robotarmyllc/light-play/media/poster-1.png

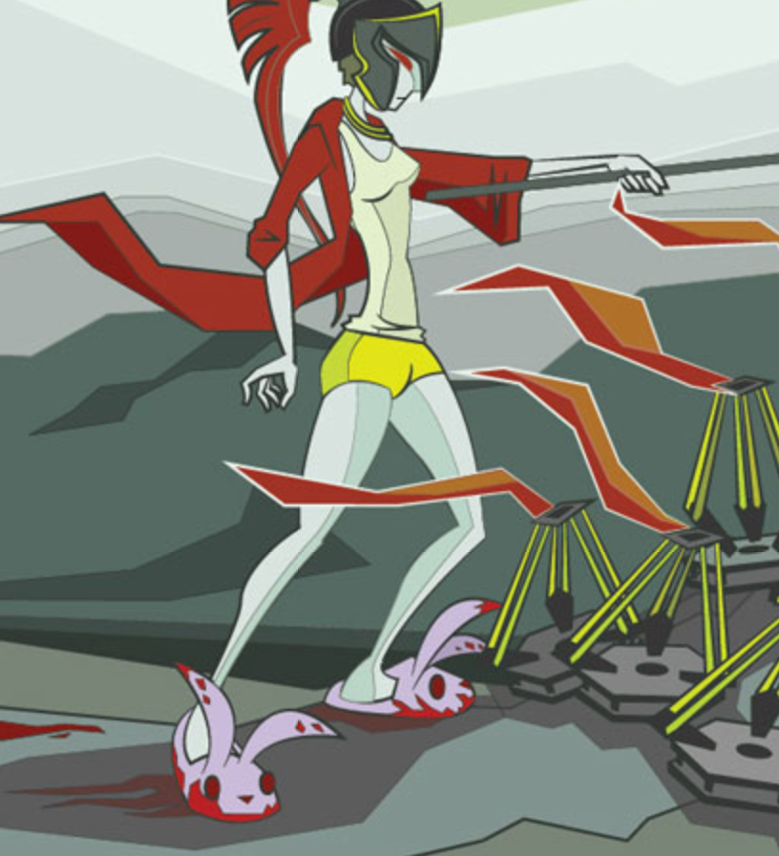
media/poster-1.png
