robotarmyllc/light-play/hardware/kit/kit-parts-images/IMG_5173.jpg

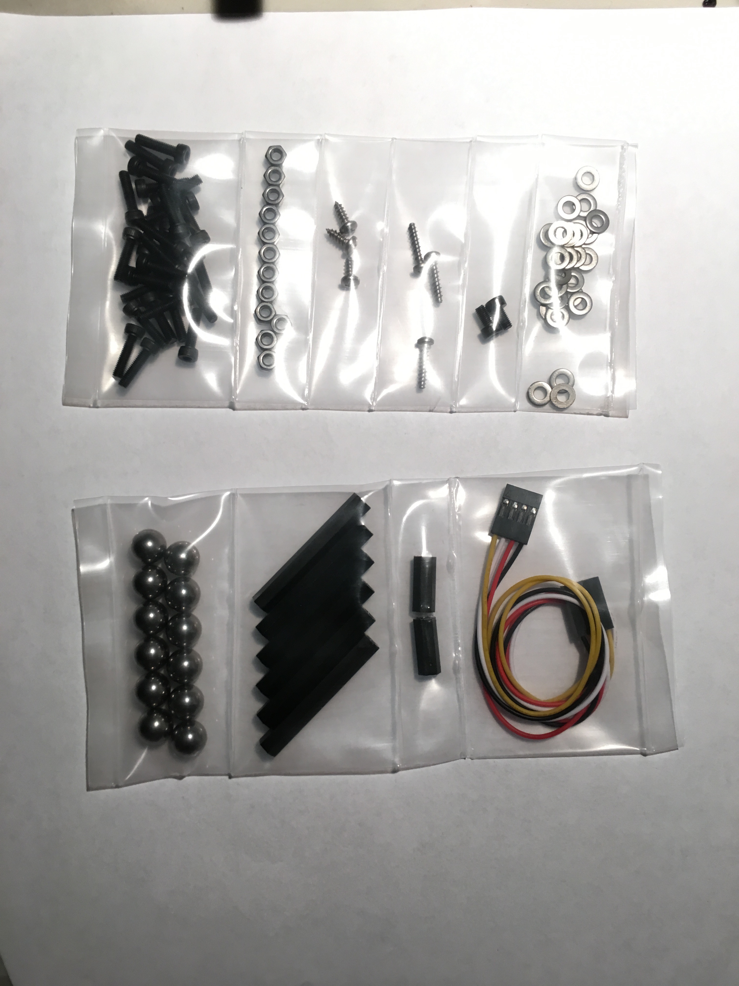
hardware/kit/kit-parts-images/IMG_5173.jpg
