robotarmyllc/light-play/README.md

# light-play
All files related to the Light Play (2013) delta robot project.
