robotarmyllc/light-play/hardware/brain-board/documents/RevB-RevC-Notes.txt

Rev B --> Rev C

Calculate size of cap to run uC at 50mA for 100mS

[DONE] Power diode

[DONE] Remove one of the I2C
[DONE] Rename I2c  --> I/O  (4-pin)

[DONE] LED resistors -->  220

[DONE] More Bypass Caps.    0.01uF,   1000uf?

[DONE] Rotate SPI header

[NOT-DO] Two 470uF versus one 1000uF size on board?

[DONE] Change Serial 6P header to Vert.

[DONE] Better marking on header pin 1.

[DONE] RTS jumper for serial

[ADDED] Test whether 10uF on reset line can make Arduino programming still work.
