robotarmyllc/light-play/mechanical/acrylic-base/RS-Fab/Lower.pdf

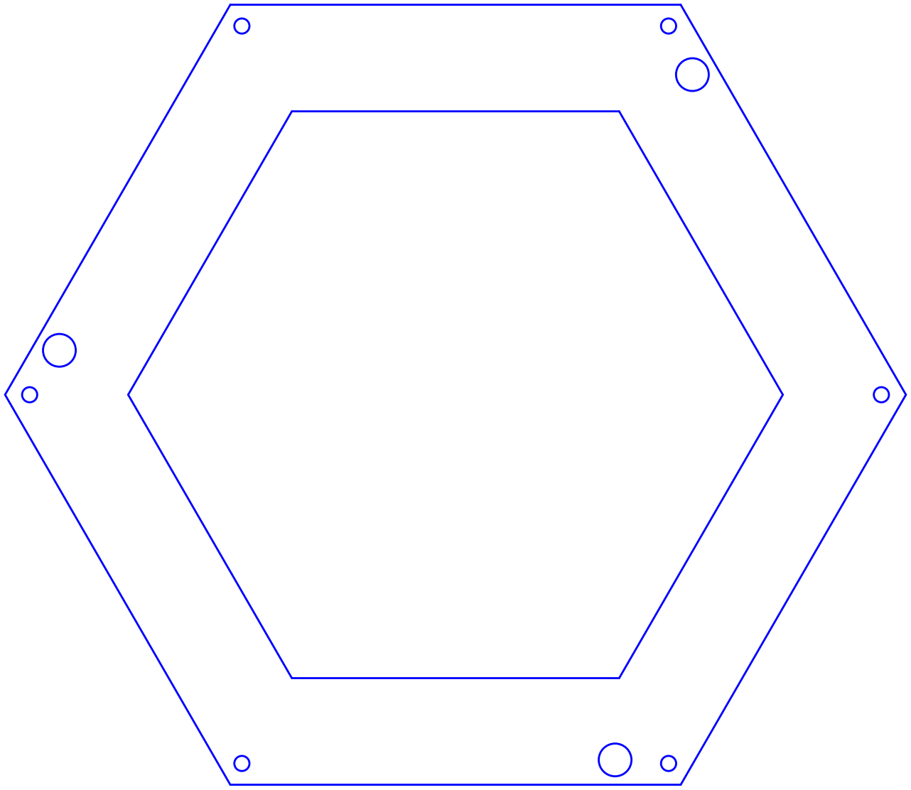
[picture p3: figure]
