robotarmyllc/light-play/mechanical/acrylic-base/RS-Fab/Upper.pdf

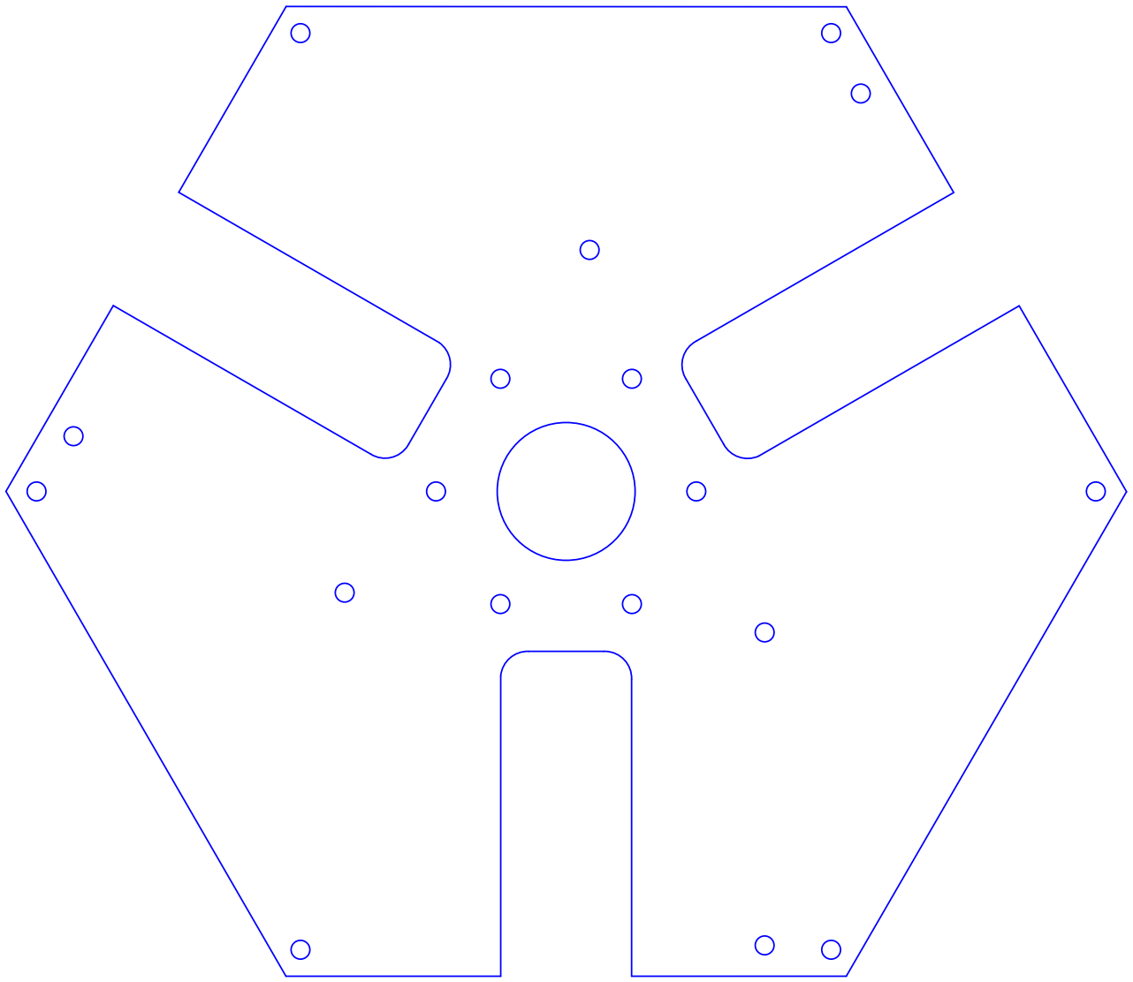
[picture p4: figure]
