robotarmyllc/light-play/hardware/kit/led-pcb/data-sheets/PLCC-6.jpg

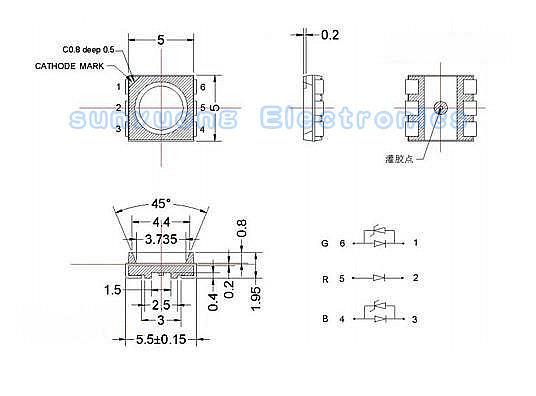
hardware/kit/led-pcb/data-sheets/PLCC-6.jpg
