robotarmyllc/light-play/media/deltaFLYER-01.png

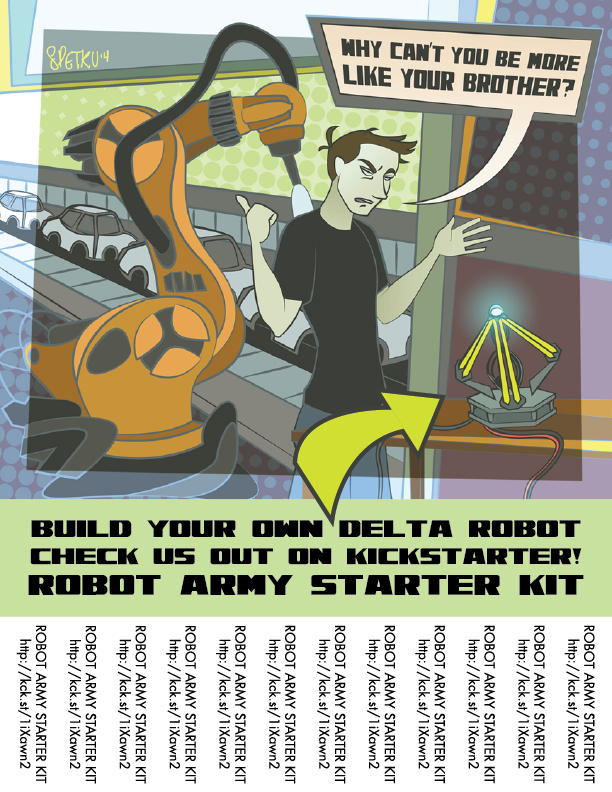
media/deltaFLYER-01.png
