robotarmyllc/light-play/media/kickstarter-1-day-left.png

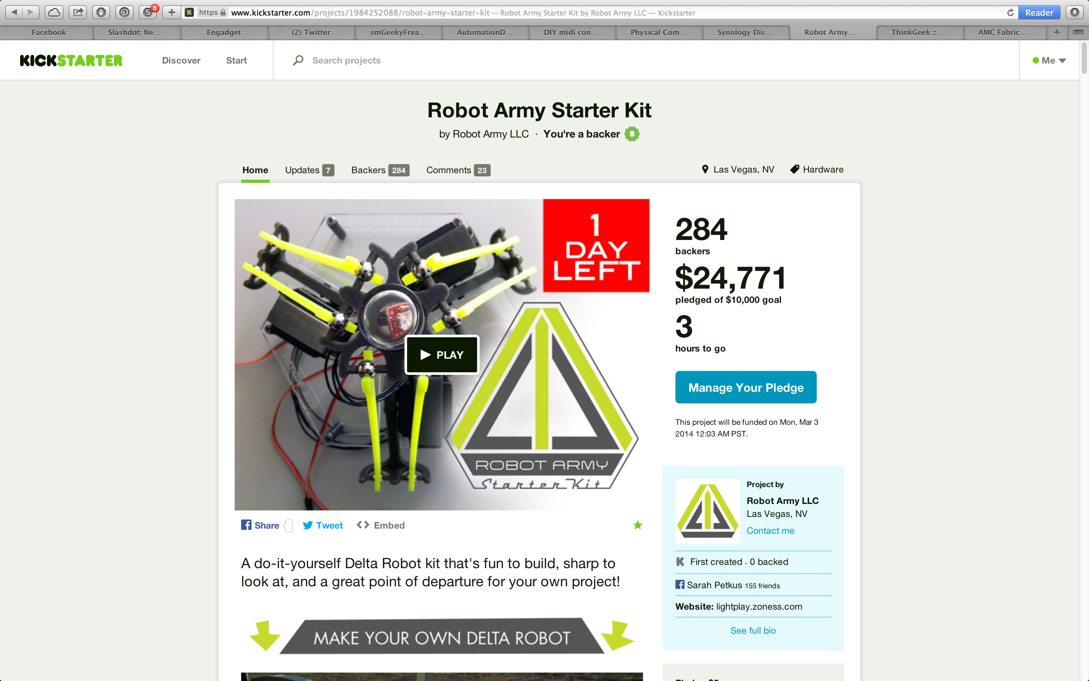
media/kickstarter-1-day-left.png
