robotarmyllc/light-play/media/kickstarter-4-days-left.png

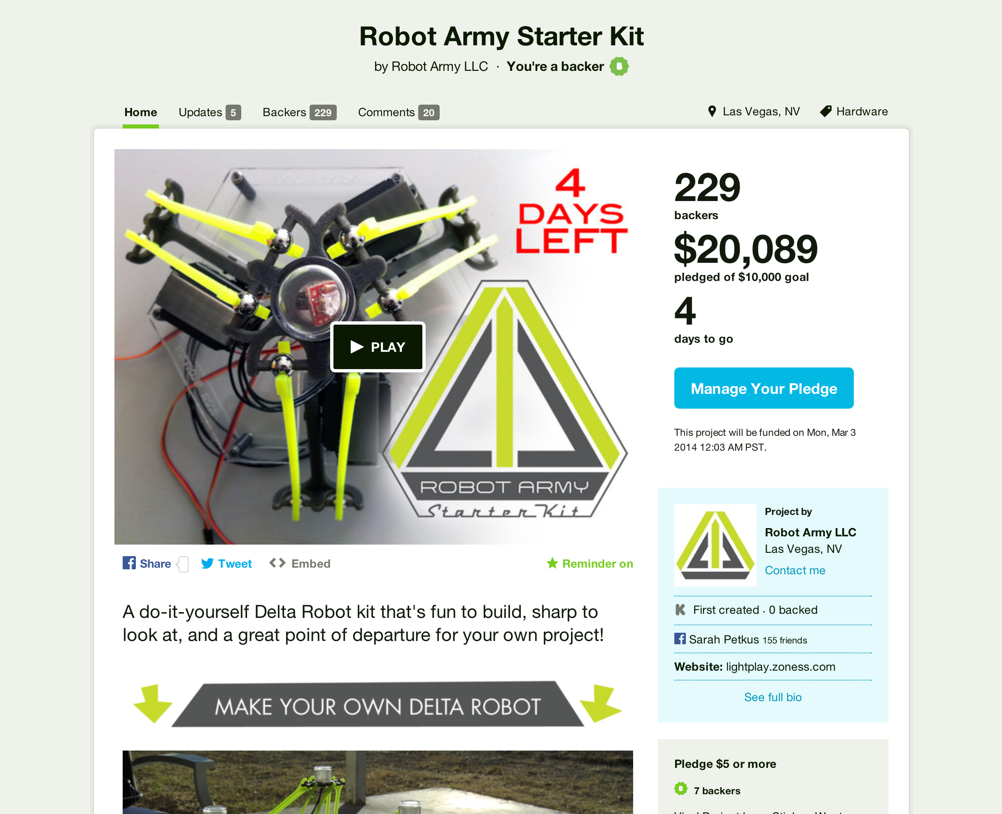
media/kickstarter-4-days-left.png
