robotarmyllc/light-play/software/Flow/Robot/src/com/robotarmy/flow/widget/colorpicker.png

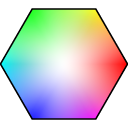
software/Flow/Robot/src/com/robotarmy/flow/widget/colorpicker.png
