robotarmyllc/light-play/hardware/kit/RobotArmy-Kit-BOM.ods

Sheet: Kit Level
Bill of Materials - Kit Level
QTY | ITEM | DESC | COST | EXT COST | HAVE | TO BUY | SOURCE
3 | HD-3001HB | Servo | $8.00 | $24.00 | 8 | 60 | Pololu
1 | BASE PAIR | Acrylic Base Set | $6.00 | $6.00 | 45 | 0 | RS Fab
1 | Screw Pack | Hardware, Screws | $3.39 | $3.39 | 3 | 20 | In House
1 | Ball Pack | Hardware, Balls, Spacers | $1.74 | $1.74 | 0 | 20 | In House
1 | Circuit Pack | PCBs, LED + MainBoard | $14.25 | $14.25 | ? |  | In House
1 | Plastics | Plastic Pieces | $3.20 | $3.20 | ? | 20 | In House
1 | Instruction Sheet | Instruction Card | $0.10 | $0.10 |  | 20 | In House
1 | Battery | Battery Box | $2.00 | $2.00 |  | 20 | In House
 |  |  | Total Cost: | $54.68

Sheet: Screw Pack
Screw Pack
 |  |  |  |  |  | 20
QTY | ITEM | DESC | COST | EXT COST | HAVE | NEED | TO BUY | SOURCE
3 |  | #4 x 1/2” Tap Screw | $0.060 | $0.180 | 80 | 60 | -20 | McMaster 97975A115
26 |  | M3 x 12 | $0.080 | $2.080 | 0 | 520 | 520 | McMaster 91290A117
2 |  | M3 x 6 | $0.080 | $0.160 | 0 | 40 | 40 | McMaster 91290A111
12 |  | M3 Nut | $0.015 | $0.180 | 0 | 240 | 240 | McMaster 90591A121
26 |  | M3 Washer | $0.017 | $0.442 | 0 | 520 | 520 | McMaster 91166A210
3 |  | #4 x 5/16” Pan | $0.050 | $0.150 | 0 | 60 | 60 | McMaster 92470A109
1 |  | 2.5mm Allen Wrench | $0.200 | $0.200 | 0 | 20 | 20 | McMaster 7289A13
 |  |  | Total Cost: | 3.392

Sheet: Ball Pack
Ball Pack
 |  |  |  |  |  | 20
QTY | ITEM | DESC | COST | EXT COST | HAVE | NEED | TO BUY | SOURCE
12 |  | 3/8 Ball Bearing | $0.03 | $0.30 | 0 | 240 | 240 | McMaster 96455K54
6 |  | M3 x 40 Spacer | $0.09 | $0.54 | 450 | 120 | -330 | Ali Express
2 |  | M3 x 15 Spacer | $0.20 | $0.40 | 100 | 40 | -60 | Ali Express
1 |  | 4-pin Wire Harness | $0.50 | $0.50 | 20 | 20 | 0 | Ali Express
 |  |  | Total Cost: | $1.74

Sheet: Circuit Pack
Circuit Pack – Main Board and LED Board
 |  |  |  |  |  | 20
QTY | ITEM | DESC | COST | EXT COST | HAVE | NEED | TO BUY | SOURCE
1 | Brain | Brain PCB Assy. | $13.25 | $13.25 | 20 | 20 | 0
1 | LED | LED PCB Assy | $1.00 | $1.00 | 5 | 20 | 15
 |  |  | Total Cost: | $14.25

Sheet: PlasticPack
Plastic Pack – Plastic Items
 |  |  |  |  |  | 20
QTY | ITEM | DESC | COST | EXT COST | HAVE | NEED | TO BUY | SOURCE
3 | Paddle | Grey Paddle | $0.25 | $0.75 | 0 | 60 | 60
6 | Arm | Yellow Arm | $0.25 | $1.50 | 0 | 120 | 120
1 | Effector | Grey Effector | $0.25 | $0.25 | 0 | 20 | 20
6 | ServoMount | Grey Servo Mount | $0.10 | $0.60 | 0 | 120 | 120
1 | Dome | LED Dome | $0.10 | $0.10 | 500 | 20 | -480 | Vending Supply
 |  |  | Total Cost: | $3.20
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
