robotarmyllc/light-play/hardware/dmx-cat5-board/documents/bom.ods

RS-485 |  | Rev. B
Part | Value | Device | Package | 100 | 1000 | 2000 | Inventory | Ordered
FAB | RS-485 FAB |  |  | $1.700 | $1.200 | $0.500 | 21 | 04/11/14 | OSH
C1 | 0.1uF | CAPACITOR0603 | 603 | $0.080 | $0.040 | $0.013 | Y
J1 | 03P_ED1515-ND | 03P_ED1515-ND | TB35-03 | $0.200 | $0.180 | $0.250 | Y
J2 | 03P_ED1515-ND | 03P_ED1515-ND | TB35-03 | $0.200 | $0.180 | $0.250 | Y
J3 | Header, 6P, F | FE06-1 | FE06 | $0.100 | $0.060 | $0.020 | 200 | 04/11/14 | Tayda
R1 | 120 | RESISTOR1206 | 1206 | $0.050 | $0.010 | $0.003 | 200
R2 | 100 | RESISTOR1206 | 1206 | $0.050 | $0.010 | $0.003 | 200
R3 | 4.7K | RESISTOR0603 | 603 | $0.003 | $0.003 | $0.003 | Y
U3 | SN65176B | RS485_TRANSCEIVERSO8 | SOP08 | $0.800 | $0.500 | $0.450 |  |  | Mouser
 |  |  | Parts: | $3.18 | $2.18 | $1.49
 |  |  | Procurement: | $0.48 | $0.33 | $0.15
N Parts: | 9 |  | Assembly: | $1.98 | $1.62 | $1.44
 |  |  | Prog. & Test: | $1.00 | $0.75 | $0.50
 |  |  | Total: | $6.64 | $4.88 | $3.58
