robotarmyllc/light-play/hardware/dmx-a-board/documents/dmx-a-rev-b-bom.ods

DMX-A Rev.B Bill of Materials
Part | Value | Package | Description | HAVE?
C1 | 0.1uF | 603 | Capacitor CAP | Y
C2 | 0.1uF | 603 | Capacitor CAP | Y
J1 | FCI 54602 | FCI_54602 | RJ45 Unshielded | 27
J2 | FCI 54602 | FCI_54602 | RJ45 Unshielded | 27
J3 | Molex 53015-0410 | RA | Molex MicroBlade 4P | 100
J4 | Molex 53015-0310 | RA | Molex MicroBlade 3P | 100
J5 | 5569-02XX | RA | MiniFit Jr. 2-pin | NEED
R1 | 100 | 1206 | Resistor | Y
U1 | 74HC2G34GV | TSOP-6 | 74HC2G34 - Dual Driver | Y
U2 | ST485 | SOP08 | RS485 TRANSEIVER | Y
