robotarmyllc/light-play/hardware/brain-board/documents/BOM.ods

BrainPCB | Rev. E
Part | Value | Device | Package | 500 | 1000 | 2000 | Inventory | Ordered
FAB | Brain_FAB |  |  | $1.700 | $1.500 | $0.980 | 20
ADDR | CTS_219-04MST | Dip-switch, SMD | CTS_4P_GULLWING | $0.270 | $0.270 | $0.270 | 400
C1 | 0.1uF | CAPACITOR0603 | 603 | $0.013 | $0.013 | $0.013 | Y
C2 | 0.1uF | CAPACITOR0603 | 603 | $0.013 | $0.013 | $0.013 | y
C3 | 0.1uF | CAPACITOR0603 | 603 | $0.013 | $0.013 | $0.013 | y
C4 | 0.01uF | CAPACITOR0603 | 603 | $0.013 | $0.013 | $0.013 | y
C5 | 10uF | CAPACITOR0805 | 805 | $0.013 | $0.013 | $0.013 | y
C6 | 1000uF/6.3V NS | CAPACITOR_POL-ALUM-SMT-6.3 | 6.3MM | $0.013 | $0.013 | $0.013 | y
D1 | Toshiba 1SS416CT | SCHOTTKYTOSHIBA_CST2 | CST2 | $0.040 | $0.040 | $0.040 | y
D13 | YEL | SMT0603 | SMD_0603 | $0.100 | $0.100 | $0.100 | y
CR1 | 16MHz Resonator | RESONATOR MURATA-CSTCE | MURATA-CSTCE | $0.310 | $0.270 | $0.250 | y | 04/10/14
ISCP | Header, 3x2P, VT | MA03-2 | MA03-2 | $0.040 | $0.040 | $0.040 | Y
SERIAL | Header, 6P, VT | MA06-1 | MA06-1 | $0.050 | $0.015 | $0.015 | Y
LEDS | Header, 4P, VT | MA04-1 | MA04-1 | $0.020 | $0.020 | $0.020 | Y
JMP1 | Header, 2P, VT | MA02-1 | MA02-1 | $0.020 | $0.020 | $0.020 | Y
JMP2 | Header, 2P, VT | MA02-1 | MA02-1 | $0.020 | $0.020 | $0.020 | Y
PWR | Header, 3P | MA03-1 | MA03-1 | $0.020 | $0.020 | $0.020 | Y
SV1 | Header, 3P, VT | MA03-1 | MA03-1 | $0.015 | $0.015 | $0.015 | y
SV2 | Header, 3P, VT | MA03-1 | MA03-1 | $0.015 | $0.015 | $0.015 | y
SV3 | Header, 3P, VT | MA03-1 | MA03-1 | $0.015 | $0.015 | $0.015 | y
Q1 | 2N7002 | SOT23_2N7002 | SOT-23 | $0.080 | $0.070 | $0.060 | y | 04/10/14
R1 | 10K | RESISTOR0603 | 603 | $0.003 | $0.003 | $0.003 | Y
R2 | 10K | RESISTOR0603 | 603 | $0.003 | $0.003 | $0.003 | Y
R3 | CTS 741X163821JP | RESNET_0402_INDIV_X8 | RESNET_0402_X8 | $0.100 | $0.080 | $0.061 | y | 04/10/14
RESET | Switch, Push, SMD | PUSHBTN-SP-MOM-4PINB3SN | B3SN | $0.100 | $0.100 | $0.100 | y
U1 | ATmega328P-AU | ATMEGA328 | TQFP-32-08 | $1.620 | $1.620 | $1.620 | y | 21 - 04/10/2014 | Need 400
 |  |  | Parts: | $4.62 | $4.31 | $3.75
 |  |  | Procurement: | $0.69 | $0.65 | $0.37
N Parts: | 27 |  | Assembly: | $5.94 | $4.86 | $4.32
 |  |  | Prog. & Test: | $2.00 | $1.50 | $1.00
 |  |  | Total: | $13.25 | $11.32 | $9.44
