robotarmyllc/light-play/hardware/kit/kit-parts-images/IMG_5172.jpg

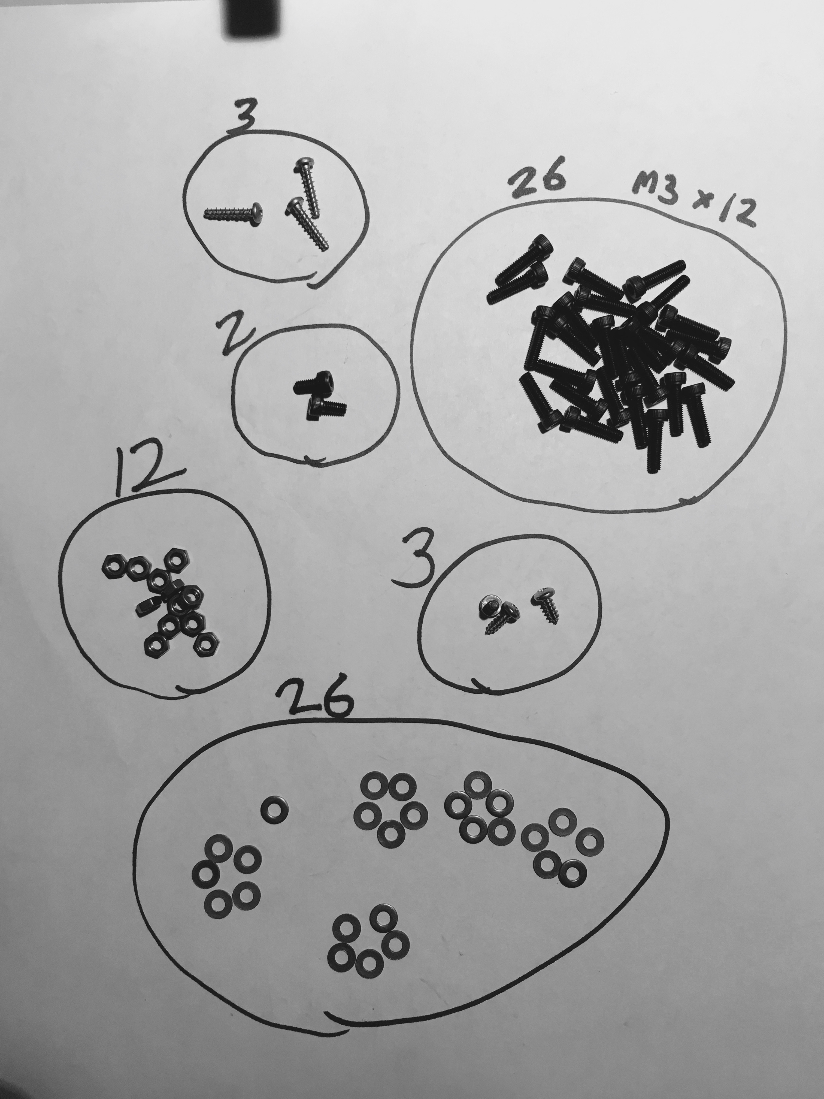
hardware/kit/kit-parts-images/IMG_5172.jpg
