robotarmyllc/light-play/hardware/kit/kit-parts-images/IMG_5174.jpg

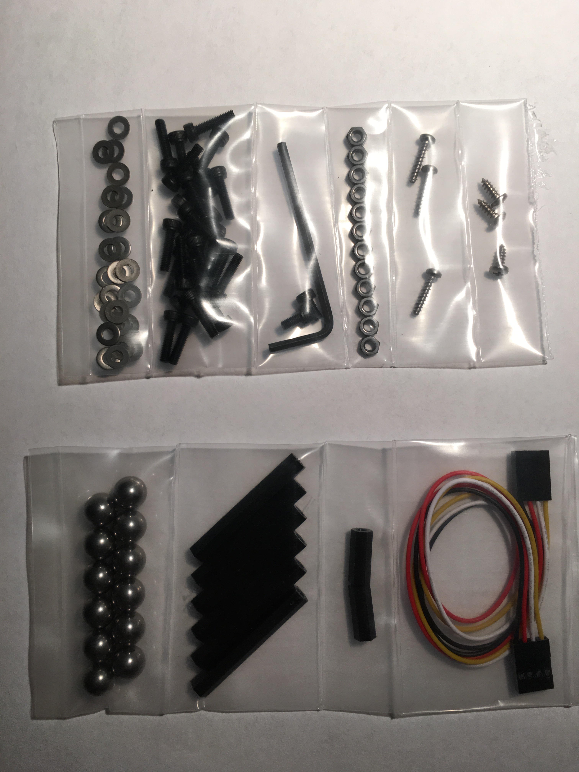
hardware/kit/kit-parts-images/IMG_5174.jpg
