robotarmyllc/light-play/events/MakerFaire2016/Pedastal/Pedastal01-lid.stl

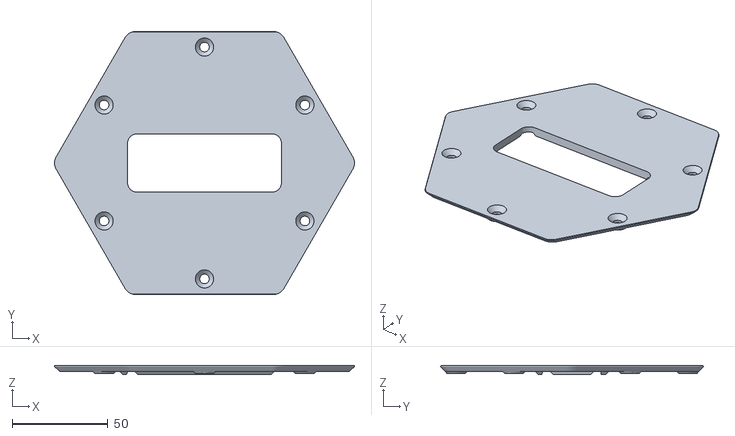
[picture p12: CAD file, 2022-09-13]
events/MakerFaire2016/Pedastal/Pedastal01-lid.stl
156.9 x 137.6 x 4.50
