robotarmyllc/light-play/hardware/black-light-stands/BlackLightStand.stl

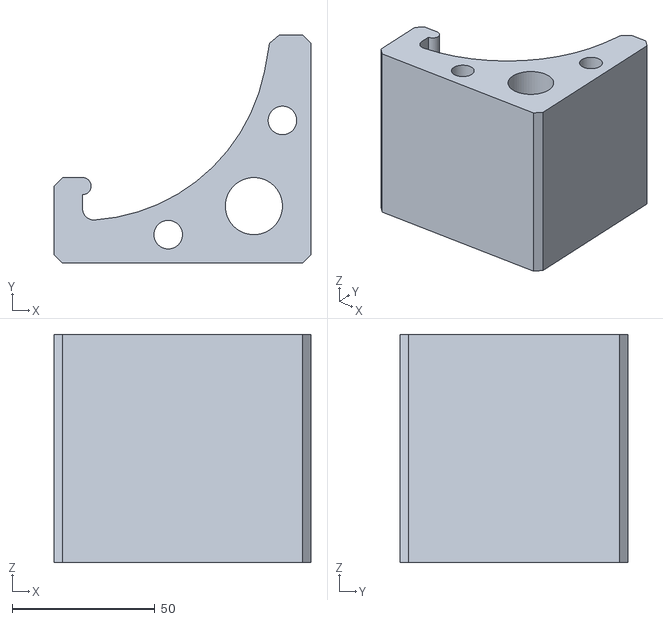
[picture p13: CAD file, 2022-09-13]
hardware/black-light-stands/BlackLightStand.stl
90.0 x 80.0 x 80.0
