robotarmyllc/light-play/mechanical/2013-12-14_STL_files/armX.stl

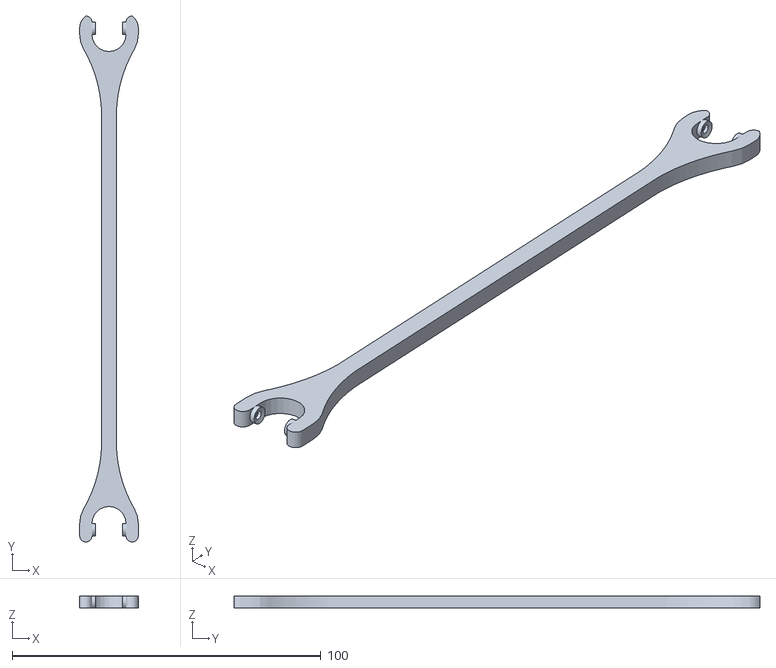
[picture p14: CAD file, 2022-09-13]
mechanical/2013-12-14_STL_files/armX.stl
19.0 x 170.4 x 4.00
