robotarmyllc/light-play/mechanical/acrylic-base/RobotArmy-4x8-sheet.dxf

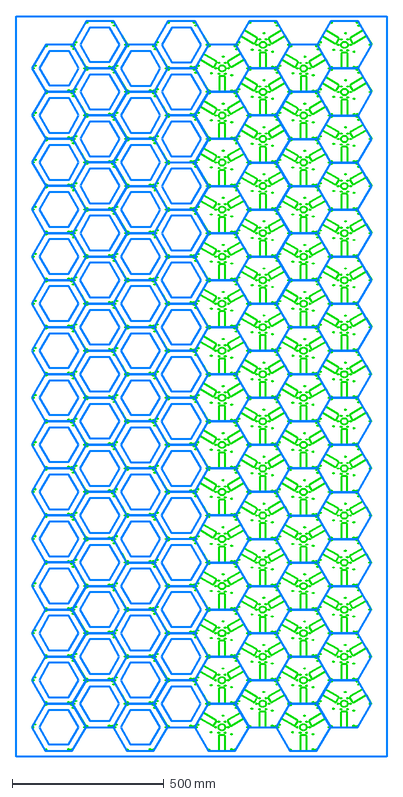
[picture p15: CAD file, 2022-09-13]
mechanical/acrylic-base/RobotArmy-4x8-sheet.dxf
1219.2 x 2438.4 mm
