robotarmyllc/light-play/mechanical/acrylic-base/RS-Fab/RobotArmy-Upper.dxf

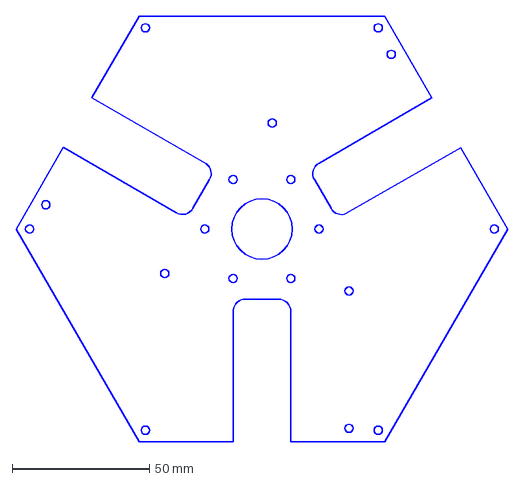
[picture p16: CAD file, 2022-09-13]
mechanical/acrylic-base/RS-Fab/RobotArmy-Upper.dxf
178.9 x 155.0 mm
