robotarmyllc/light-play/mechanical/Arm/Arm Curved-2019 v2.stl

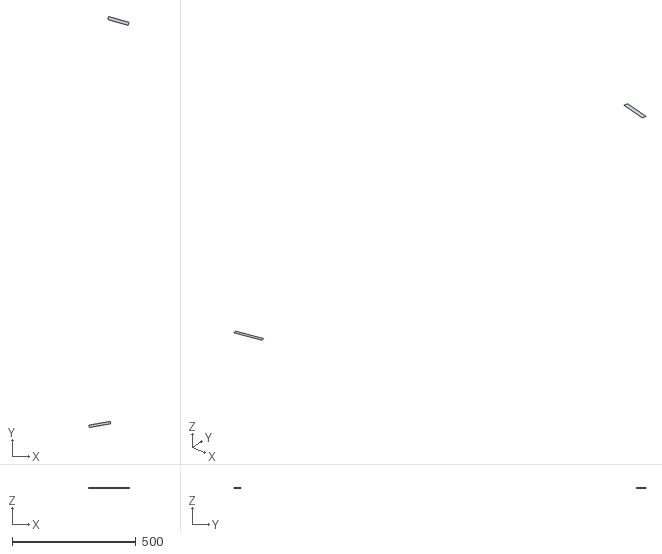
[picture p17: CAD file, 2022-09-13]
mechanical/Arm/Arm Curved-2019 v2.stl
161.8 x 1658.3 x 0.2
