robotarmyllc/light-play/mechanical/final-3d-print-stl-for-kits/armCurved.stl

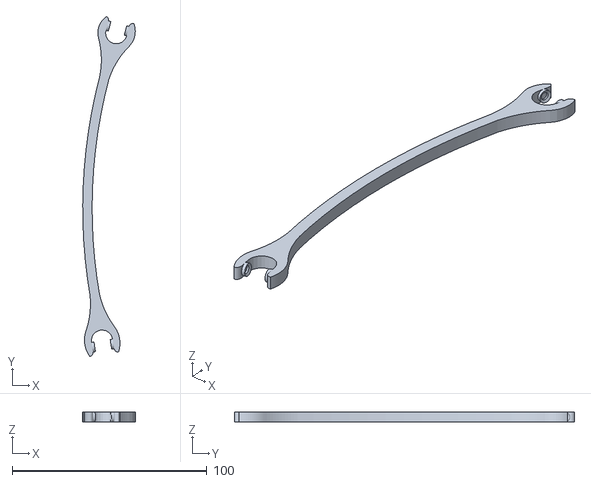
[picture p18: CAD file, 2022-09-13]
mechanical/final-3d-print-stl-for-kits/armCurved.stl
27.0 x 174.7 x 5.00
