robotarmyllc/light-play/mechanical/gallery-palettes/Palette-ABS/Original-DXF/comb_3.dxf

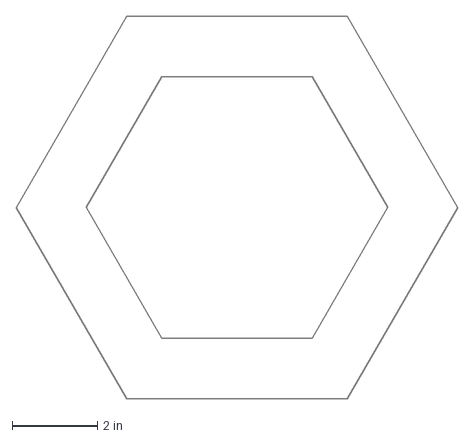
[picture p19: CAD file, 2022-09-13]
mechanical/gallery-palettes/Palette-ABS/Original-DXF/comb_3.dxf
10.4 x 9.00 in
