robotarmyllc/light-play/mechanical/gallery-palettes/Palette3/DMX-A-bracket_v02.stl

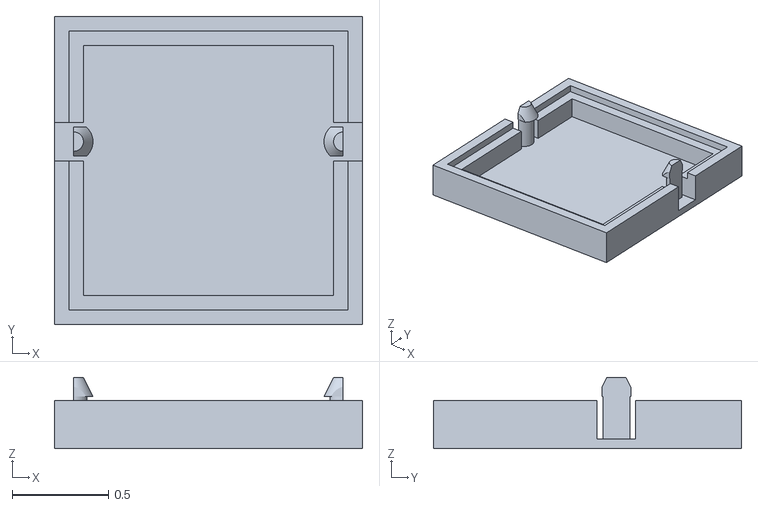
[picture p20: CAD file, 2022-09-13]
mechanical/gallery-palettes/Palette3/DMX-A-bracket_v02.stl
1.60 x 1.60 x 0.37
