robotarmyllc/light-play/mechanical/misc-3D/ball-cap.stl

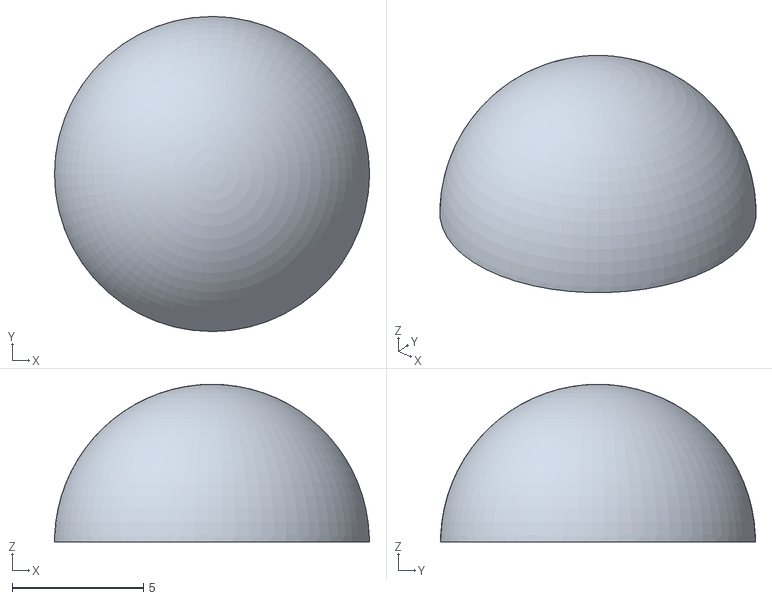
[picture p21: CAD file, 2022-09-13]
mechanical/misc-3D/ball-cap.stl
12.0 x 12.0 x 6.00
