robotarmyllc/light-play/mechanical/Paddle/paddle-latest.stl

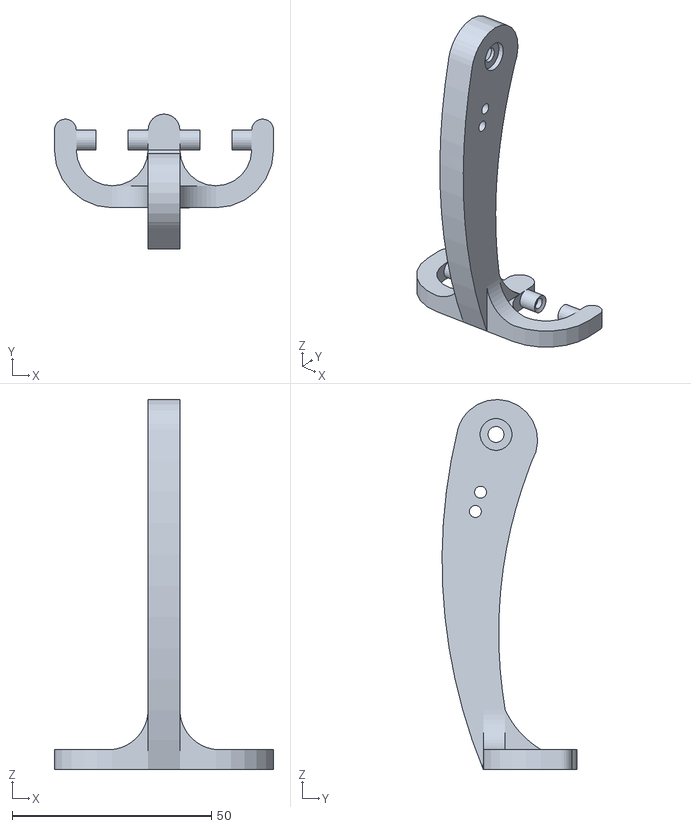
[picture p22: CAD file, 2022-09-13]
mechanical/Paddle/paddle-latest.stl
55.0 x 33.8 x 92.8
