robotarmyllc/light-play/mechanical/Spacer/spacer_36mm.stl

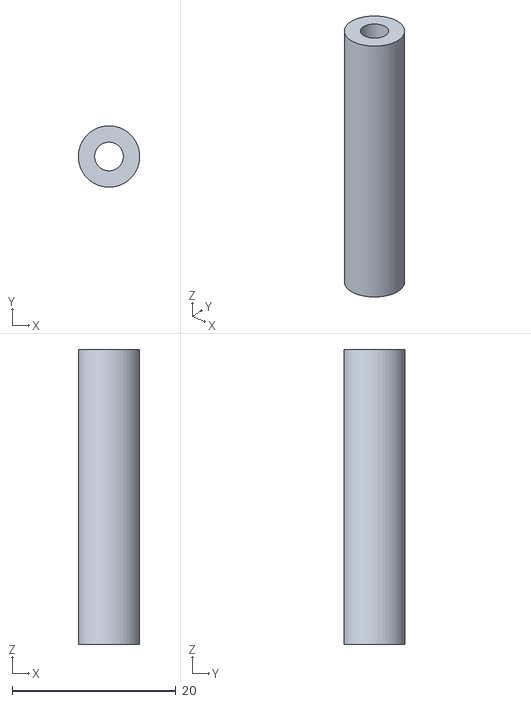
[picture p23: CAD file, 2022-09-13]
mechanical/Spacer/spacer_36mm.stl
7.50 x 7.50 x 36.0
