robotarmyllc/light-play/events/MakerFaire2016/Pedastal/P-test1.stl

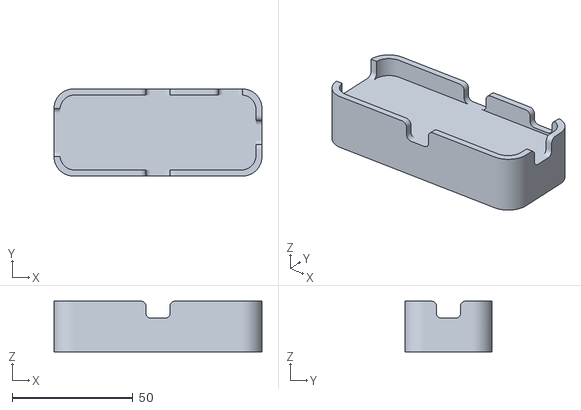
[picture p24: CAD file, 2022-09-13]
events/MakerFaire2016/Pedastal/P-test1.stl
86.0 x 36.0 x 21.0
