robotarmyllc/light-play/mechanical/2013-12-14_STL_files/effectorX.stl

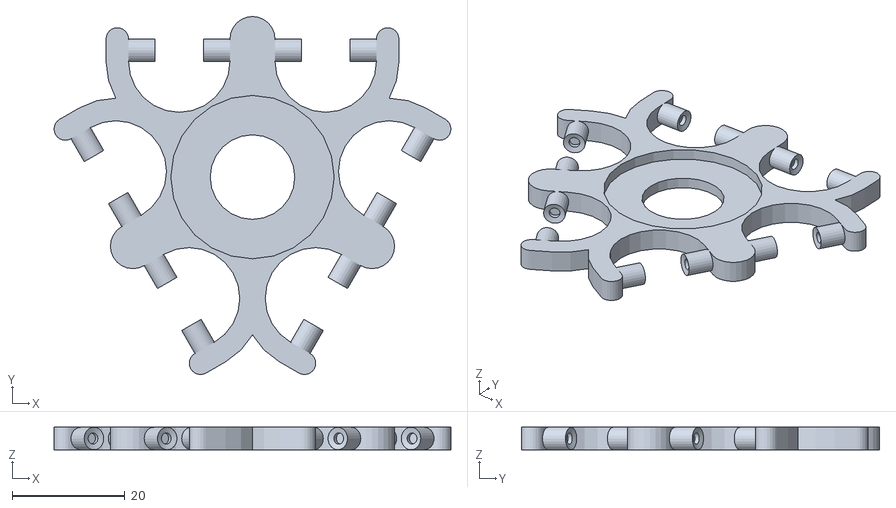
[picture p25: CAD file, 2022-09-13]
mechanical/2013-12-14_STL_files/effectorX.stl
70.4 x 63.5 x 4.00
