robotarmyllc/light-play/mechanical/acrylic-base/RS-Fab/RobotArmy-Lower.dxf

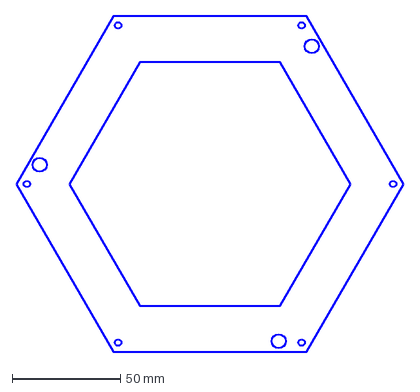
[picture p26: CAD file, 2022-09-13]
mechanical/acrylic-base/RS-Fab/RobotArmy-Lower.dxf
178.9 x 154.9 mm
