robotarmyllc/light-play/mechanical/final-3d-print-stl-for-kits/effector.stl

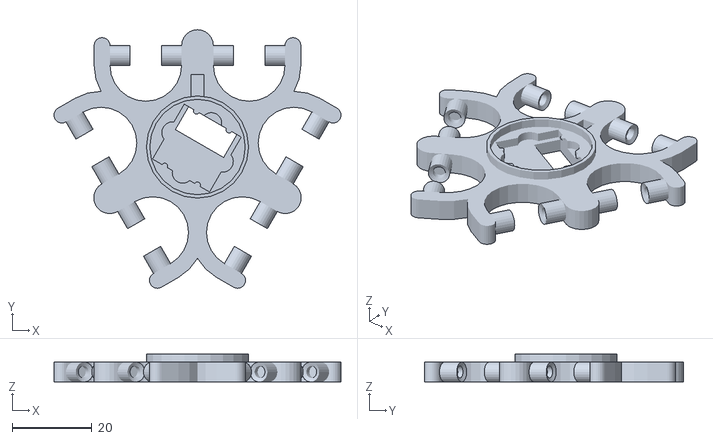
[picture p27: CAD file, 2022-09-13]
mechanical/final-3d-print-stl-for-kits/effector.stl
72.2 x 65.0 x 7.00
