robotarmyllc/light-play/mechanical/gallery-palettes/Palette-ABS/Original-DXF/comb_1.dxf

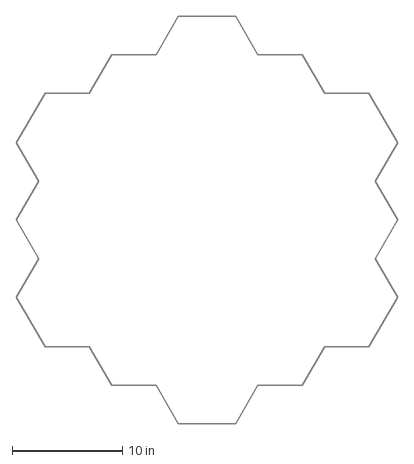
[picture p28: CAD file, 2022-09-13]
mechanical/gallery-palettes/Palette-ABS/Original-DXF/comb_1.dxf
34.6 x 37.0 in
