robotarmyllc/light-play/mechanical/gallery-palettes/Palette-ABS/Quote-DXF/comb_3.dxf

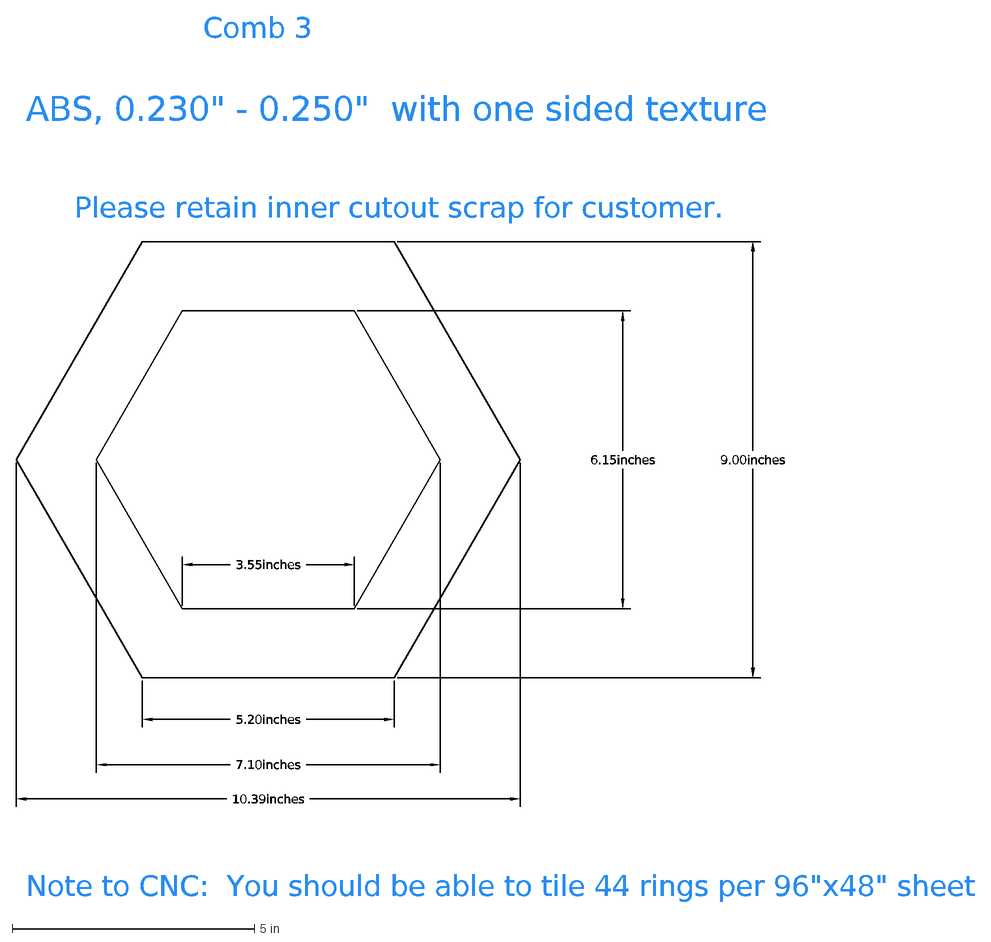
[picture p29: CAD file, 2022-09-13]
mechanical/gallery-palettes/Palette-ABS/Quote-DXF/comb_3.dxf
9.00inches
6.15inches
7.10inches
10.39inches
5.20inches
3.55inches
Comb 3
Please retain inner cutout scrap for customer.
ABS, 0.230" - 0.250" with one sided texture
Note to CNC: You should be able to tile 44 rings per 96"x48" sheet
