robotarmyllc/light-play/mechanical/gallery-palettes/Palette3/AC-Inlet-v01b.stl

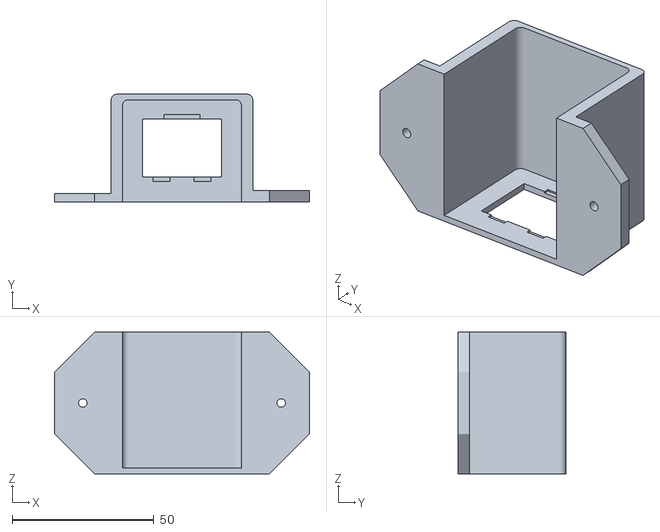
[picture p30: CAD file, 2022-09-13]
mechanical/gallery-palettes/Palette3/AC-Inlet-v01b.stl
90.0 x 38.0 x 50.0
