robotarmyllc/light-play/mechanical/misc-3D/dome1.stl

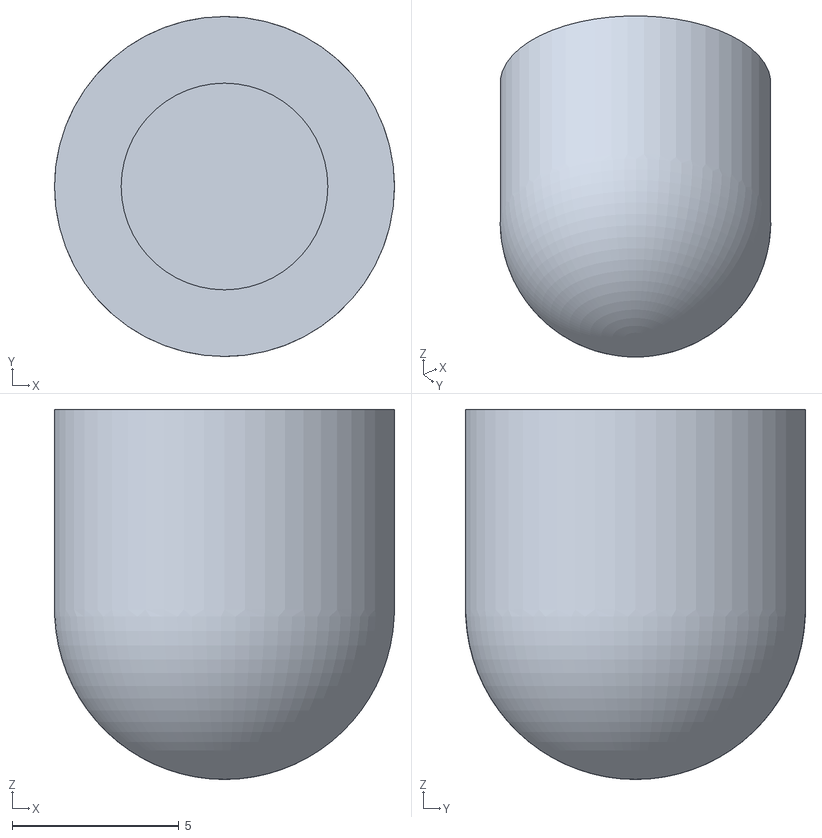
[picture p31: CAD file, 2022-09-13]
mechanical/misc-3D/dome1.stl
10.2 x 10.2 x 11.1
