robotarmyllc/light-play/mechanical/Paddle/anchor.stl

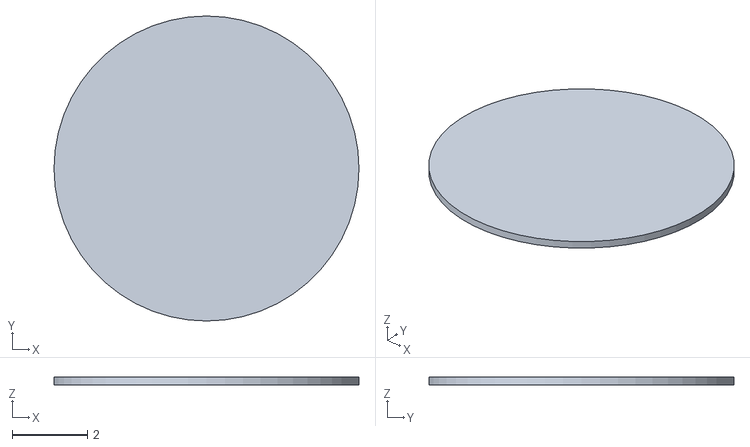
[picture p32: CAD file, 2022-09-13]
mechanical/Paddle/anchor.stl
8.10 x 8.10 x 0.2
