robotarmyllc/light-play/events/MakerFaire2016/Pedastal/Pedastal01.stl

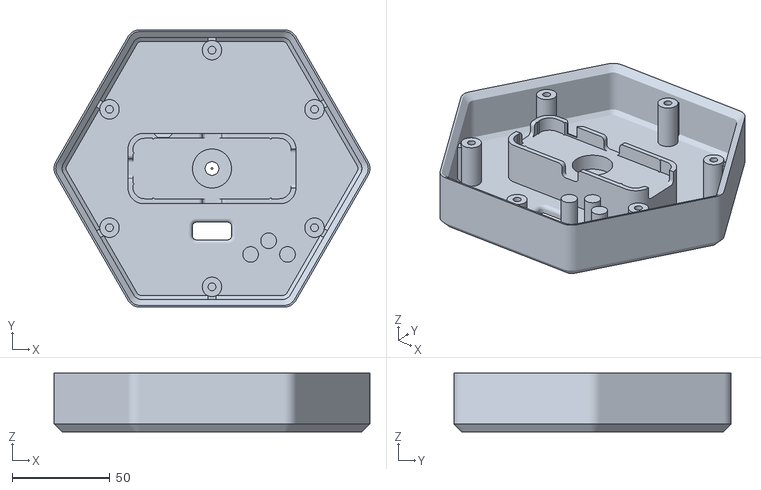
[picture p33: CAD file, 2022-09-13]
events/MakerFaire2016/Pedastal/Pedastal01.stl
161.8 x 142.0 x 30.0
