robotarmyllc/light-play/mechanical/2013-12-14_STL_files/bracketX.stl

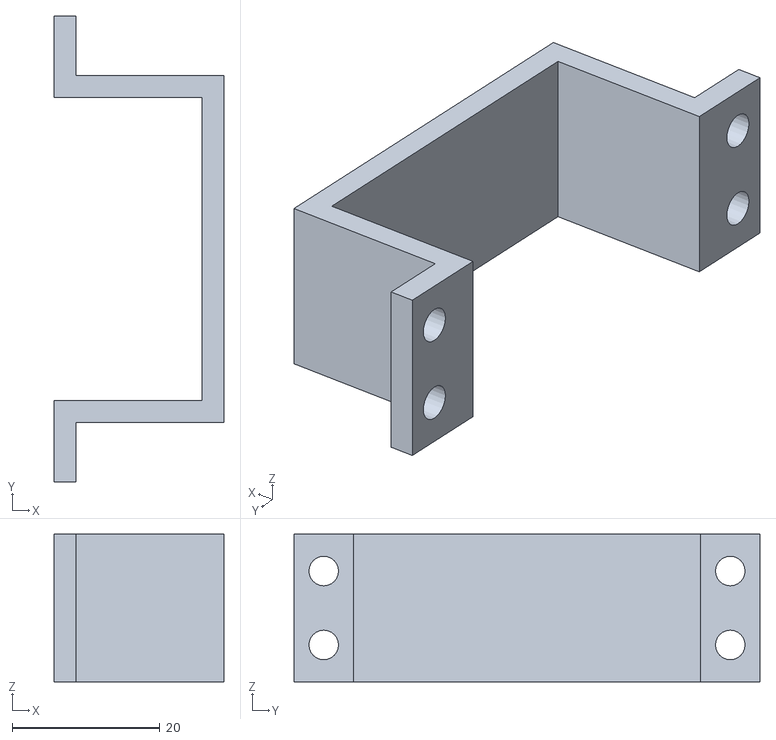
[picture p34: CAD file, 2022-09-13]
mechanical/2013-12-14_STL_files/bracketX.stl
23.0 x 63.0 x 20.0
