robotarmyllc/light-play/mechanical/gallery-palettes/Palette3/board_cover_v03.stl

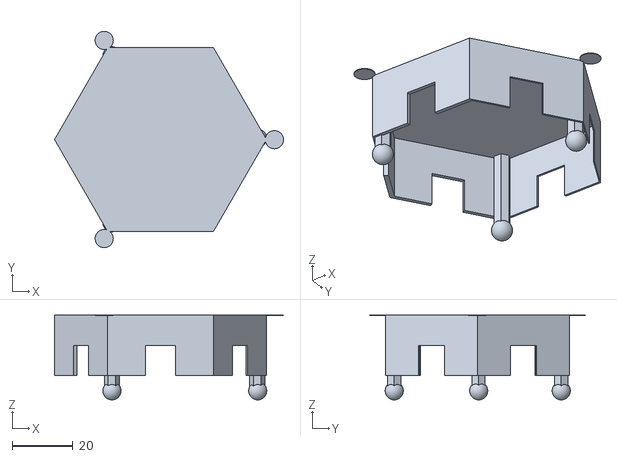
[picture p36: CAD file, 2022-09-13]
mechanical/gallery-palettes/Palette3/board_cover_v03.stl
75.6 x 71.4 x 28.0
