robotarmyllc/light-play/mechanical/Paddle/paddle-160514.stl

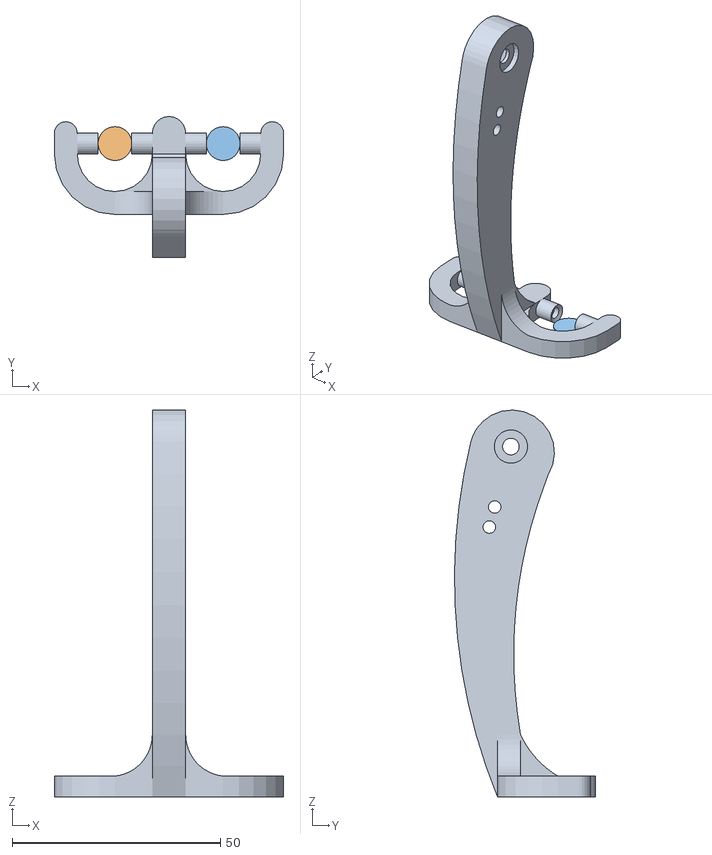
[picture p37: CAD file, 2022-09-13]
mechanical/Paddle/paddle-160514.stl
55.0 x 33.8 x 92.8
