robotarmyllc/light-play/mechanical/2013-12-14_STL_files/paddleX.stl

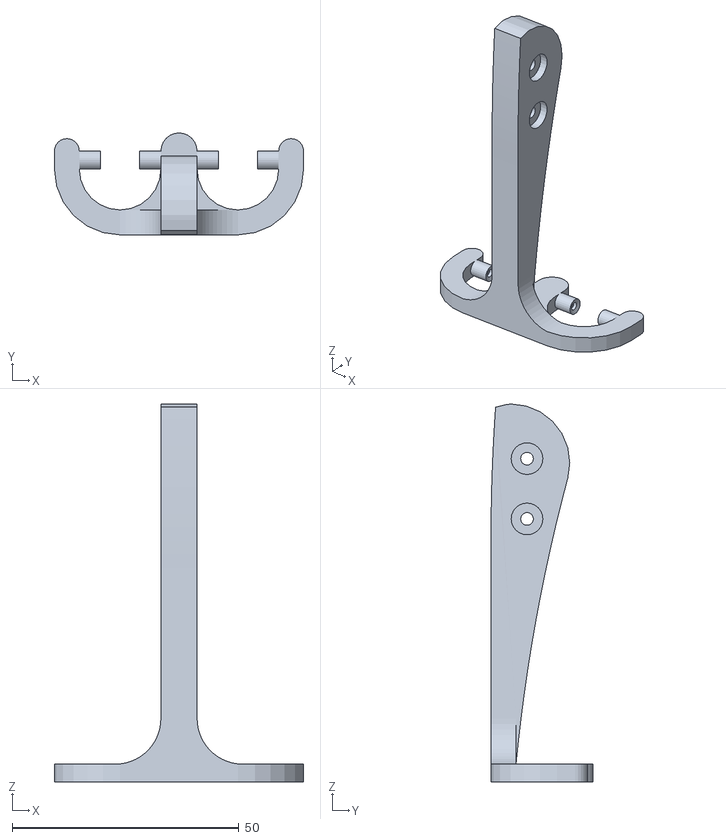
[picture p38: CAD file, 2022-09-13]
mechanical/2013-12-14_STL_files/paddleX.stl
55.0 x 22.5 x 83.4
