robotarmyllc/light-play/mechanical/final-3d-print-stl-for-kits/servo_mount.stl

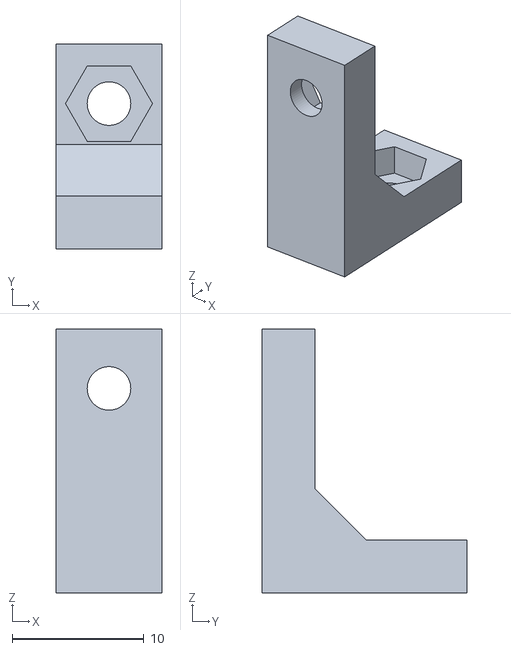
[picture p39: CAD file, 2022-09-13]
mechanical/final-3d-print-stl-for-kits/servo_mount.stl
8.00 x 15.5 x 20.0
