robotarmyllc/light-play/mechanical/2013-12-14_STL_files/spacer34.stl

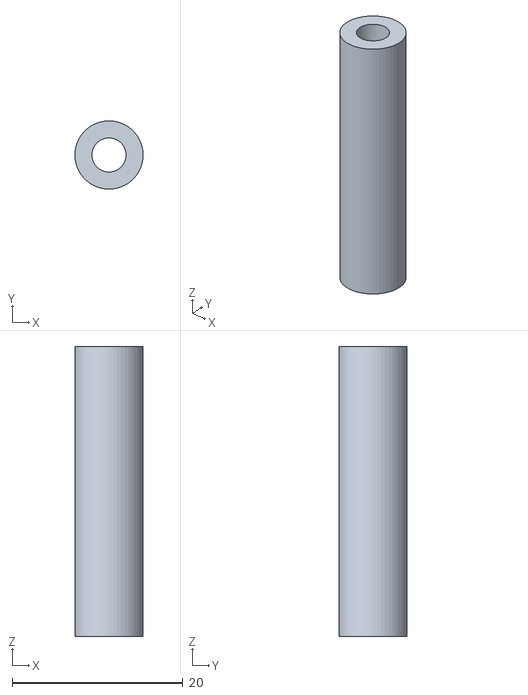
[picture p40: CAD file, 2022-09-13]
mechanical/2013-12-14_STL_files/spacer34.stl
8.00 x 8.00 x 34.0
