robotarmyllc/light-play/mechanical/gallery-palettes/Palette3/Template-PowerSuppy_v01.stl

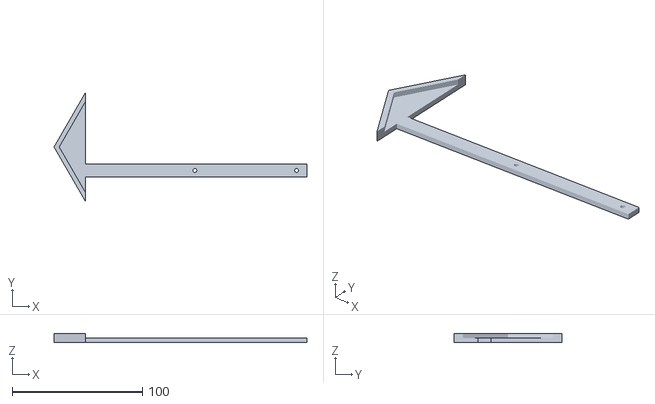
[picture p41: CAD file, 2022-09-13]
mechanical/gallery-palettes/Palette3/Template-PowerSuppy_v01.stl
194.0 x 83.1 x 6.60
