robotarmyllc/light-play/mechanical/2013-12-14_STL_files/spacer.stl

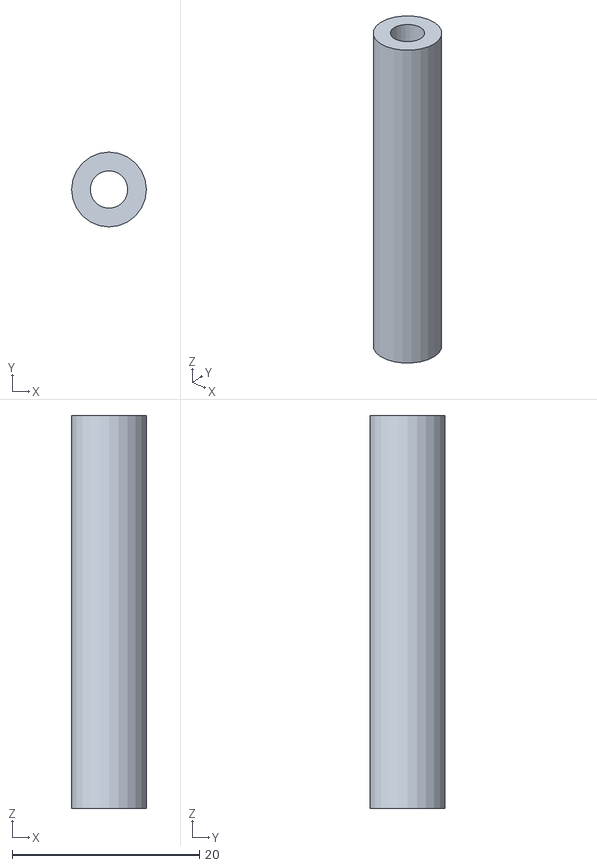
[picture p42: CAD file, 2022-09-13]
mechanical/2013-12-14_STL_files/spacer.stl
8.00 x 8.00 x 42.0
