robotarmyllc/light-play/mechanical/gallery-palettes/Palette3/AC-Inlet-v01.stl

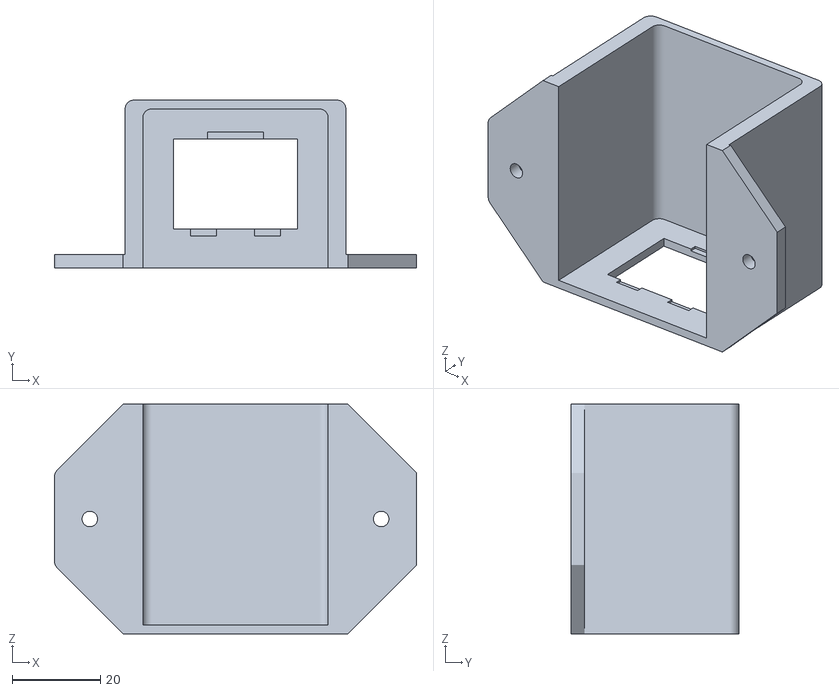
[picture p43: CAD file, 2022-09-13]
mechanical/gallery-palettes/Palette3/AC-Inlet-v01.stl
82.0 x 38.0 x 52.0
