robotarmyllc/light-play/mechanical/gallery-palettes/Palette3/board_cover_v01b.stl

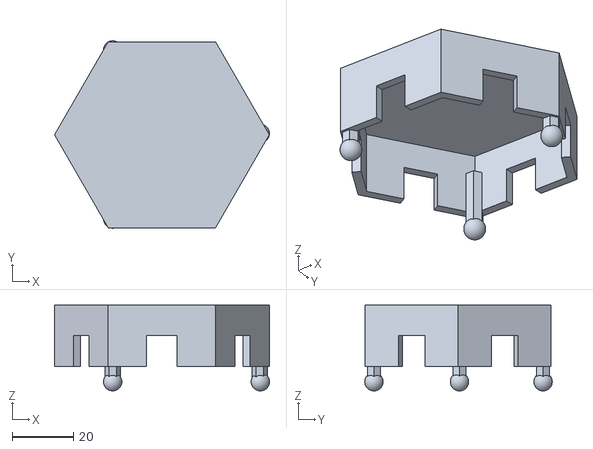
[picture p44: CAD file, 2022-09-13]
mechanical/gallery-palettes/Palette3/board_cover_v01b.stl
70.1 x 61.1 x 28.0
