robotarmyllc/light-play/(list of files, cad)

Other CAD files:
mechanical/gallery-palettes/Palette-ABS/Quote-DXF/comb_1.dxf
mechanical/final-3d-print-stl-for-kits/paddle.stl
mechanical/gallery-palettes/Palette-ABS/Quote-DXF/comb_2.dxf
mechanical/gallery-palettes/Palette3/DMX-A-bracket_v01.stl
mechanical/gallery-palettes/Palette3/board_cover_v01.stl
mechanical/gallery-palettes/Palette3/board_cover_v02.stl
mechanical/older-experimental-stuff/Paddle/paddle.stl
mechanical/older-experimental-stuff/ServoMount/OLD/servo_mount_04.stl
mechanical/older-experimental-stuff/ServoMount/OLD/servo_mount_05.stl
mechanical/older-experimental-stuff/ServoMount/OLD/servo_mount_4oldBase.stl
mechanical/older-experimental-stuff/ServoMount/OLD/servo_mount_4oldBase_B.stl
mechanical/older-experimental-stuff/ServoMount/OLD/servo_mount_4oldBase_mirror.stl
