robotarmyllc/light-play/hardware/dmx-cat5-board/documents/serial-receiver-sch.pdf

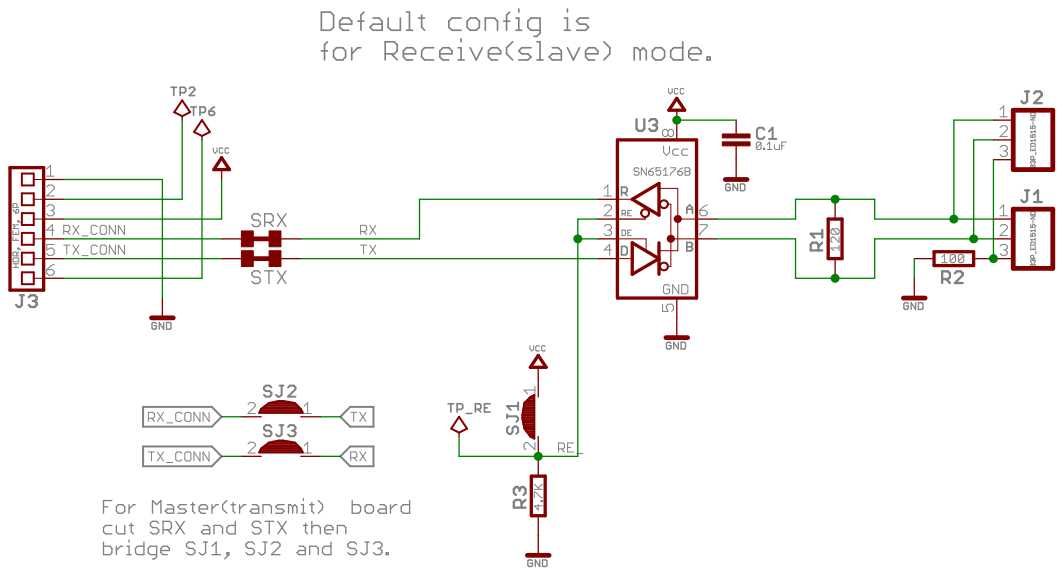
[picture p45: page 1]
