robotarmyllc/light-play/hardware/dmx-b-board/documents/dmx-b-sch.pdf

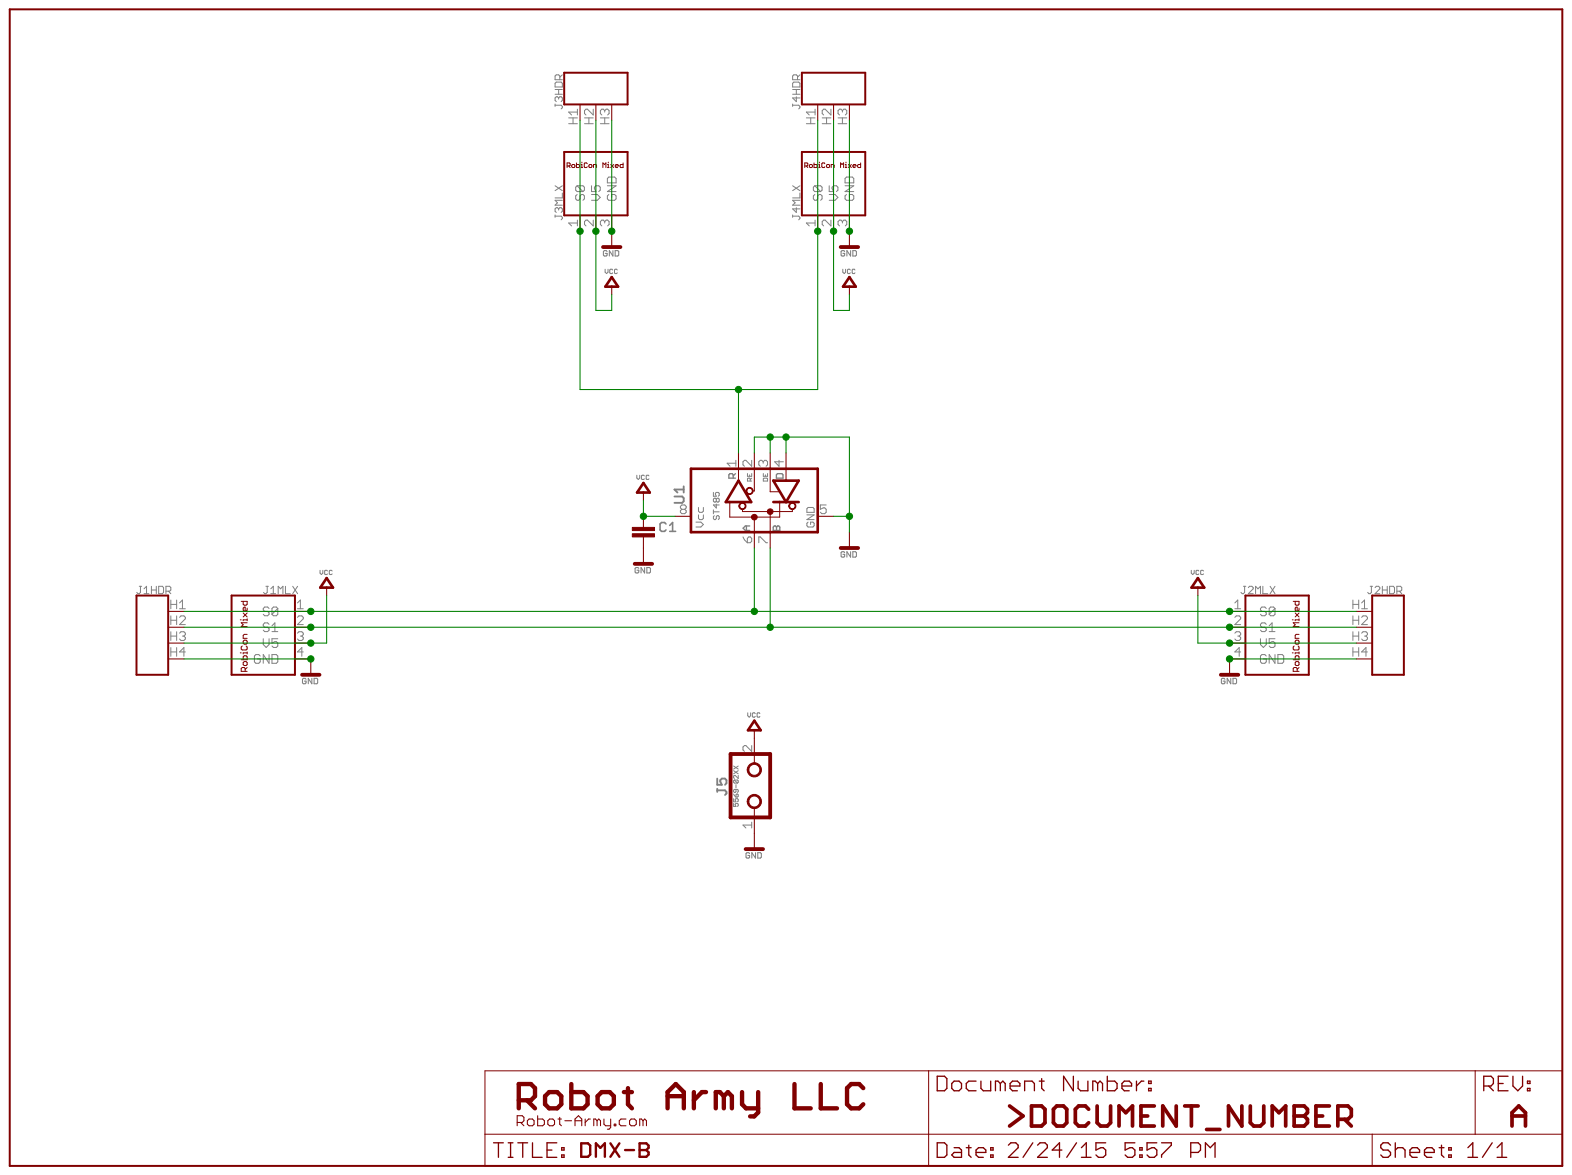
[picture p46: page 1]
