robotarmyllc/light-play/hardware/dmx-a-board/documents/dmx-a-sch.pdf

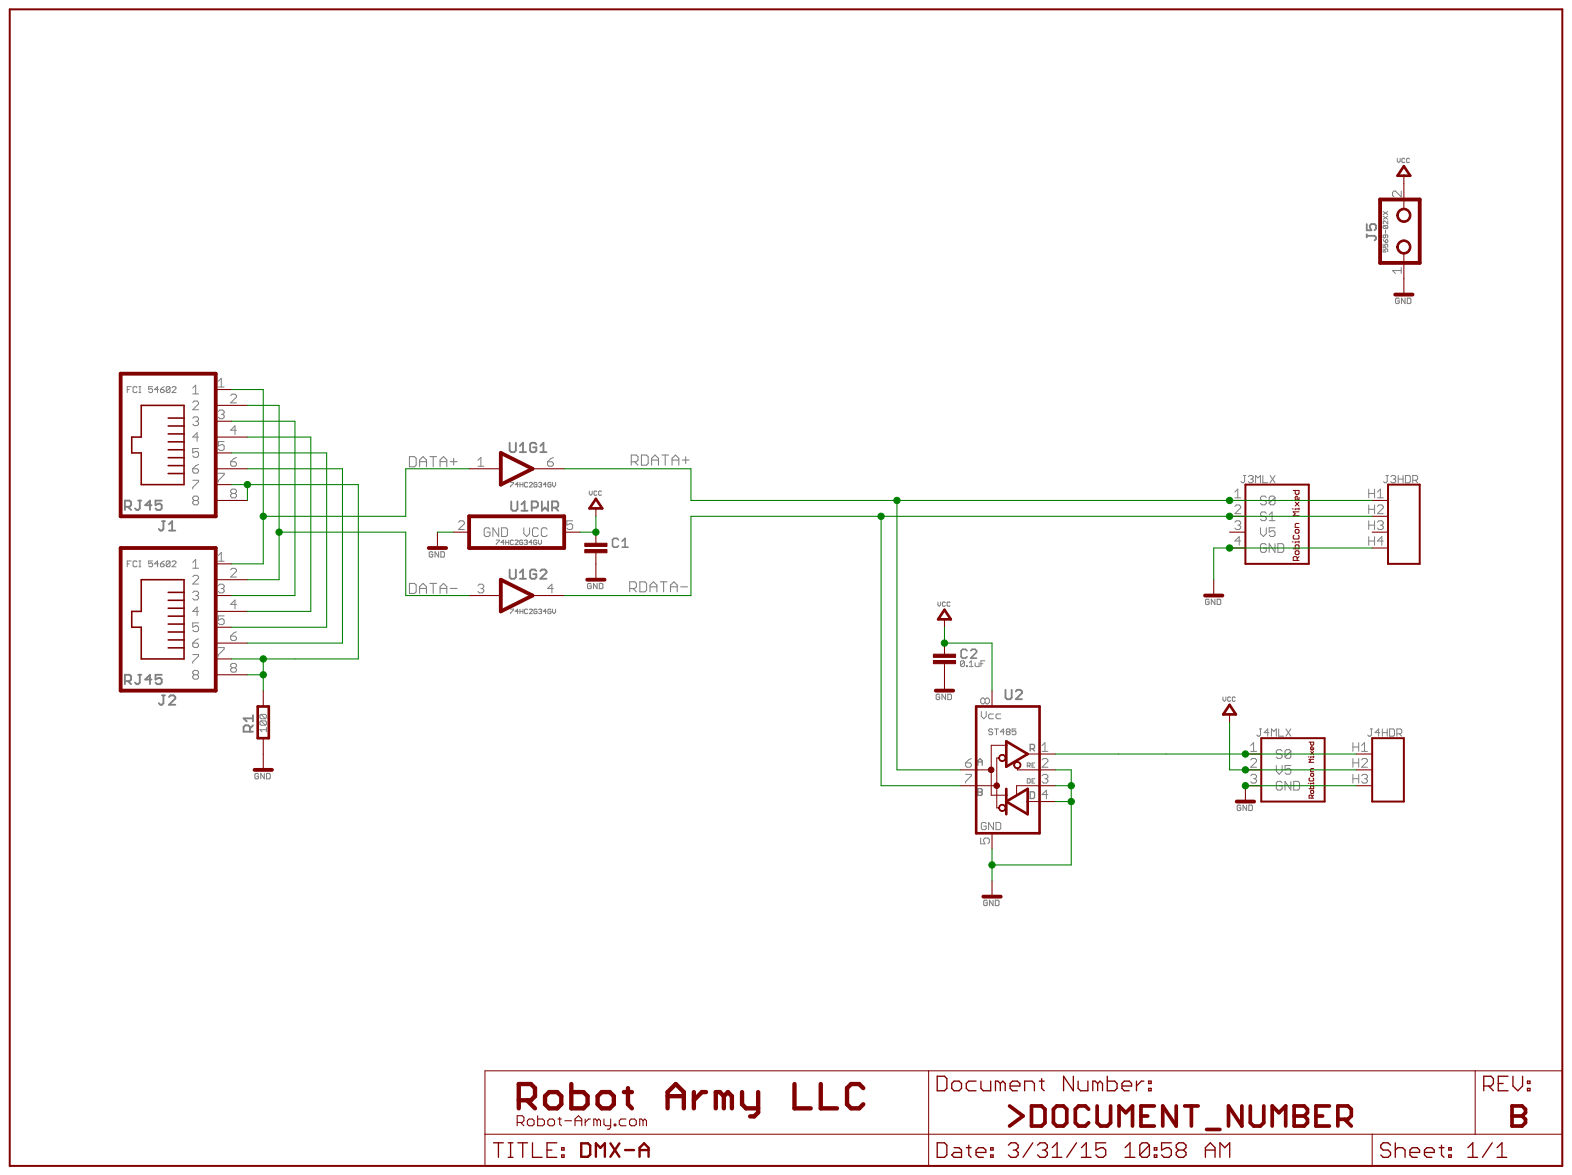
[picture p47: page 1]
