robotarmyllc/light-play/hardware/brain-test-fixture/Documents/brain-test.pdf

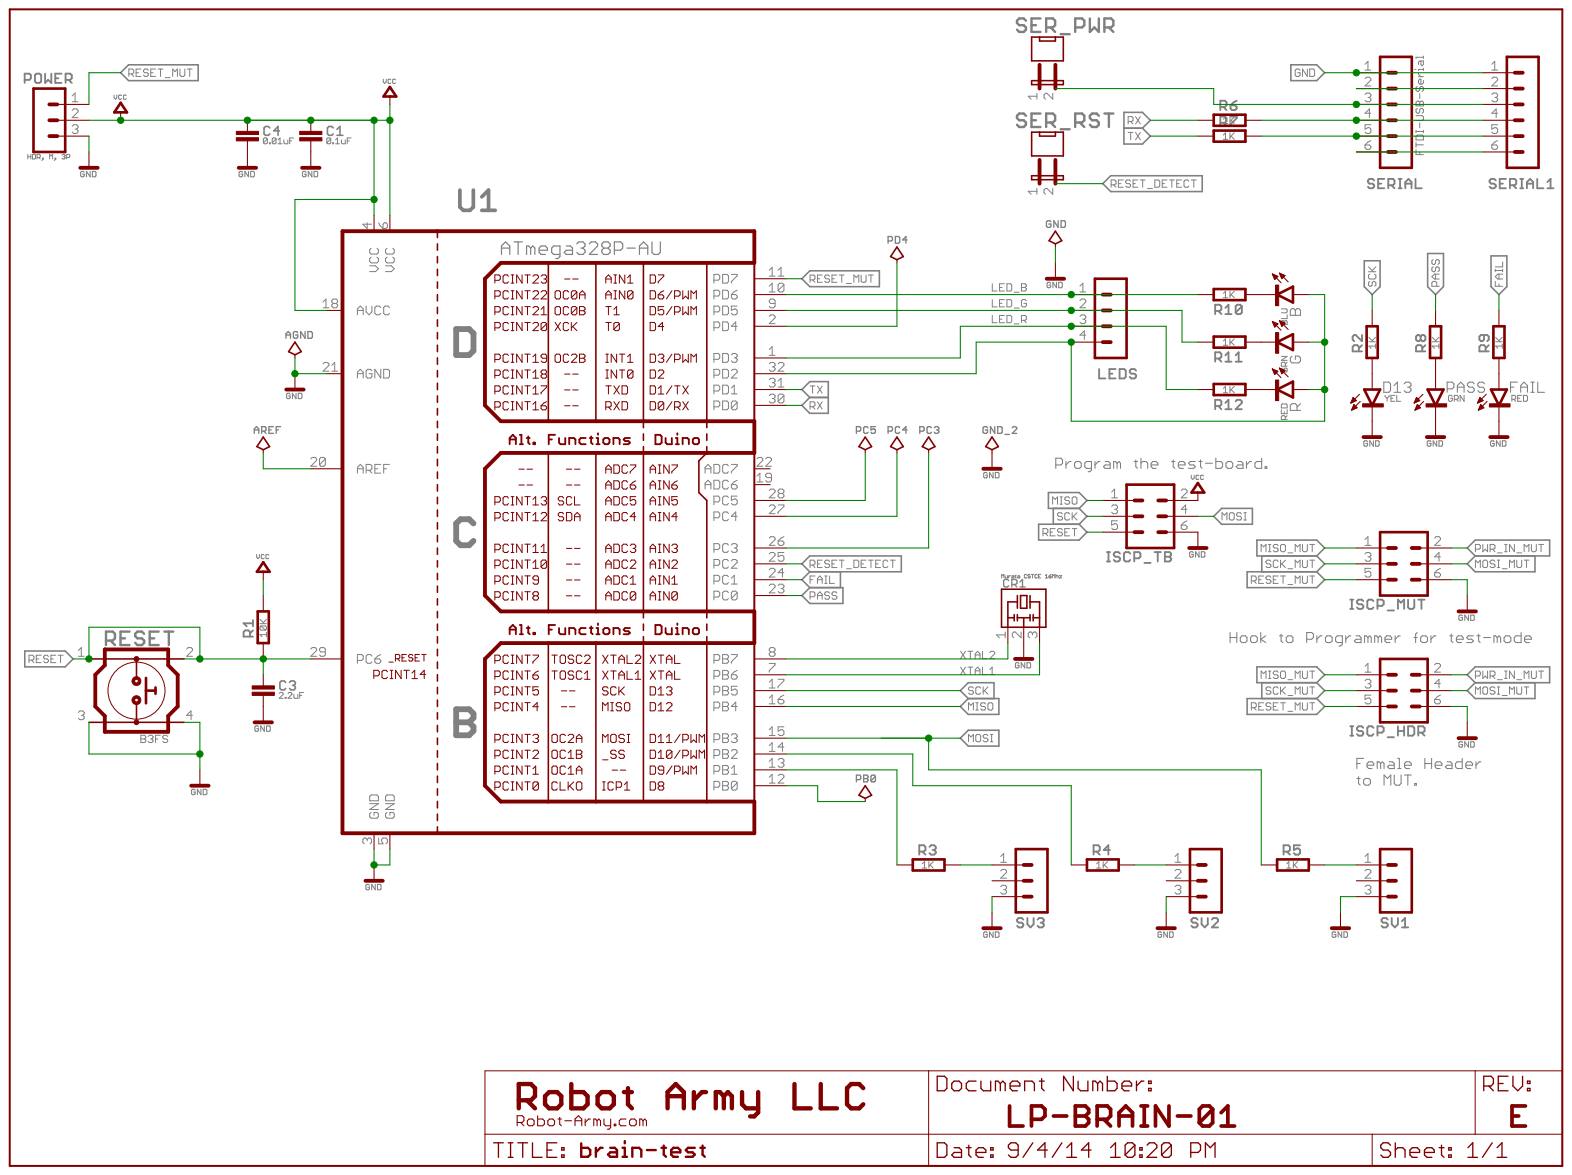
[picture p48: page 1]
