robotarmyllc/light-play/hardware/brain-board/documents/brain-sch-rev-e.pdf

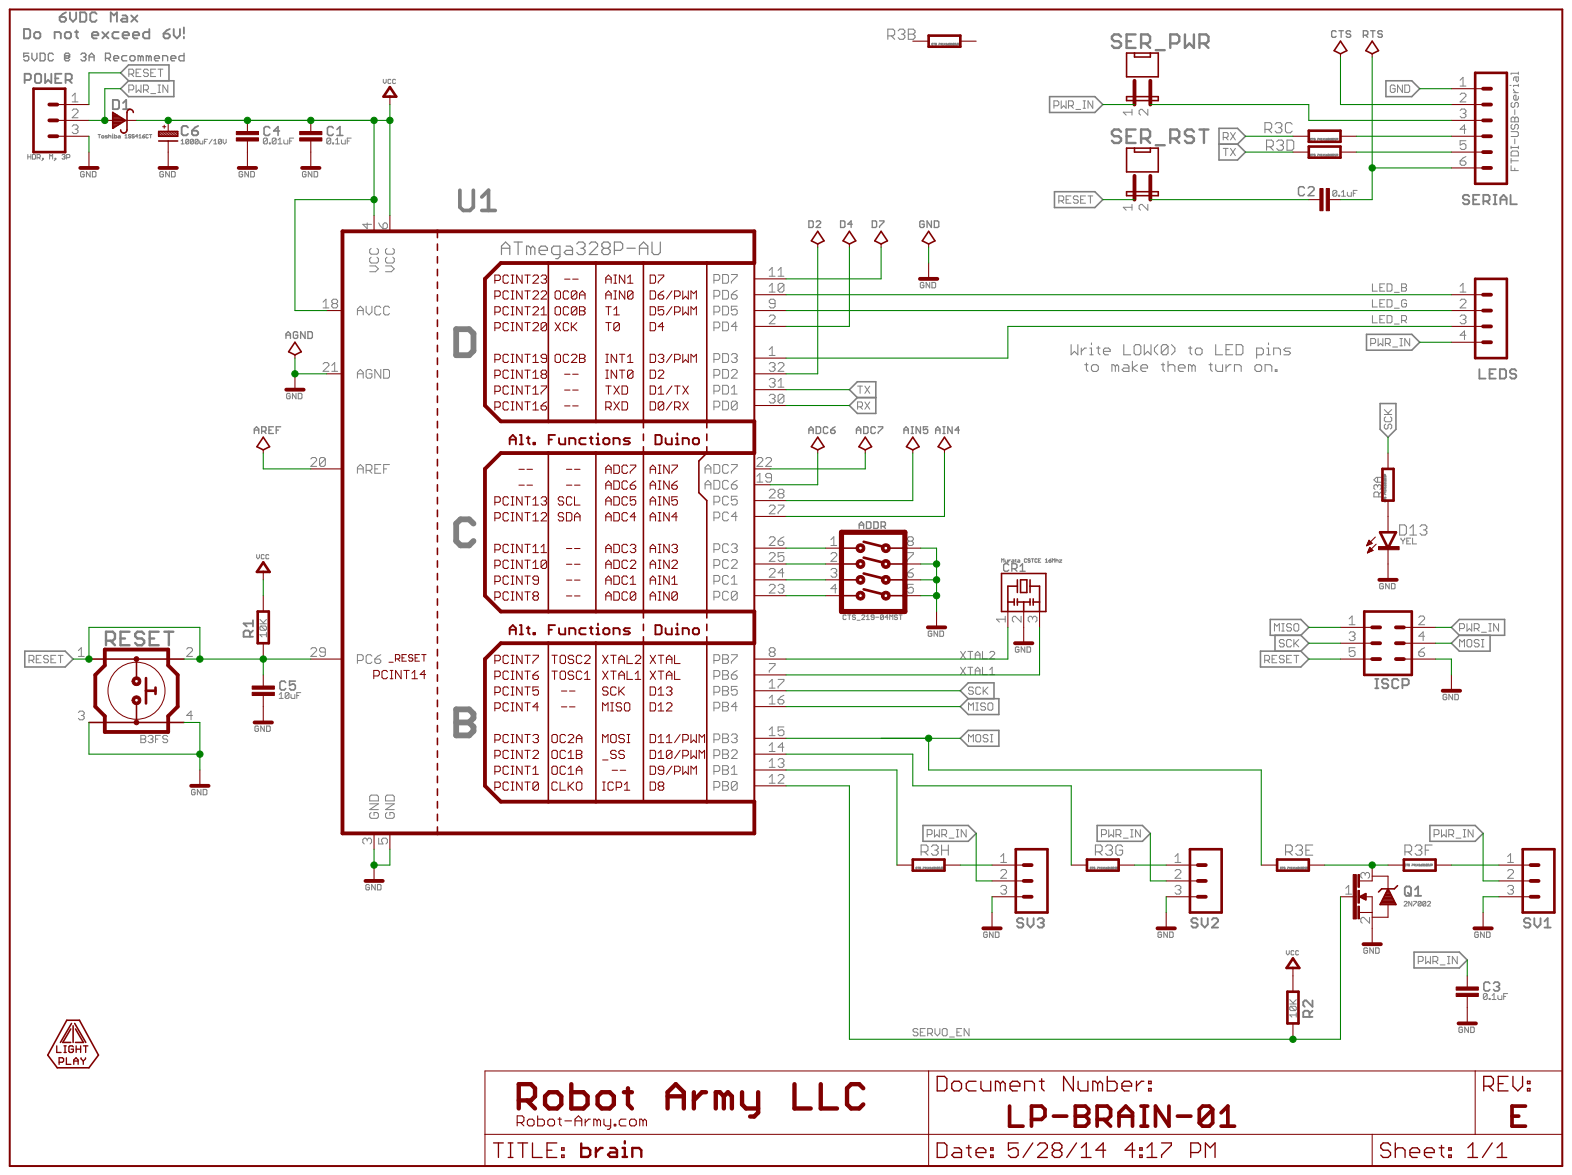
[picture p49: page 1]
