robotarmyllc/light-play/hardware/brain-board/documents/brain-mounting.pdf

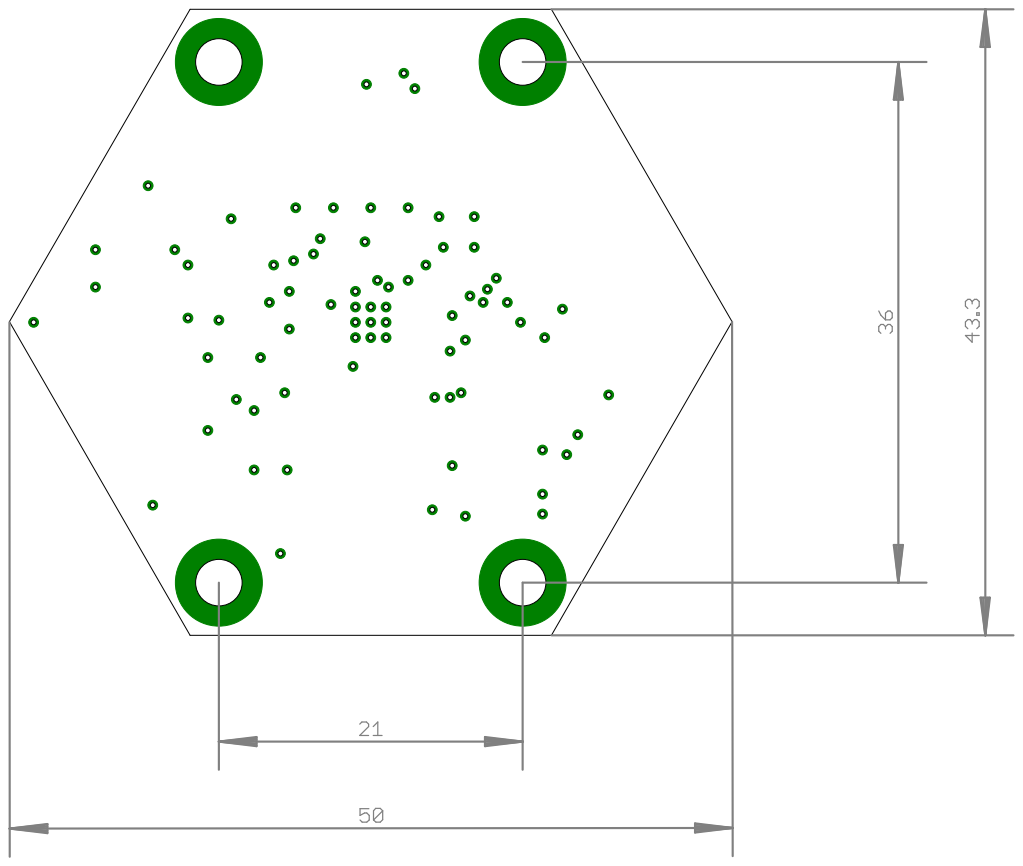
[picture p50: page 1]
