robotarmyllc/light-play/hardware/kit/led-pcb/documents/LP-LED-sch.pdf

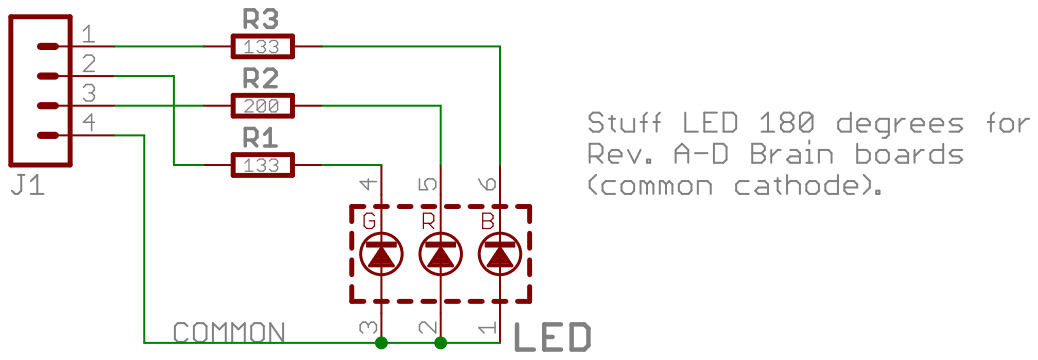
[picture p51: page 1]
