robotarmyllc/light-play/hardware/brain-board/documents/brain-sch-rev-d.pdf

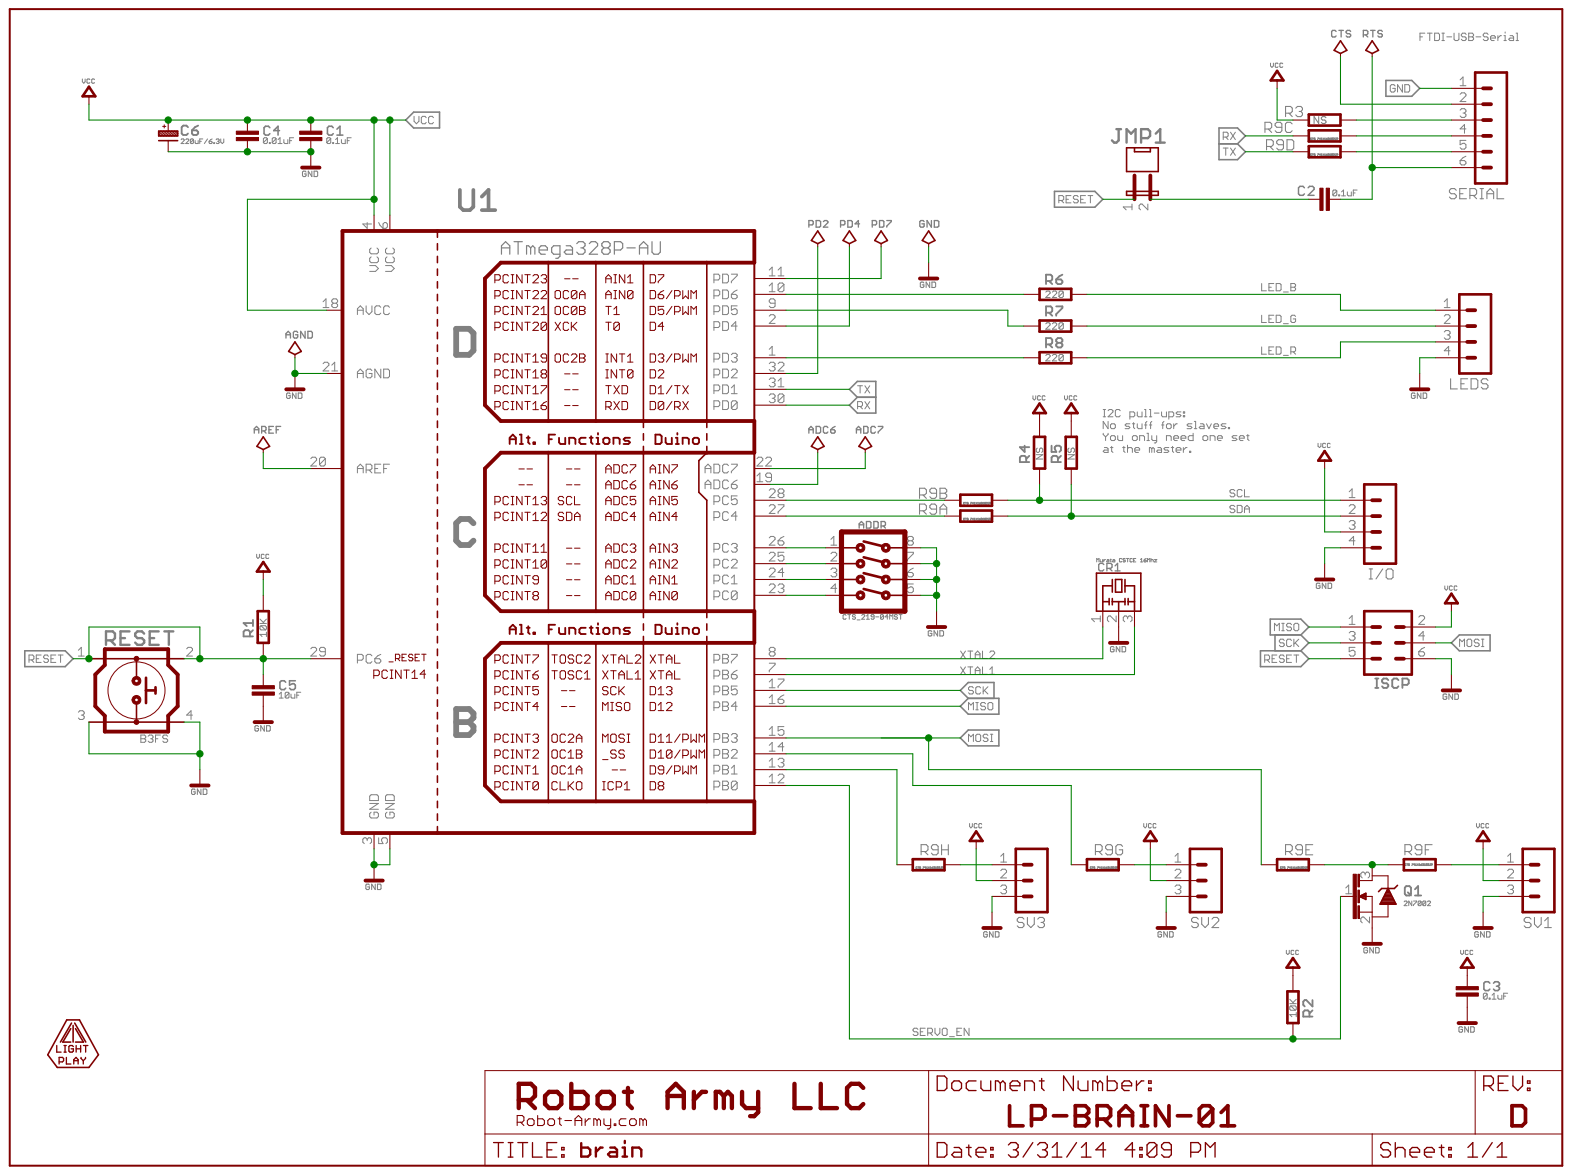
[picture p52: page 1]
