robotarmyllc/light-play/hardware/brain-board/documents/brain-sch-rev-c.pdf

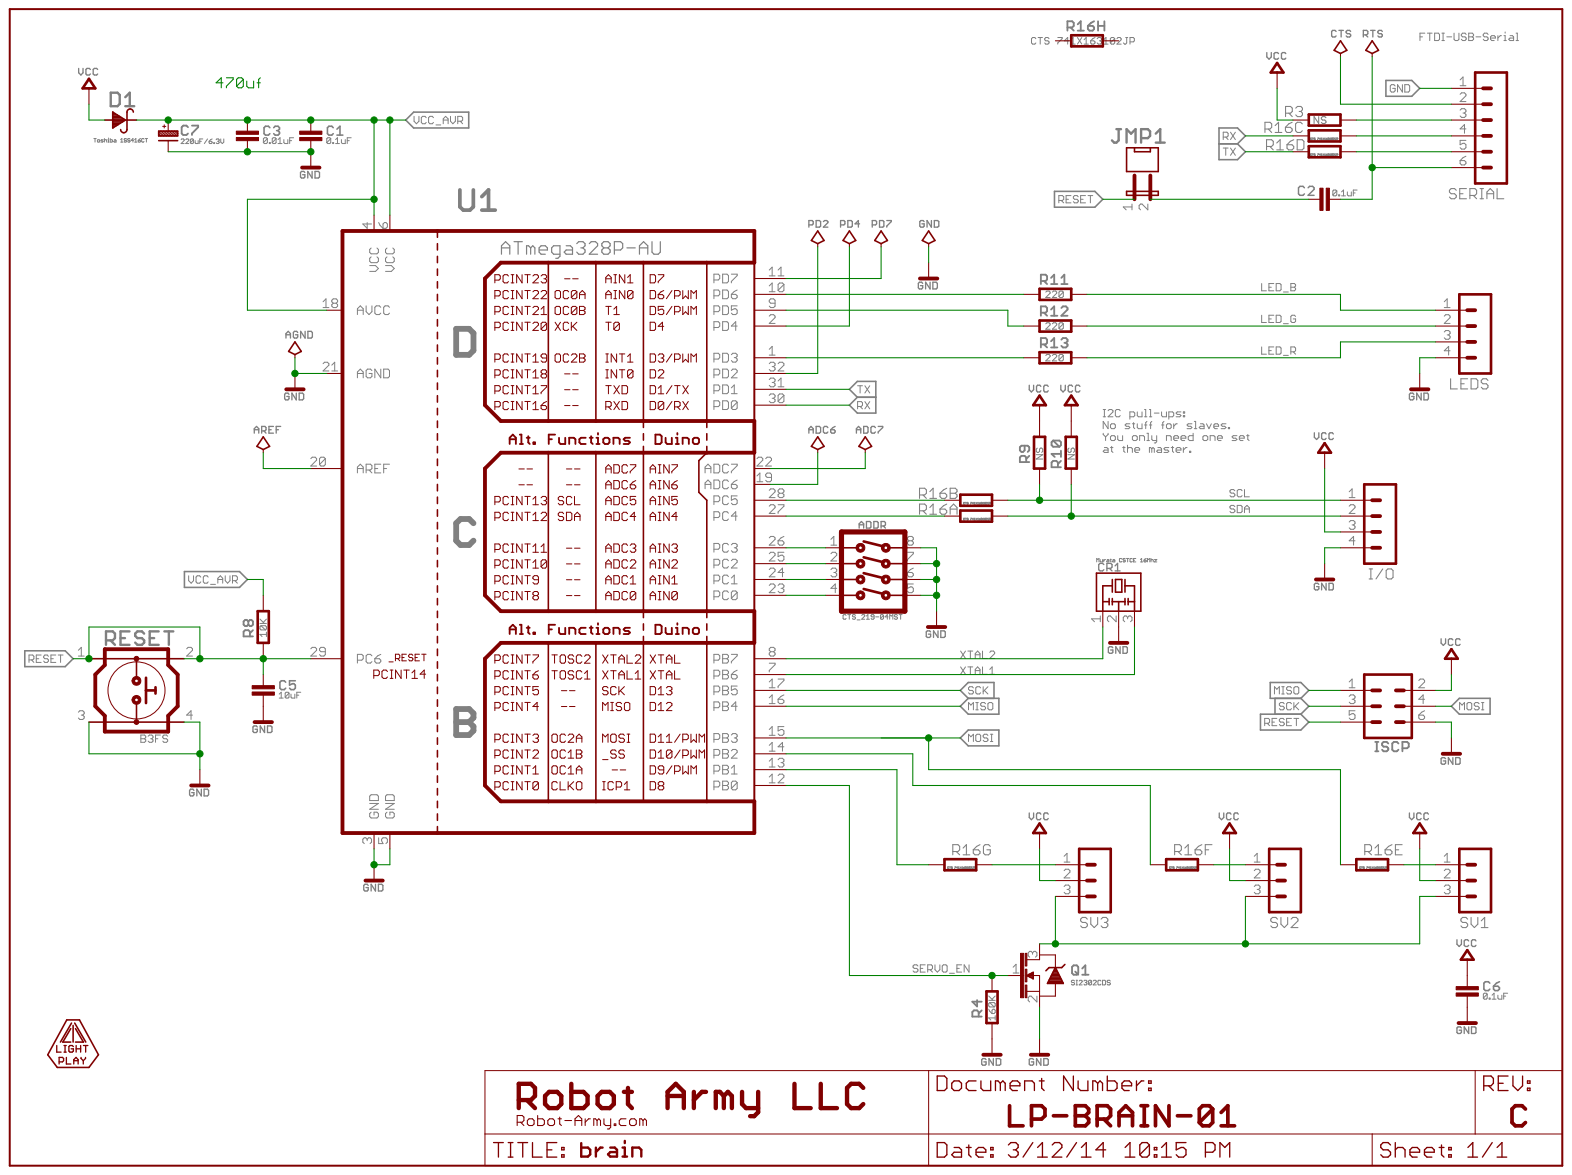
[picture p53: page 1]
