robotarmyllc/light-play/hardware/brain-board/documents/brain-sch-rev-b.pdf

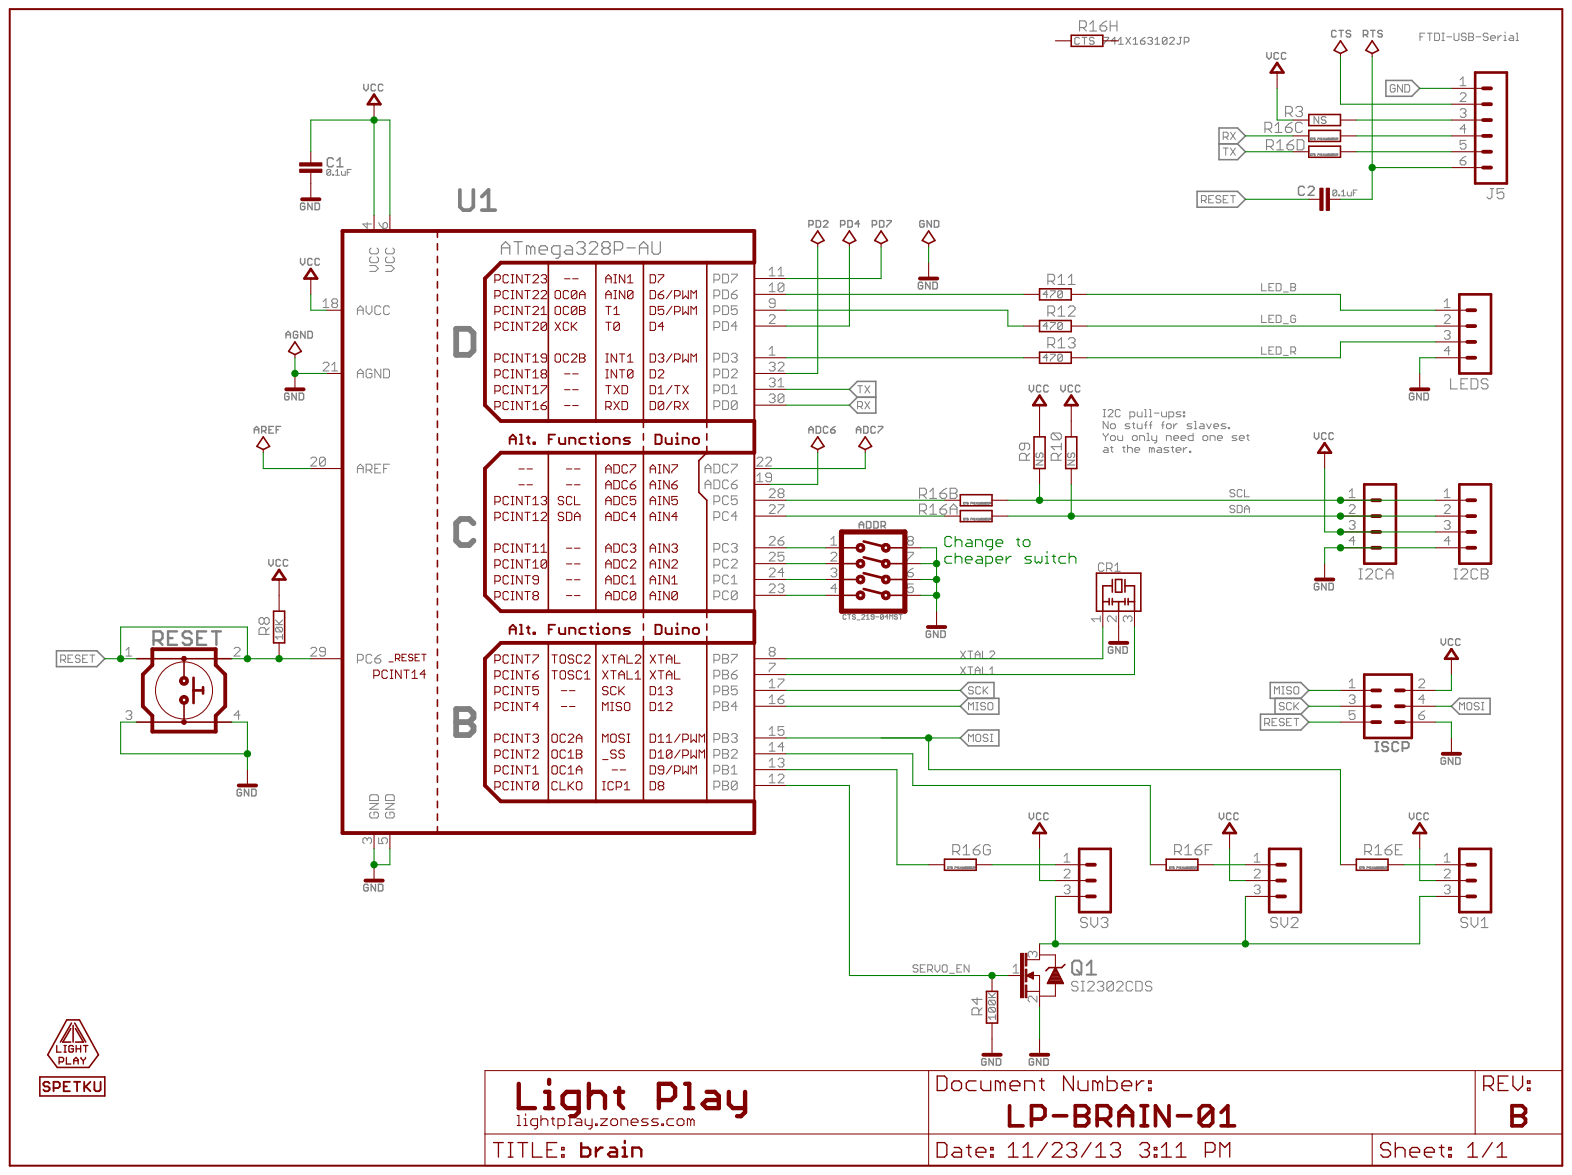
[picture p54: page 1]
