robotarmyllc/light-play/hardware/brain-board/documents/brain-sch-rev-a.pdf

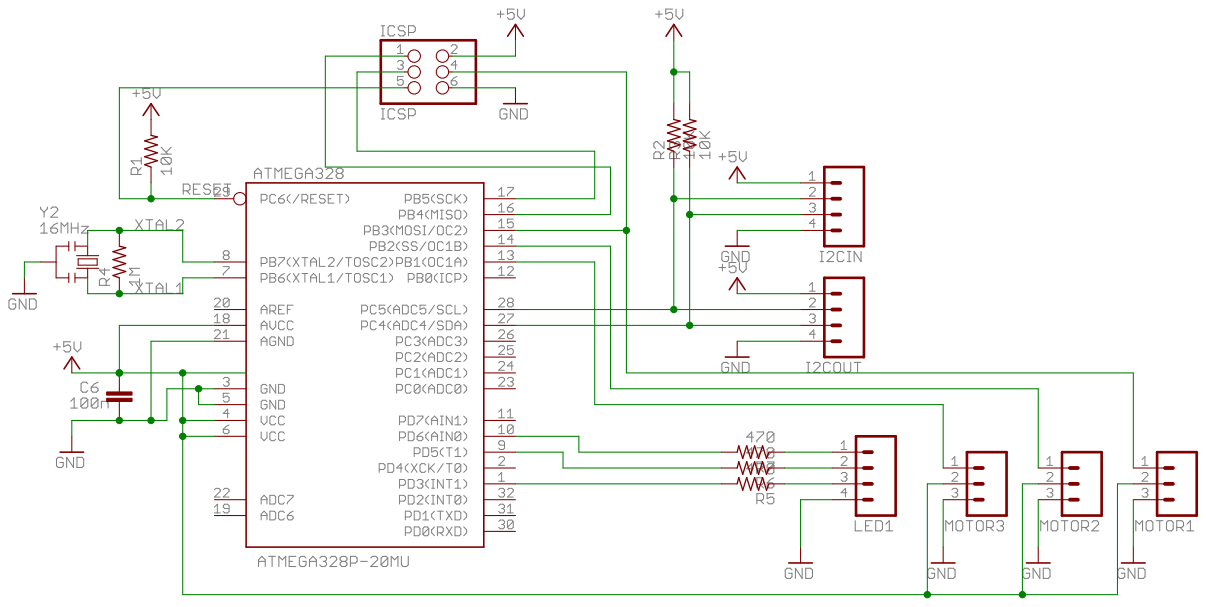
[picture p55: page 1]
