robotarmyllc/light-play/hardware/dmx-cat5-board/pcb/serial-receiver.brd

## EAGLE design hardware/dmx-cat5-board/pcb/serial-receiver.brd (2022-09-13)

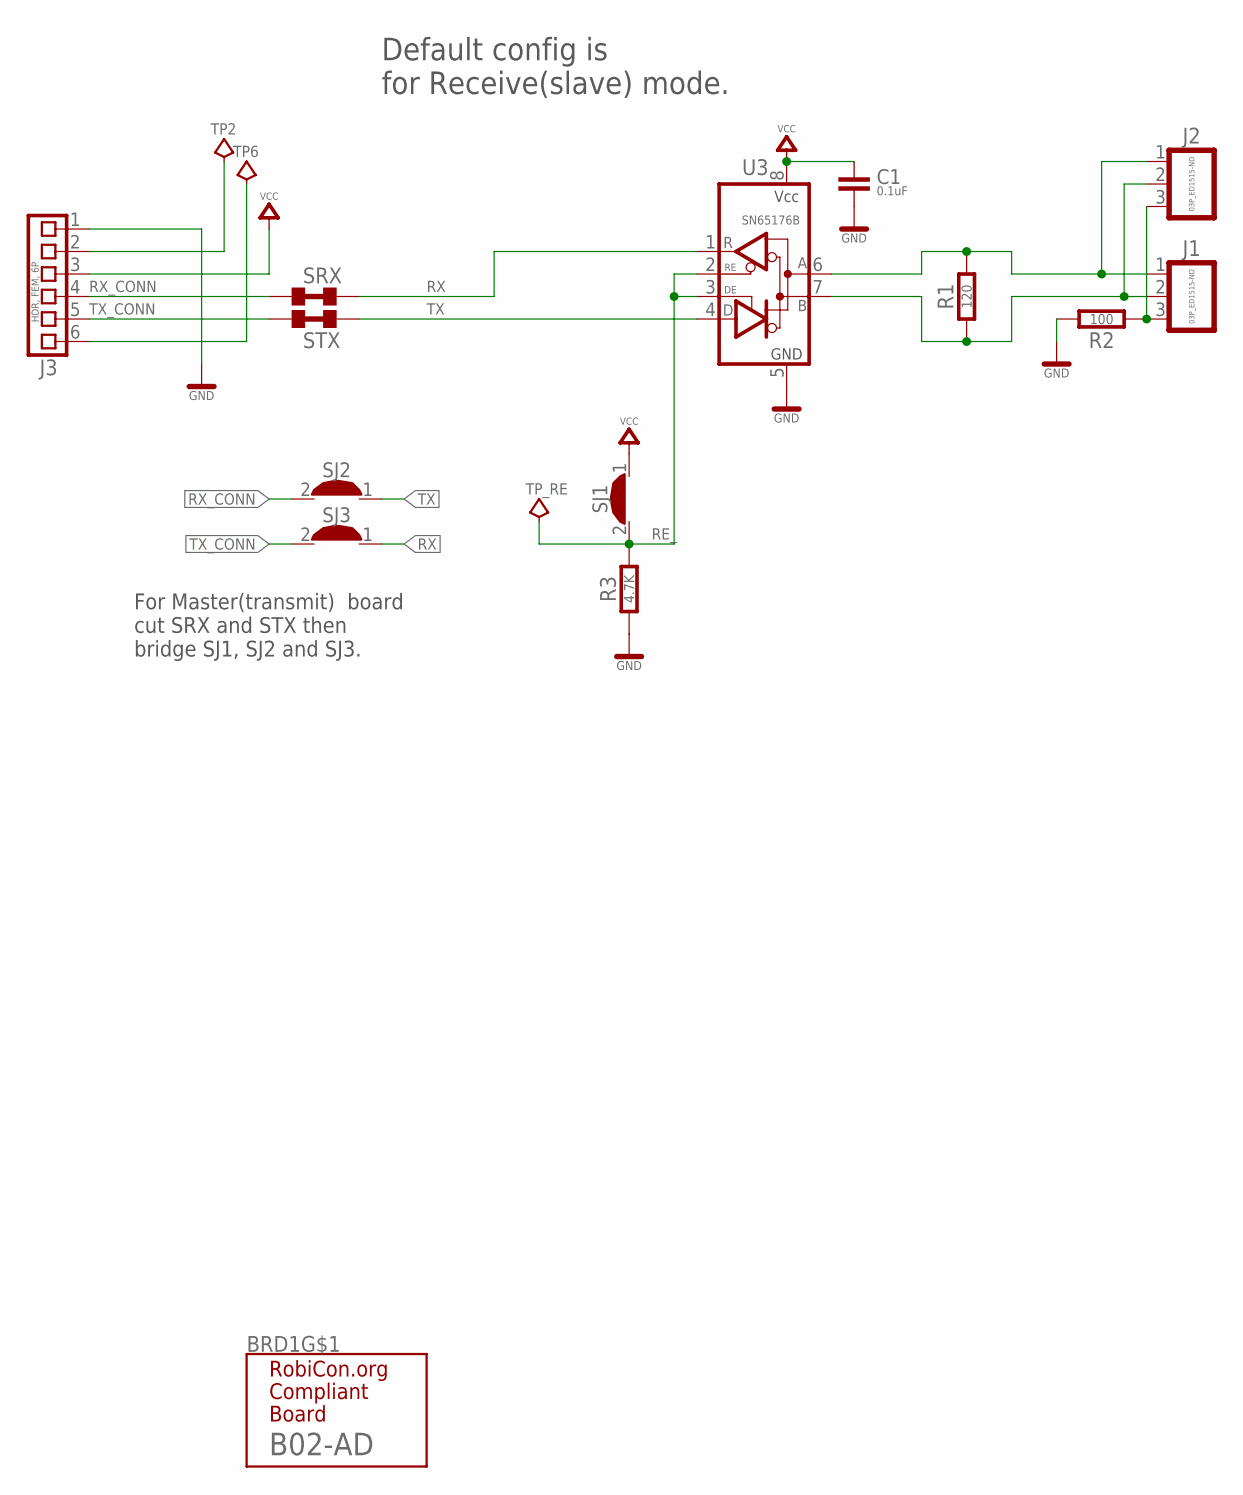
[picture p56: schematic serial-receiver.sch]

Parts:
BRD1: B02-AD
C1: 0.1uF; 0603
J1, J2: 03P_ED1515-ND; TB35-03
J3: HDR, FEM, 6P; FE06
R1: 120; 1206
R2: 100; 1206
R3: 4.7K; 0603
SJ1, SJ2, SJ3: SOLDER_JUMPER; SOLDER_JUMP
SRX: SHORT0603; 0603-SHORT
STX: SHORT0603; 0603-SHORT
TP2, TP6: TEST_POINT_SM_2X2; TP-SMT-020X020
TP_RE: TEST_POINT_SM_2X2; TP-SMT-020X020
U3: SN65176B; SOP08

Connections:
A: J1.1, J2.1, R1.2, U3.6 (A)
B: J1.2, J2.2, R1.1, U3.7 (B)
C: J1.3, J2.3, R2.2
GND: BRD1.A, BRD1.D, C1.2, J3.1, R2.1, R3.1, U3.5 (GND)
unnamed: J3.2, TP2.1
unnamed: J3.6, TP6.1
RE_: R3.2, SJ1.2, TP_RE.1, U3.2 (RE), U3.3 (DE)
RX: SJ3.1, SRX.2, U3.1 (R)
RX_CONN: J3.4, SJ2.2, SRX.1
TX: SJ2.1, STX.2, U3.4 (D)
TX_CONN: J3.5, SJ3.2, STX.1
VCC: C1.1, J3.3, SJ1.1, U3.8 (VCC)

Notes on the sheet:
Default config is for Receive(slave) mode.
For Master(transmit) board cut SRX and STX then bridge SJ1, SJ2 and SJ3.

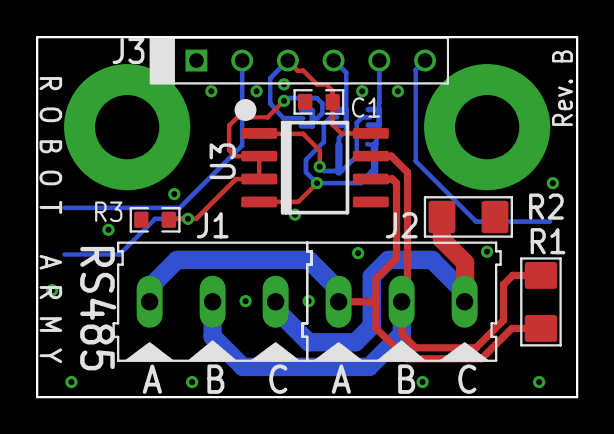
[picture p57: board serial-receiver.brd from above]

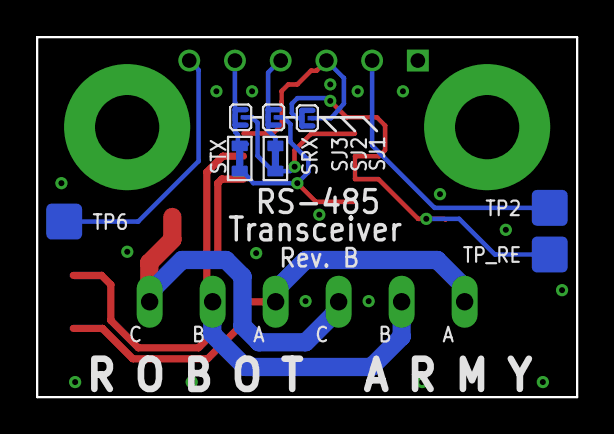
[picture p58: board serial-receiver.brd from below]

Board: 2 copper layers, 30.0 x 20.0 mm, 17 parts (8 on the bottom side), 12 nets.
