robotarmyllc/light-play/hardware/kit/led-pcb/pcb/LP-LED.brd

## EAGLE design hardware/kit/led-pcb/pcb/LP-LED.brd (2022-09-13)

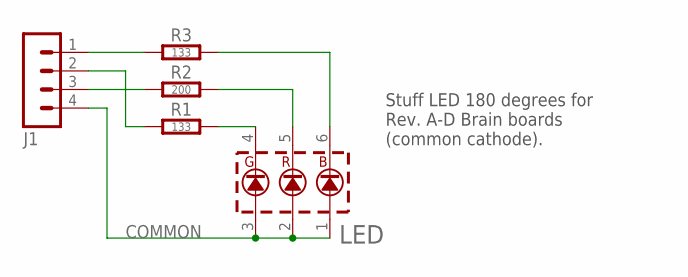
[picture p59: schematic LP-LED.sch]

Parts:
J1: MA04-1
LED: RGB_INDIVPLCC-6; PLCC-6
R1, R3: 133; 0805
R2: 200; 0805

Connections:
COMMON: J1.4, LED.1 (AB), LED.2 (AR), LED.3 (AG)
unnamed: LED.4 (KG), R1.2
unnamed: J1.3, R2.1
unnamed: LED.6 (KB), R3.2
unnamed: LED.5 (KR), R2.2
unnamed: J1.2, R1.1
unnamed: J1.1, R3.1

Notes on the sheet:
Stuff LED 180 degrees for Rev. A-D Brain boards (common cathode).

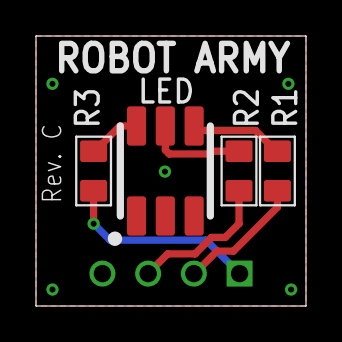
[picture p60: board LP-LED.brd from above]

Board: 2 copper layers, 15.0 x 15.0 mm, 5 parts (1 on the bottom side), 7 nets.
