robotarmyllc/light-play/hardware/dmx-b-board/PCB/DMX-B.brd

## EAGLE design hardware/dmx-b-board/PCB/DMX-B.brd (2022-09-13)

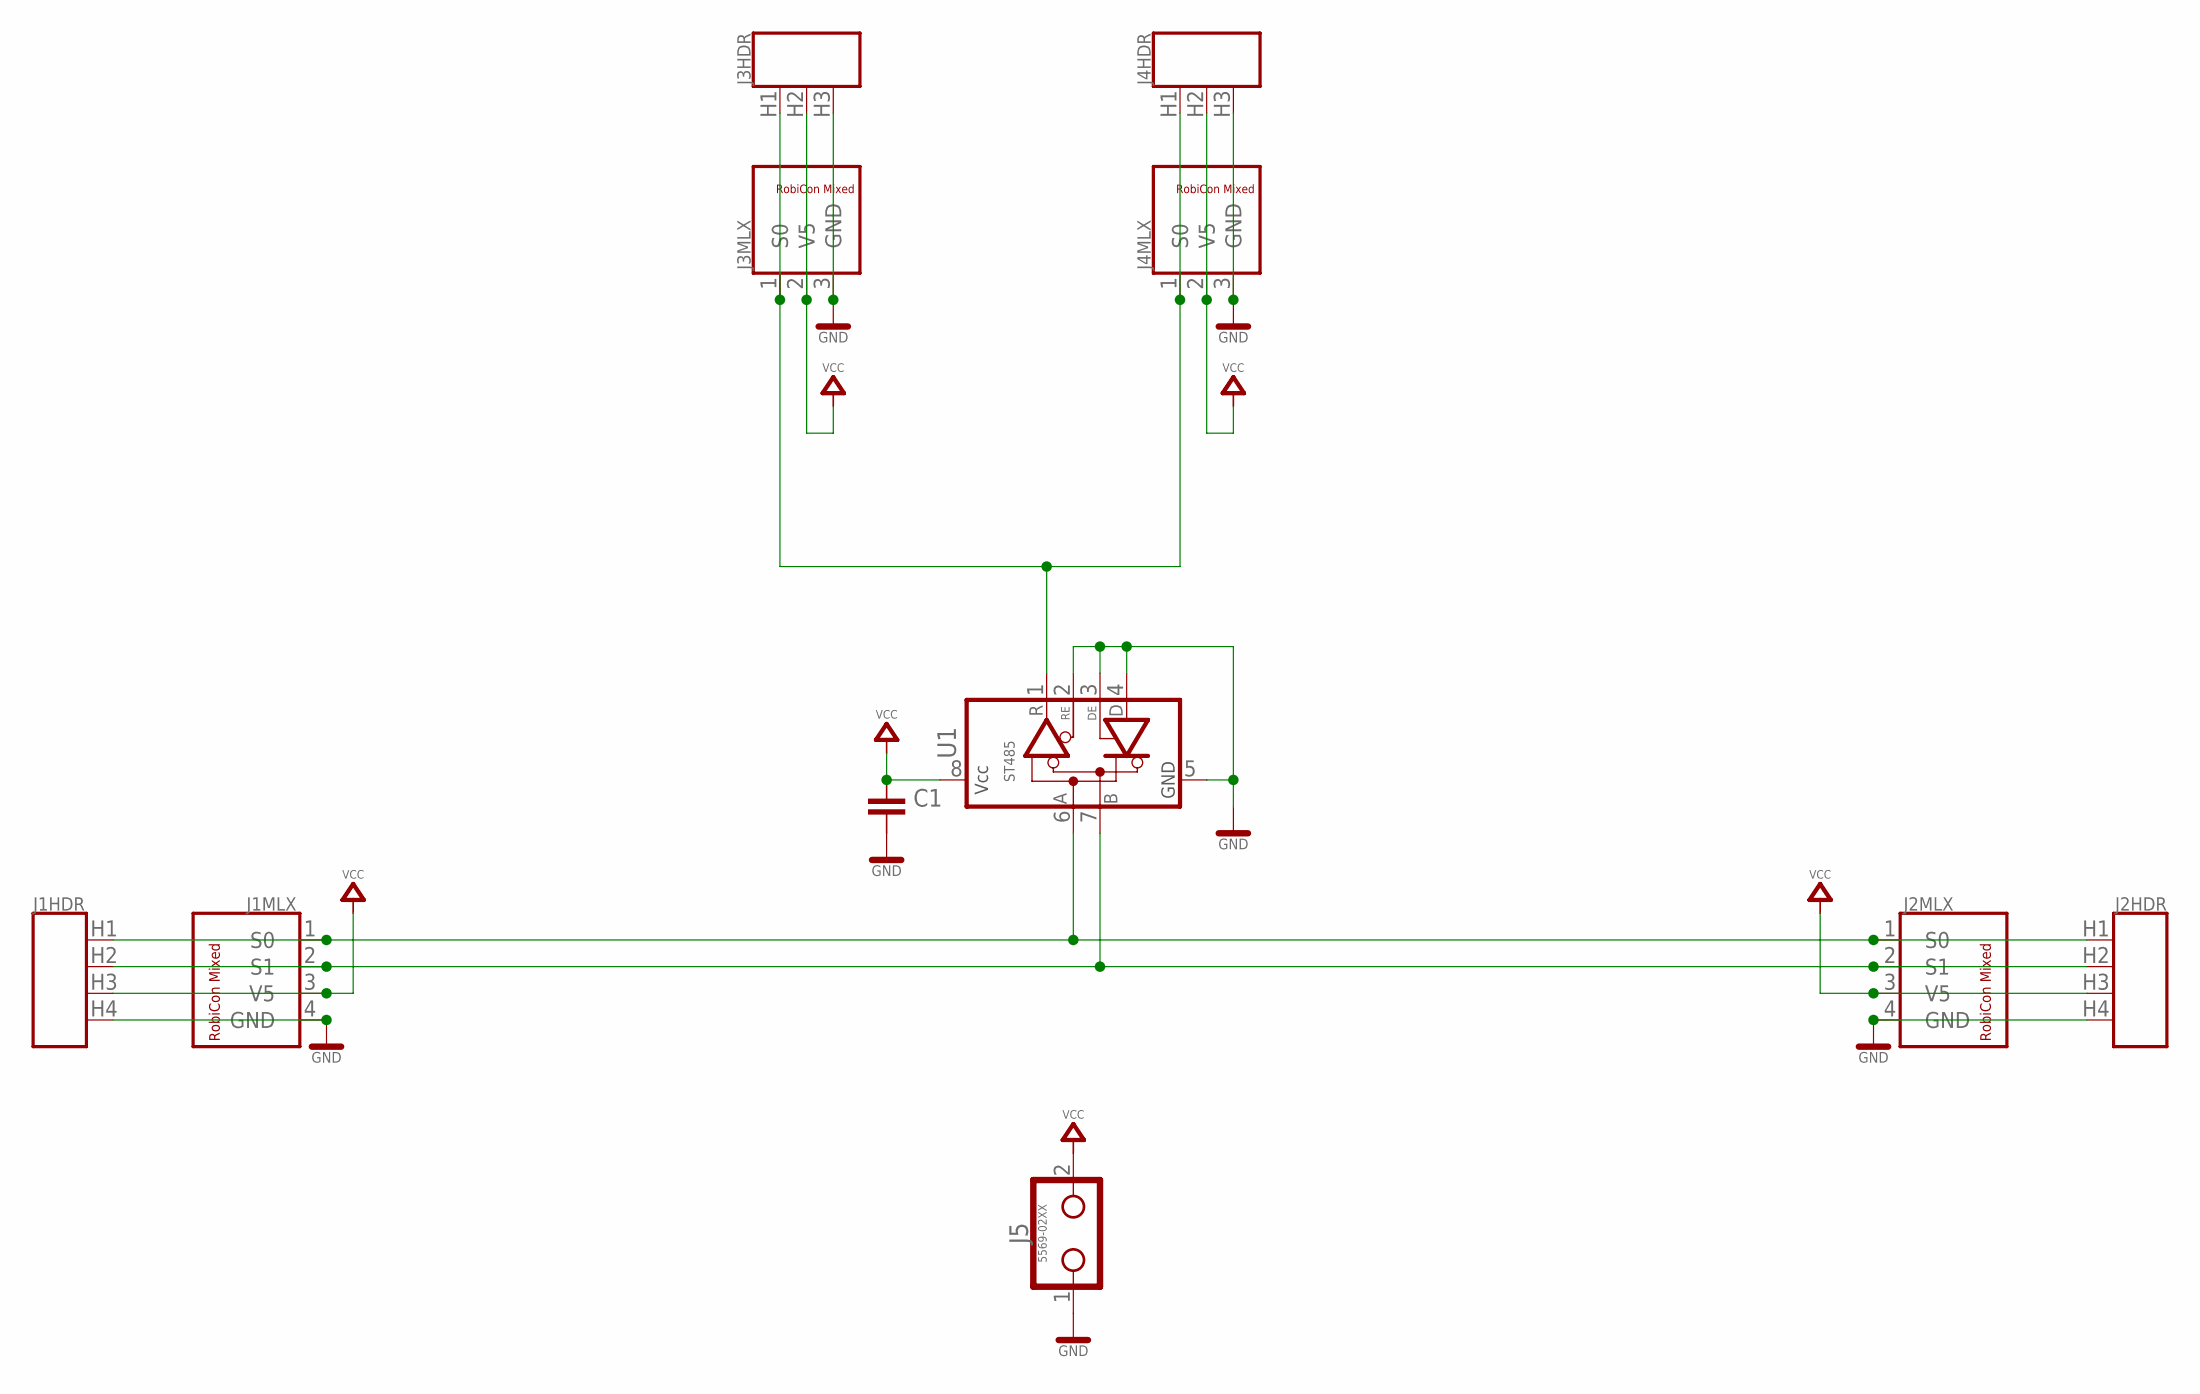
[picture p61: schematic DMX-B.sch]

Parts:
C1: CAPACITOR0603; 0603
J1, J2: ROBICON_M_04P_DUAL; ROBICON-DUAL-04P
J3, J4: ROBICON_M_03P_DUAL; ROBICON-DUAL-03P
J5: 5569-02XX; MOLEX-5569-02XX
U1: ST485; SOP08

Connections:
GND: C1.2, J1.4 (GND), J1.H4 (4), J2.4 (GND), J2.H4 (4), J3.3 (GND), J3.H3 (3), J4.3 (GND), J4.H3 (3), J5.1, U1.2 (RE), U1.3 (DE), U1.4 (D), U1.5 (GND)
unnamed: J1.1 (S0), J1.H1 (1), J2.1 (S0), J2.H1 (1), U1.6 (A)
unnamed: J1.2 (S1), J1.H2 (2), J2.2 (S1), J2.H2 (2), U1.7 (B)
unnamed: J3.1 (S0), J3.H1 (1), J4.1 (S0), J4.H1 (1), U1.1 (R)
VCC: C1.1, J1.3 (V5), J1.H3 (3), J2.3 (V5), J2.H3 (3), J3.2 (V5), J3.H2 (2), J4.2 (V5), J4.H2 (2), J5.2, U1.8 (VCC)

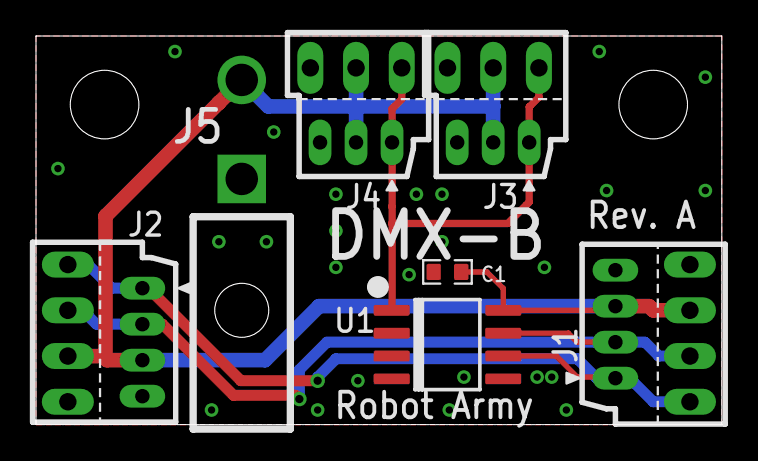
[picture p62: board DMX-B.brd from above]

Board: 2 copper layers, 38.1 x 21.6 mm, 7 parts (0 on the bottom side), 5 nets.
