robotarmyllc/light-play/hardware/dmx-a-board/pcb/DMX-A.brd

## EAGLE design hardware/dmx-a-board/pcb/DMX-A.brd (2022-09-13)

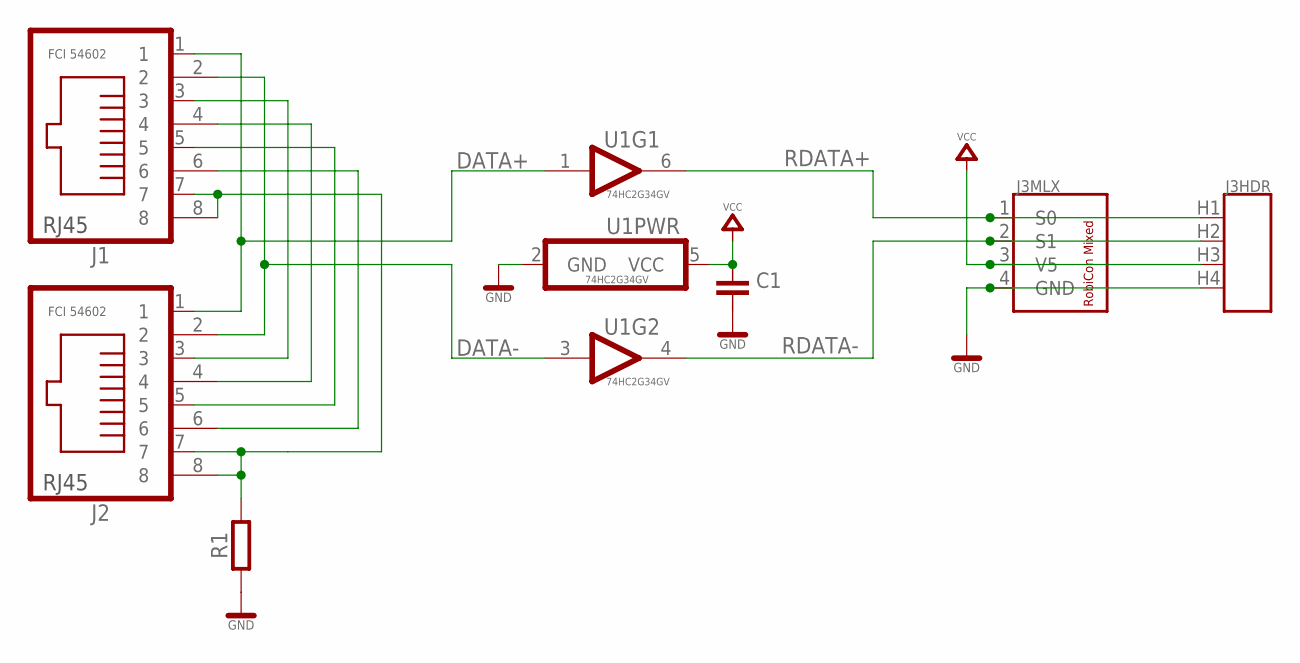
[picture p63: schematic DMX-A.sch]

Parts:
C1: CAPACITOR0603; 0603
J1, J2: FCI 54602; FCI_54602
J3: ROBICON_M_04P_DUAL; ROBICON-DUAL-04P
R1: RESISTOR1206; 1206
U1: 74HC2G34GV; TSOP-6

Connections:
DATA+: J1.1, J2.1, U1.1 (A)
DATA-: J1.2, J2.2, U1.3 (A)
GND: C1.2, J3.4 (GND), J3.H4 (4), R1.1, U1.2 (GND)
unnamed: J1.3, J2.3
unnamed: J1.4, J2.4
unnamed: J1.5, J2.5
unnamed: J1.6, J2.6
RDATA+: J3.1 (S0), J3.H1 (1), U1.6 (Y)
RDATA-: J3.2 (S1), J3.H2 (2), U1.4 (Y)
RJ_GND: J1.7, J1.8, J2.7, J2.8, R1.2
VCC: C1.1, J3.3 (V5), J3.H3 (3), U1.5 (VCC)

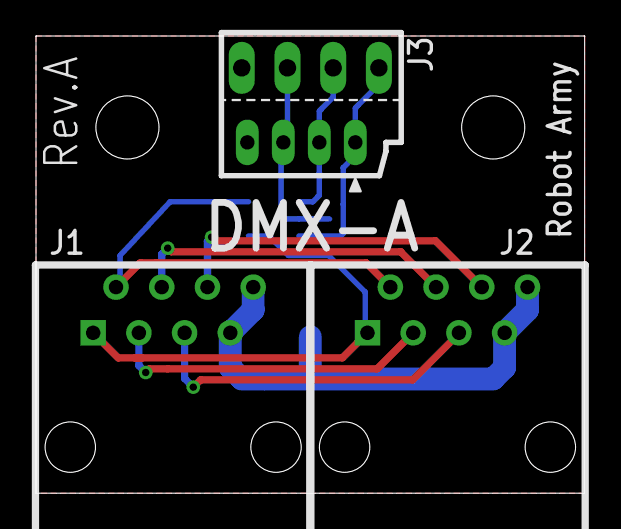
[picture p64: board DMX-A.brd from above]

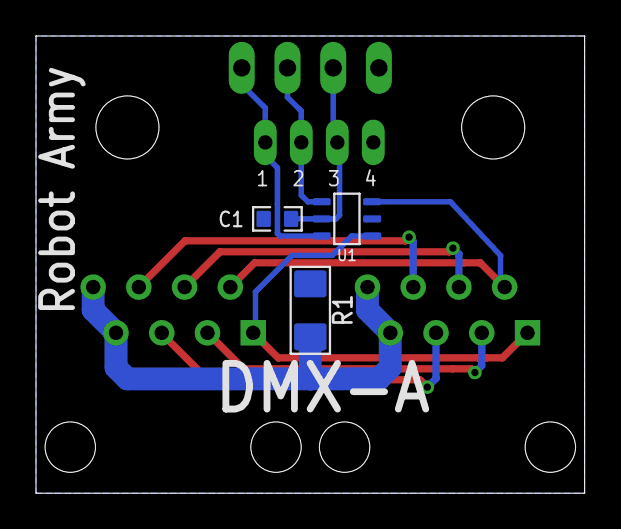
[picture p65: board DMX-A.brd from below]

Board: 2 copper layers, 30.5 x 25.4 mm, 6 parts (3 on the bottom side), 11 nets.
