robotarmyllc/light-play/hardware/brain-test-fixture/PCB/brain-test.brd

## EAGLE design hardware/brain-test-fixture/PCB/brain-test.brd (2022-09-13)

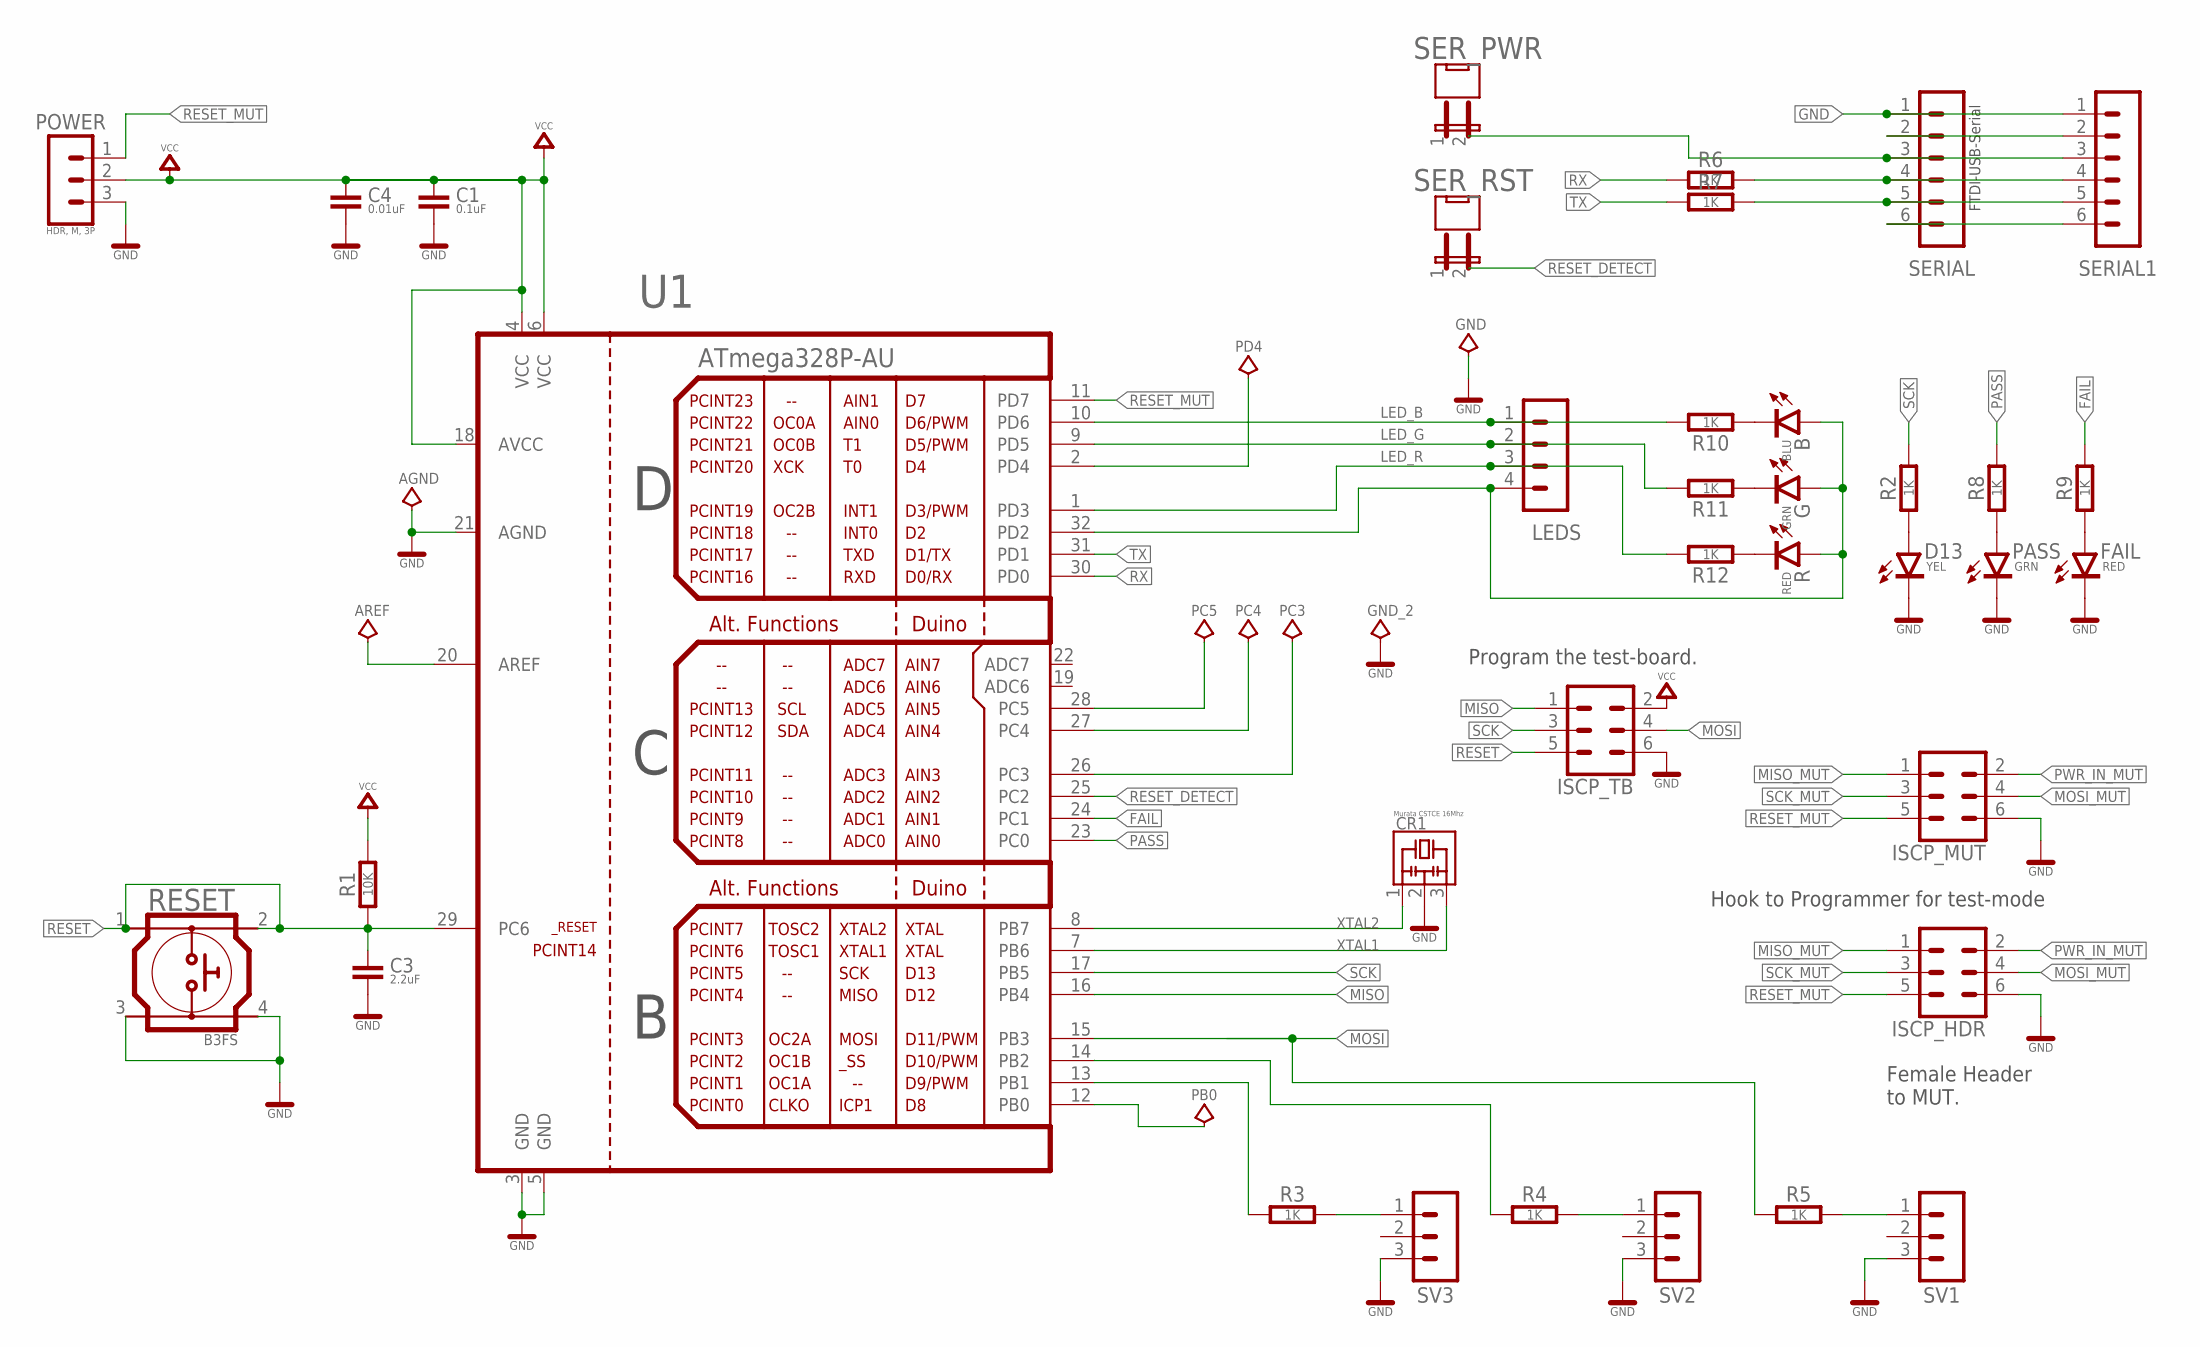
[picture p66: schematic brain-test.sch]

Parts:
AGND: TEST_POINT_SM_2X2; TP-SMT-020X020
AREF: TEST_POINT_SM_2X2; TP-SMT-020X020
B: BLU; SMD_0603
C1: 0.1uF; 0603
C3: 2.2uF; 0603
C4: 0.01uF; 0603
CR1: Murata CSTCE 16Mhz; MURATA_CSTCE
D13: YEL; SMD_0603
FAIL: RED; SMD_0603
G: GRN; SMD_0603
GND: TEST_POINT_SM_2X2; TP-SMT-020X020
GND_2: TEST_POINT_SM_2X2; TP-SMT-020X020
ISCP_HDR: MA03-2
ISCP_MUT: MA03-2
ISCP_TB: MA03-2
LEDS: MA04-1
PASS: GRN; SMD_0603
PB0: TEST_POINT_SM_2X2; TP-SMT-020X020
PC3, PC4, PC5: TEST_POINT_SM_2X2; TP-SMT-020X020
PD4: TEST_POINT_SM_2X2; TP-SMT-020X020
POWER: HDR, M, 3P; MA03-1
R: RED; SMD_0603
R1: 10K; 0603
R2, R3, R4, R5, R6, R7, R8, R9, R10, R11, R12: 1K; 0603
RESET: B3FS
SERIAL, SERIAL1: MA06-1
SER_PWR: JMP01VT; MA02-1-FAT
SER_RST: JMP01VT; MA02-1-FAT
SV1, SV2, SV3: MA03-1
U1: ATmega328P-AU; TQFP-32-08

Connections:
AREF: AREF.1, U1.20 (AREF)
CTS: SERIAL.2, SERIAL1.2
FAIL: R9.2, U1.24 (PC1)
GND: AGND.1, C1.2, C3.2, C4.2, CR1.2, D13.K (C), FAIL.K (C), GND.1, GND_2.1, ISCP_HDR.6, ISCP_MUT.6, ISCP_TB.6, PASS.K (C), POWER.3, RESET.3, RESET.4, SERIAL.1, SERIAL1.1, SV1.3, SV2.3, SV3.3, U1.3 (GND), U1.5 (GND), U1.21 (AGND)
LED_B: LEDS.1, R10.2, U1.10 (PD6)
LED_G: LEDS.2, R11.2, U1.9 (PD5)
LED_R: LEDS.3, R12.2, U1.1 (PD3)
MISO: ISCP_TB.1, U1.16 (PB4)
MISO_MUT: ISCP_HDR.1, ISCP_MUT.1
MOSI: ISCP_TB.4, R5.1, U1.15 (PB3)
MOSI_MUT: ISCP_HDR.4, ISCP_MUT.4
unnamed: D13.A, R2.1
unnamed: PASS.A, R8.1
unnamed: PD4.1, U1.2 (PD4)
unnamed: PC5.1, U1.28 (PC5)
unnamed: R3.2, SV3.1
unnamed: FAIL.A, R9.1
unnamed: PC4.1, U1.27 (PC4)
unnamed: PC3.1, U1.26 (PC3)
unnamed: R4.2, SV2.1
unnamed: R5.2, SV1.1
unnamed: B.K (C), R10.1
unnamed: G.K (C), R11.1
unnamed: R.K (C), R12.1
unnamed: R4.1, U1.14 (PB2)
unnamed: R3.1, U1.13 (PB1)
PASS: R8.2, U1.23 (PC0)
PWR_IN: B.A, G.A, LEDS.4, R.A, U1.32 (PD2)
PWR_IN_MUT: ISCP_HDR.2, ISCP_MUT.2
RESET: C3.1, ISCP_TB.5, R1.1, RESET.1, RESET.2, U1.29 (PC6)
RESET_DETECT: SER_RST.2, U1.25 (PC2)
RESET_MUT: ISCP_HDR.5, ISCP_MUT.5, POWER.1, U1.11 (PD7)
RTS: SERIAL.6, SERIAL1.6
RX: R6.1, U1.30 (PD0)
RXD: R7.2, SERIAL.5, SERIAL1.5
SCK: ISCP_TB.3, R2.2, U1.17 (PB5)
SCK_MUT: ISCP_HDR.3, ISCP_MUT.3
SERVO_EN: PB0.1, U1.12 (PB0)
TX: R7.1, U1.31 (PD1)
TXD: R6.2, SERIAL.4, SERIAL1.4
VCC: C1.1, C4.1, ISCP_TB.2, POWER.2, R1.2, U1.4 (VCC), U1.6 (VCC), U1.18 (AVCC)
VCC5: SERIAL.3, SERIAL1.3, SER_PWR.2
XTAL1: CR1.3, U1.7 (PB6)
XTAL2: CR1.1, U1.8 (PB7)

Notes on the sheet:
FTDI-USB-Serial
Hook to Programmer for test-mode
Program the test-board.
Female Header to MUT.

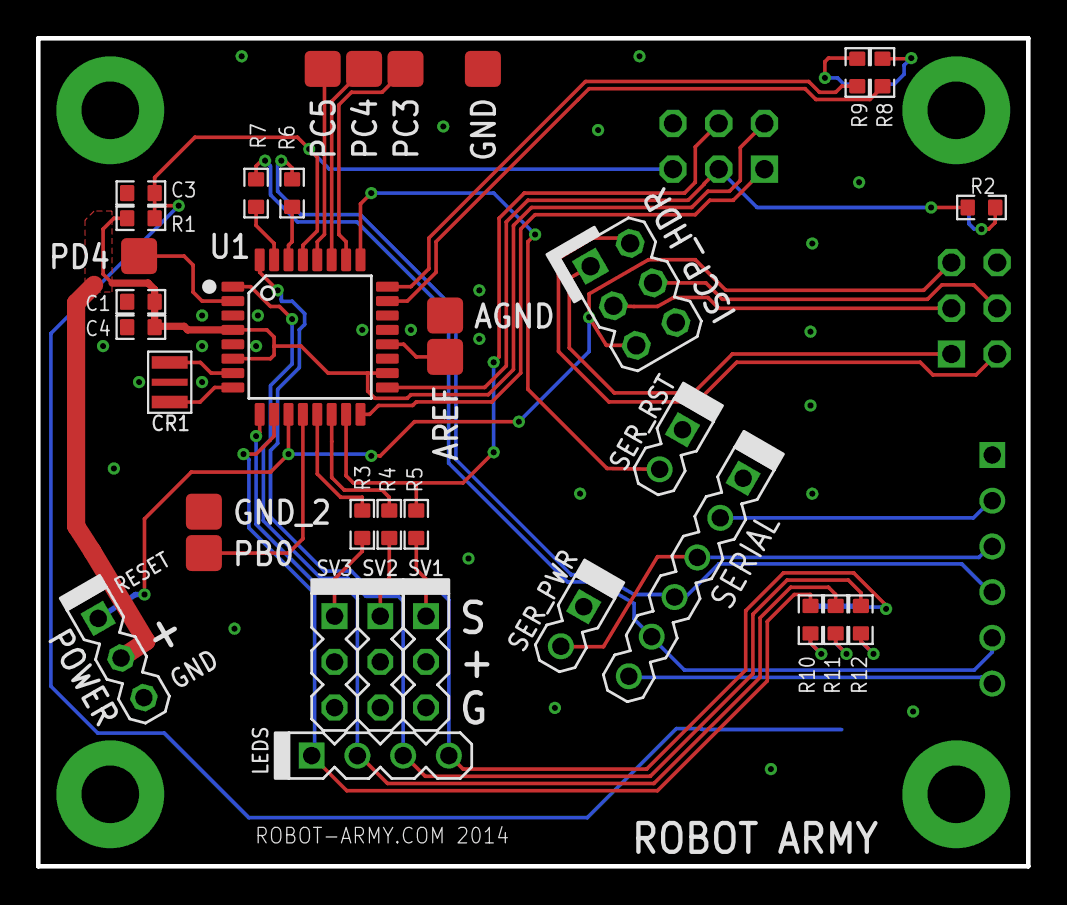
[picture p67: board brain-test.brd from above]

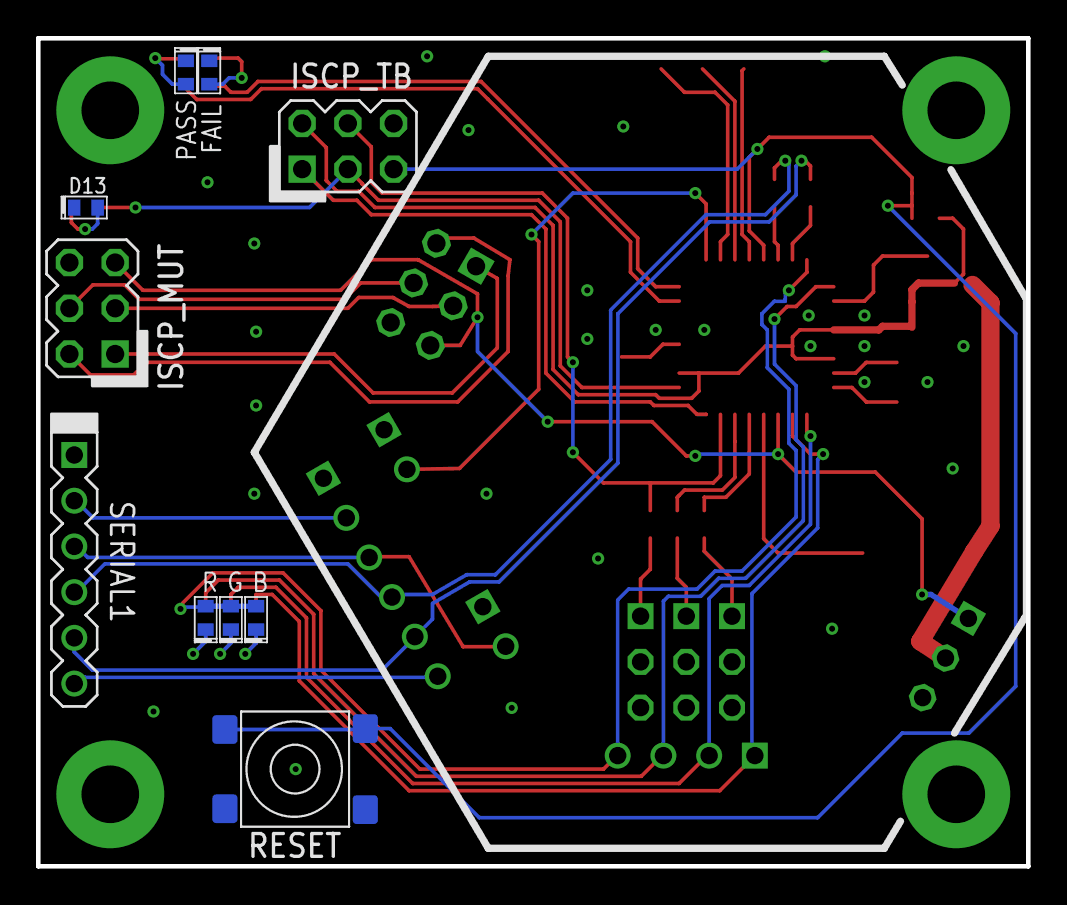
[picture p68: board brain-test.brd from below]

Board: 2 copper layers, 55.0 x 46.0 mm, 45 parts (10 on the bottom side), 44 nets.
