robotarmyllc/light-play/hardware/brain-board/pcb/brain.brd

## EAGLE design hardware/brain-board/pcb/brain.brd (2022-09-13)

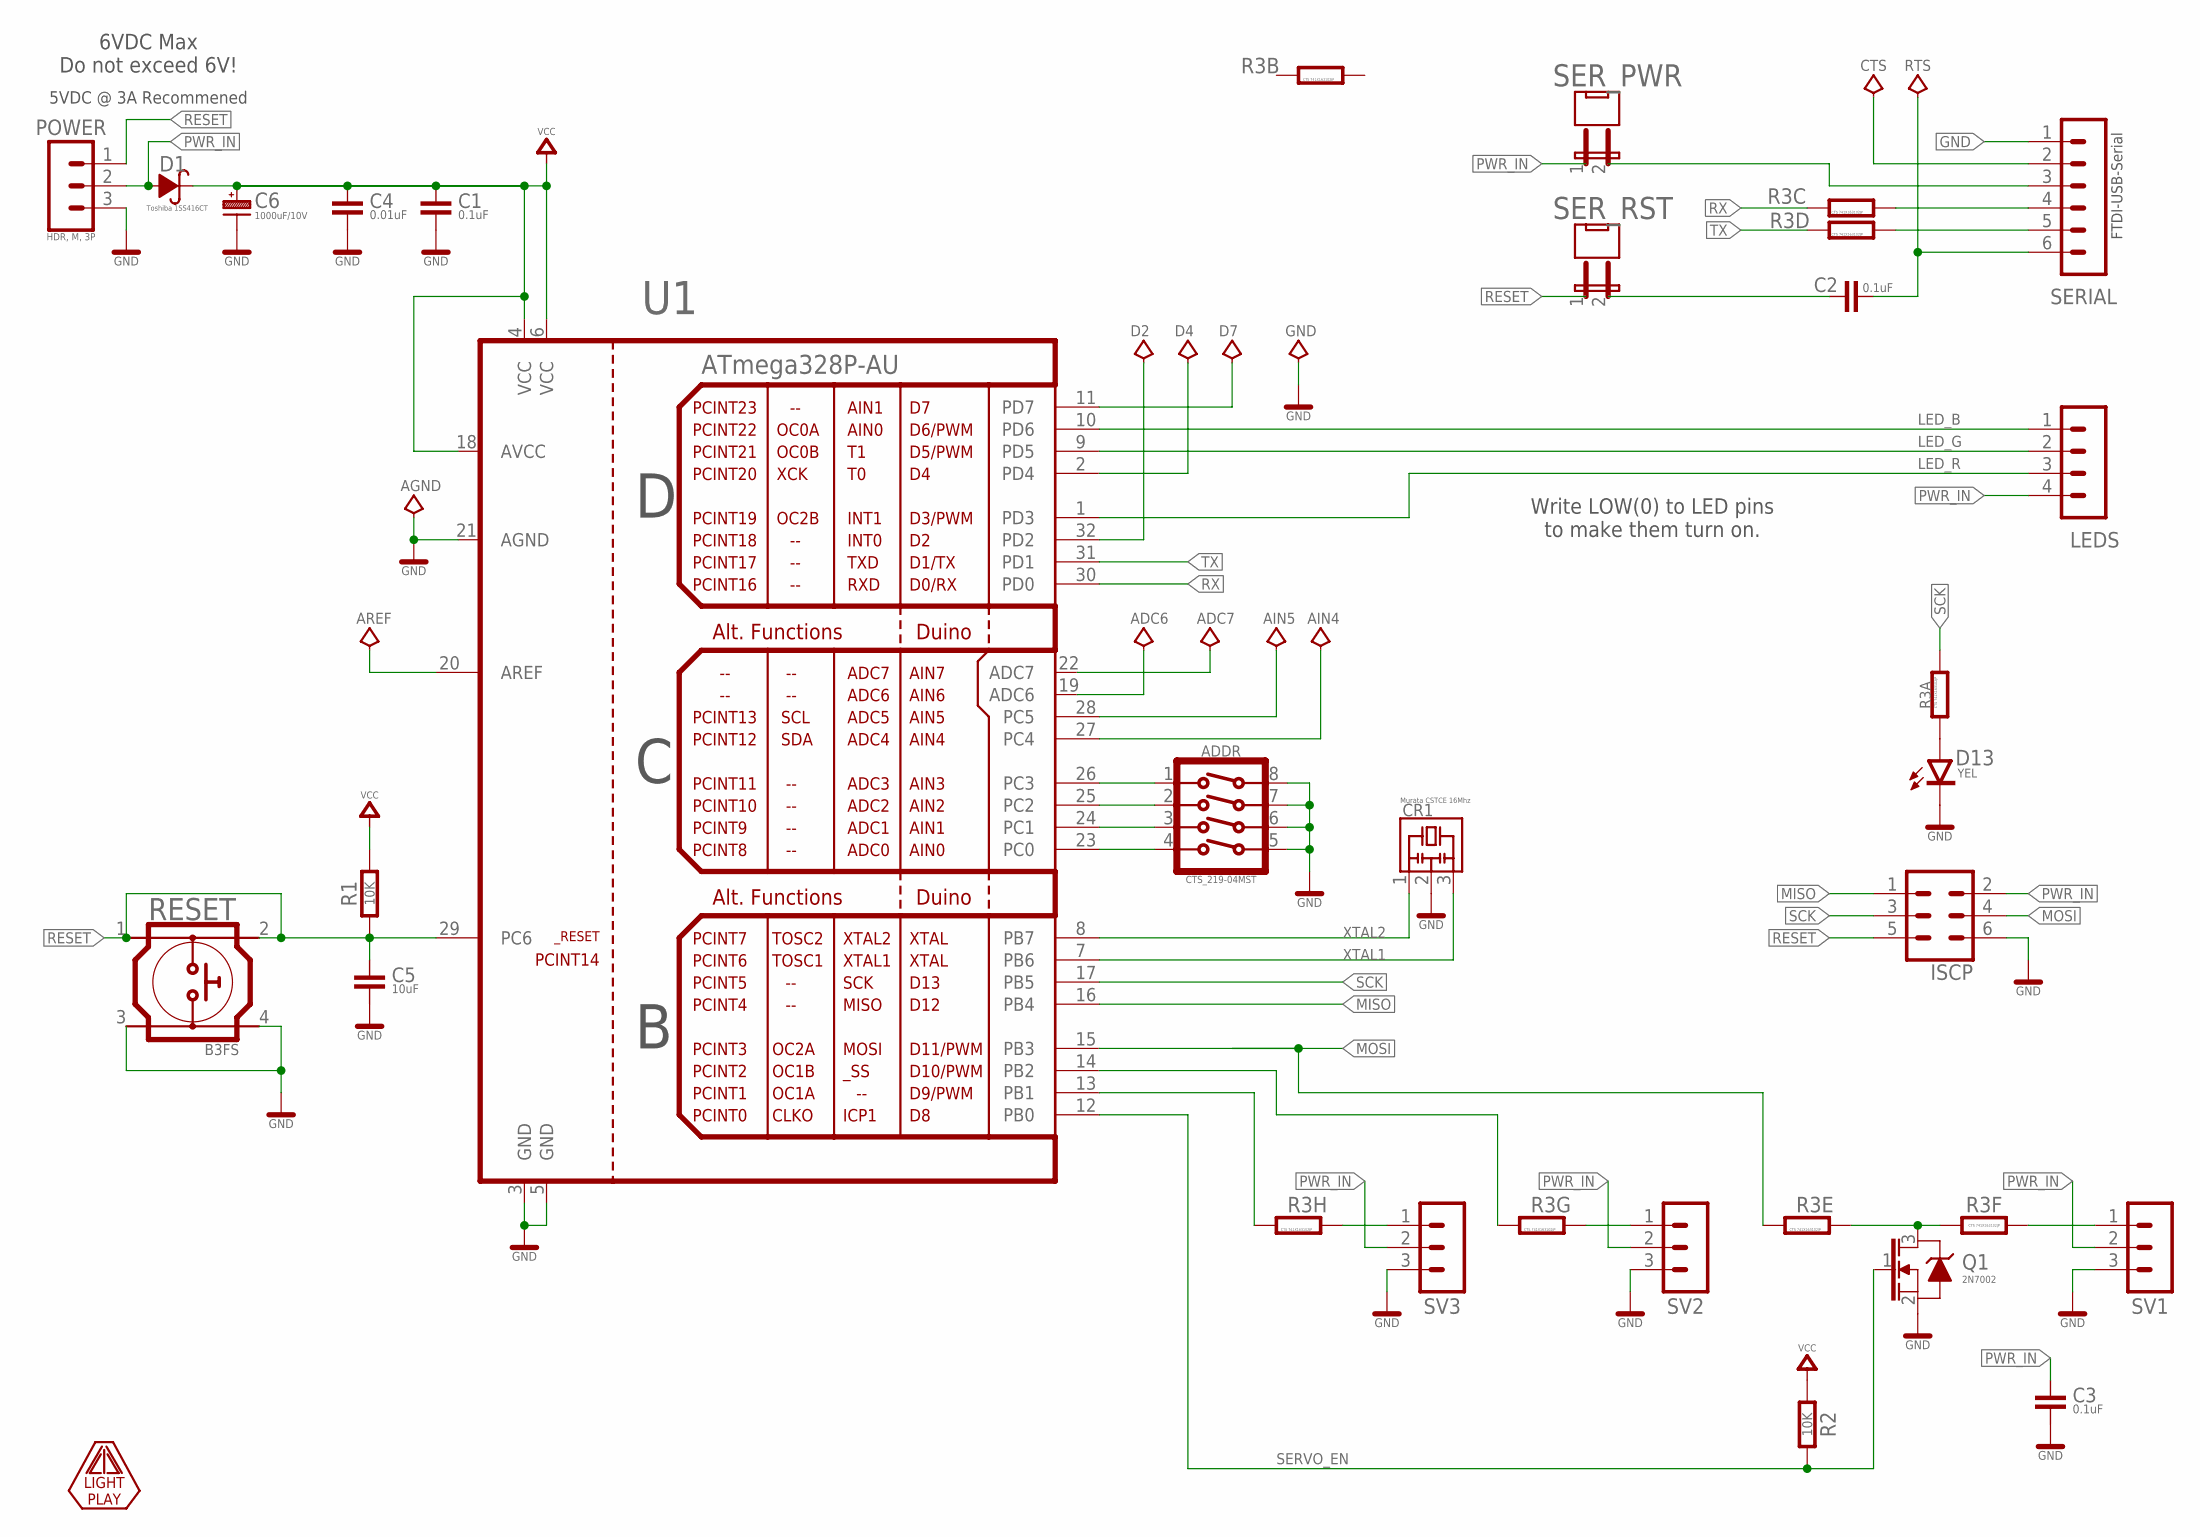
[picture p69: schematic brain.sch]

Parts:
ADC6, ADC7: TEST_POINT_SM_2X2; TP-SMT-020X020
ADDR: CTS_219-04MST; CTS_4P_GULLWING
AGND: TEST_POINT_SM_2X2; TP-SMT-020X020
AIN4, AIN5: TEST_POINT_SM_2X2; TP-SMT-020X020
AREF: TEST_POINT_SM_2X2; TP-SMT-020X020
C1, C2, C3: 0.1uF; 0603
C4: 0.01uF; 0603
C5: 10uF; 0805
C6: 1000uF/10V; CAP_ALUM_THD_8
CR1: Murata CSTCE 16Mhz; MURATA_CSTCE
CTS: TEST_POINT_SM_2X2; TP-SMT-020X020
D1: Toshiba 1SS416CT; CST2
D2, D4, D7: TEST_POINT_SM_2X2; TP-SMT-020X020
D13: YEL; SMD_0603
GND: TEST_POINT_SM_2X2; TP-SMT-020X020
ISCP: MA03-2
LEDS: MA04-1
LOGO2: LIGHT_PLAY_20MM; LIGHTPLAY_20MM
POWER: HDR, M, 3P; MA03-1
Q1: 2N7002; SOT-23
R1, R2: 10K; 0603
R3: CTS 741X163102JP; RESNET_0402_X8
RESET: B3FS
RTS: TEST_POINT_SM_2X2; TP-SMT-020X020
SERIAL: MA06-1
SER_PWR: JMP01VT; MA02-1-FAT
SER_RST: JMP01VT; MA02-1-FAT
SV1, SV2, SV3: MA03-1
U1: ATmega328P-AU; TQFP-32-08

Connections:
AREF: AREF.1, U1.20 (AREF)
CTS: CTS.1, SERIAL.2
GND: ADDR.5, ADDR.6, ADDR.7, ADDR.8, AGND.1, C1.2, C3.2, C4.2, C5.2, C6.N, CR1.2, D13.K (C), GND.1, ISCP.6, POWER.3, Q1.2 (S), RESET.3, RESET.4, SERIAL.1, SV1.3, SV2.3, SV3.3, U1.3 (GND), U1.5 (GND), U1.21 (AGND)
LED_B: LEDS.1, U1.10 (PD6)
LED_G: LEDS.2, U1.9 (PD5)
LED_R: LEDS.3, U1.1 (PD3)
MISO: ISCP.1, U1.16 (PB4)
MOSI: ISCP.4, R3.5 (1), U1.15 (PB3)
unnamed: D2.1, U1.32 (PD2)
unnamed: R3.6 (1), SV1.1
unnamed: D4.1, U1.2 (PD4)
unnamed: ADDR.1, U1.26 (PC3)
unnamed: R3.9 (2), SV3.1
unnamed: D7.1, U1.11 (PD7)
unnamed: ADC6.1, U1.19 (ADC6)
unnamed: ADC7.1, U1.22 (ADC7)
unnamed: R3.10 (2), SV2.1
unnamed: Q1.3 (D), R3.11 (2), R3.12 (2)
unnamed: AIN5.1, U1.28 (PC5)
unnamed: AIN4.1, U1.27 (PC4)
unnamed: C2.1, SER_RST.2
unnamed: D13.A, R3.16 (2)
unnamed: R3.7 (1), U1.14 (PB2)
unnamed: R3.8 (1), U1.13 (PB1)
unnamed: ADDR.2, U1.25 (PC2)
unnamed: ADDR.3, U1.24 (PC1)
unnamed: ADDR.4, U1.23 (PC0)
PWR_IN: C3.1, D1.A, ISCP.2, LEDS.4, POWER.2, SER_PWR.1, SV1.2, SV2.2, SV3.2
RESET: C5.1, ISCP.5, POWER.1, R1.1, RESET.1, RESET.2, SER_RST.1, U1.29 (PC6)
RTS: C2.2, RTS.1, SERIAL.6
RX: R3.3 (1), U1.30 (PD0)
RXD: R3.13 (2), SERIAL.5
SCK: ISCP.3, R3.1, U1.17 (PB5)
SERVO_EN: Q1.1 (G), R2.2, U1.12 (PB0)
TX: R3.4 (1), U1.31 (PD1)
TXD: R3.14 (2), SERIAL.4
VCC: C1.1, C4.1, C6.P, D1.K, R1.2, R2.1, U1.4 (VCC), U1.6 (VCC), U1.18 (AVCC)
VCC5: SERIAL.3, SER_PWR.2
XTAL1: CR1.3, U1.7 (PB6)
XTAL2: CR1.1, U1.8 (PB7)

Notes on the sheet:
FTDI-USB-Serial
Write LOW(0) to LED pins to make them turn on.
6VDC Max Do not exceed 6V!
5VDC @ 3A Recommened

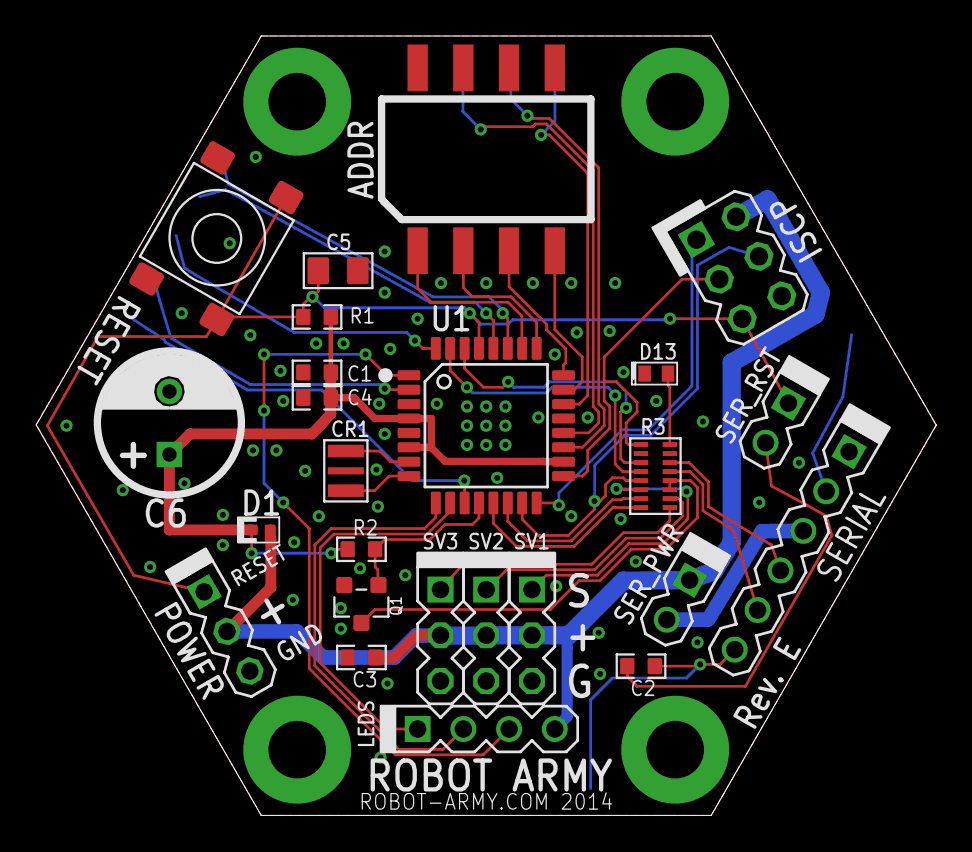
[picture p70: board brain.brd from above]

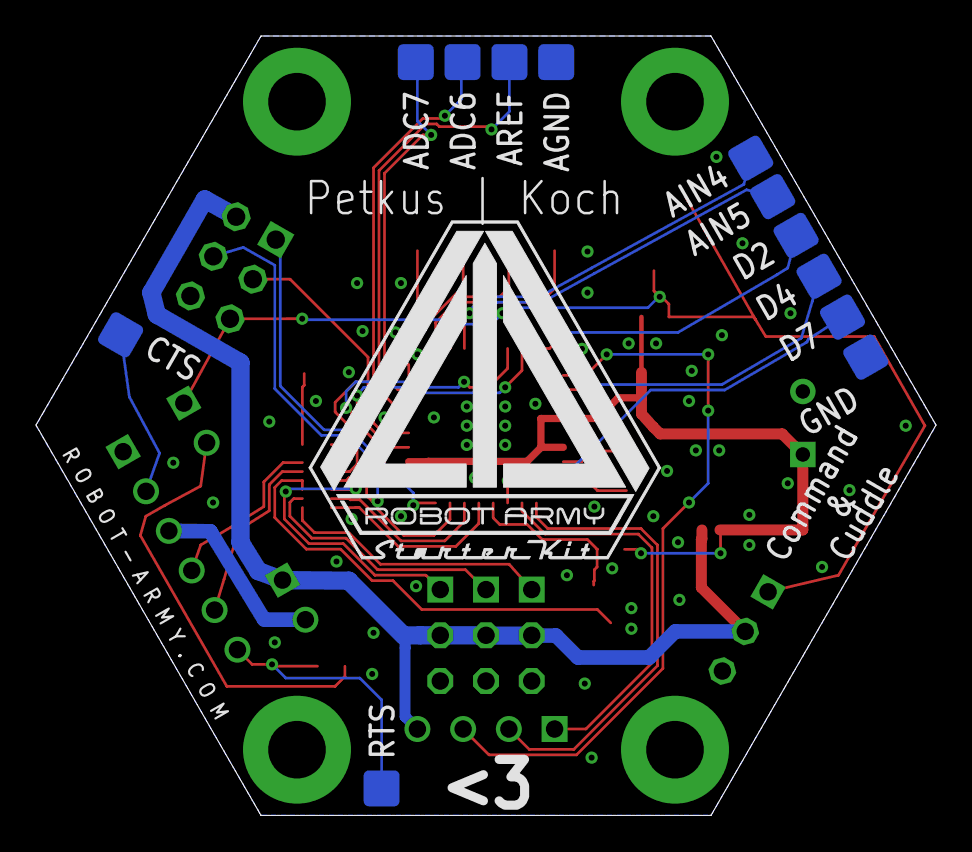
[picture p71: board brain.brd from below]

Board: 2 copper layers, 50.0 x 43.3 mm, 38 parts (13 on the bottom side), 40 nets.
