robotarmyllc/light-play/hardware/kit/led-pcb/pcb/LP-LED-panelized.brd

## EAGLE design hardware/kit/led-pcb/pcb/LP-LED-panelized.brd (2022-09-13)

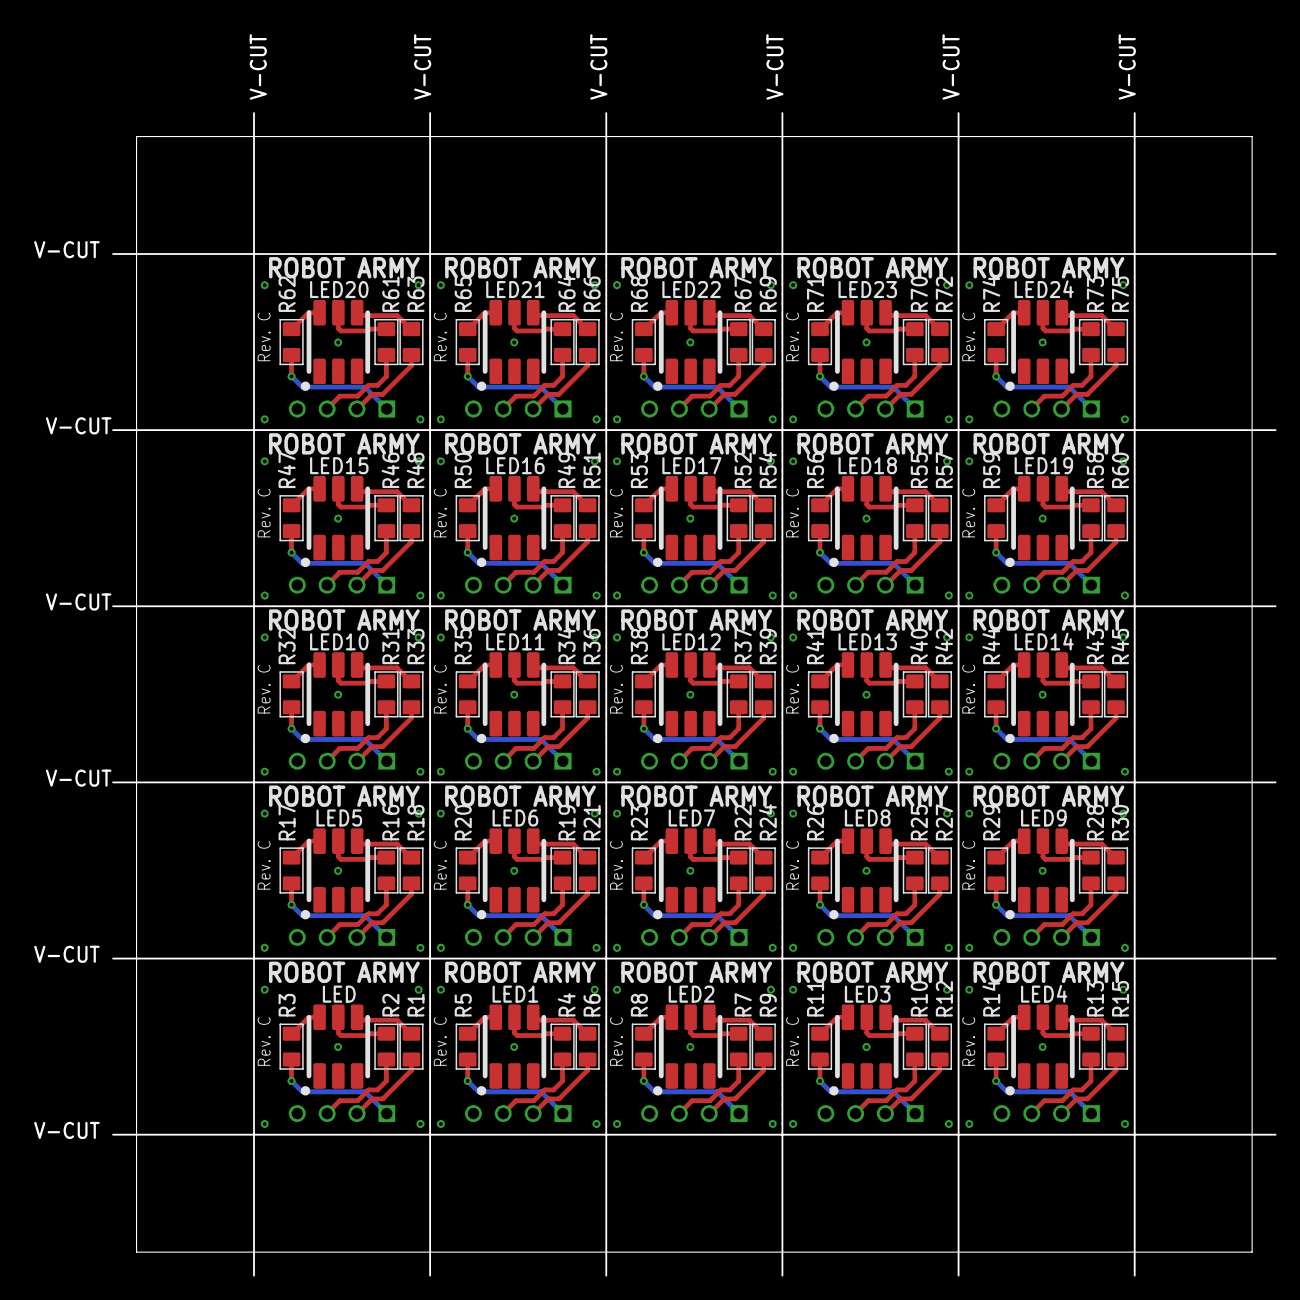
[picture p72: board LP-LED-panelized.brd from above]

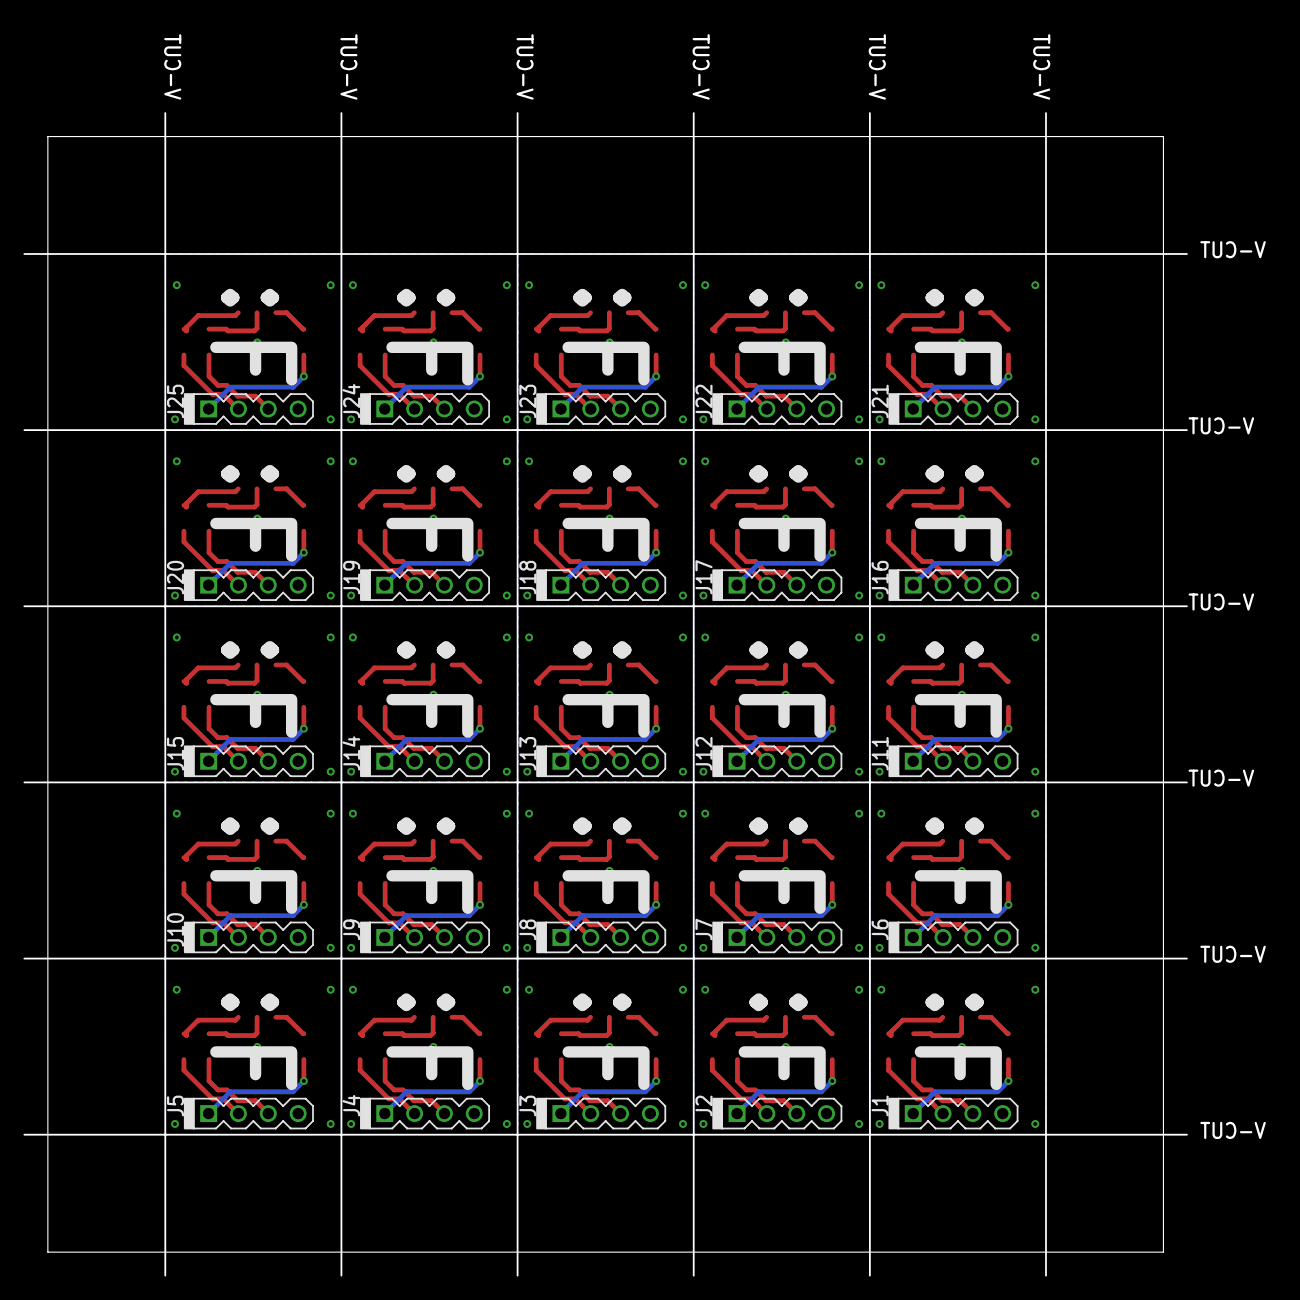
[picture p73: board LP-LED-panelized.brd from below]

Board: 2 copper layers, 99.0 x 99.0 mm, 125 parts (25 on the bottom side), 175 nets.

Parts:
J1, J2, J3, J4, J5, J6, J7, J8, J9, J10, J11, J12, J13, J14, J15, J16, J17, J18, J19, J20, J21, J22, J23, J24, J25: MA04-1
LED, LED1, LED2, LED3, LED4, LED5, LED6, LED7, LED8, LED9, LED10, LED11, LED12, LED13, LED14, LED15, LED16, LED17, LED18, LED19, LED20, LED21, LED22, LED23, LED24: PLCC-6
R1, R3, R5, R6, R8, R9, R11, R12, R14, R15, R17, R18, R20, R21, R23, R24, R26, R27, R29, R30, R32, R33, R35, R36, R38, R39, R41, R42, R44, R45, R47, R48, R50, R51, R53, R54, R56, R57, R59, R60, R62, R63, R65, R66, R68, R69, R71, R72, R74, R75: 133; 0805
R2, R4, R7, R10, R13, R16, R19, R22, R25, R28, R31, R34, R37, R40, R43, R46, R49, R52, R55, R58, R61, R64, R67, R70, R73: 200; 0805

Connections:
COMMON: J1.4, LED.1, LED.2, LED.3
COMMON1: J2.4, LED1.1, LED1.2, LED1.3
COMMON2: J3.4, LED2.1, LED2.2, LED2.3
COMMON3: J4.4, LED3.1, LED3.2, LED3.3
COMMON4: J5.4, LED4.1, LED4.2, LED4.3
COMMON5: J6.4, LED5.1, LED5.2, LED5.3
COMMON6: J7.4, LED6.1, LED6.2, LED6.3
COMMON7: J8.4, LED7.1, LED7.2, LED7.3
COMMON8: J9.4, LED8.1, LED8.2, LED8.3
COMMON9: J10.4, LED9.1, LED9.2, LED9.3
COMMON10: J11.4, LED10.1, LED10.2, LED10.3
COMMON11: J12.4, LED11.1, LED11.2, LED11.3
COMMON12: J13.4, LED12.1, LED12.2, LED12.3
COMMON13: J14.4, LED13.1, LED13.2, LED13.3
COMMON14: J15.4, LED14.1, LED14.2, LED14.3
COMMON15: J16.4, LED15.1, LED15.2, LED15.3
COMMON16: J17.4, LED16.1, LED16.2, LED16.3
COMMON17: J18.4, LED17.1, LED17.2, LED17.3
COMMON18: J19.4, LED18.1, LED18.2, LED18.3
COMMON19: J20.4, LED19.1, LED19.2, LED19.3
COMMON20: J21.4, LED20.1, LED20.2, LED20.3
COMMON21: J22.4, LED21.1, LED21.2, LED21.3
COMMON22: J23.4, LED22.1, LED22.2, LED22.3
COMMON23: J24.4, LED23.1, LED23.2, LED23.3
COMMON24: J25.4, LED24.1, LED24.2, LED24.3
unnamed: LED.4, R1.2
unnamed: J1.3, R2.1
unnamed: LED.6, R3.2
unnamed: LED.5, R2.2
unnamed: J1.2, R1.1
unnamed: J1.1, R3.1
unnamed: LED1.6, R5.2
unnamed: J2.1, R5.1
unnamed: J2.2, R6.1
unnamed: LED1.4, R6.2
unnamed: J2.3, R4.1
unnamed: LED1.5, R4.2
unnamed: LED2.6, R8.2
unnamed: J3.1, R8.1
unnamed: J3.2, R9.1
unnamed: LED2.4, R9.2
unnamed: J3.3, R7.1
unnamed: LED2.5, R7.2
unnamed: LED3.6, R11.2
unnamed: J4.1, R11.1
unnamed: J4.2, R12.1
unnamed: LED3.4, R12.2
unnamed: J4.3, R10.1
unnamed: LED3.5, R10.2
unnamed: LED4.6, R14.2
unnamed: J5.1, R14.1
unnamed: J5.2, R15.1
unnamed: LED4.4, R15.2
unnamed: J5.3, R13.1
unnamed: LED4.5, R13.2
unnamed: LED5.6, R17.2
unnamed: J6.1, R17.1
unnamed: J6.2, R18.1
unnamed: LED5.4, R18.2
unnamed: J6.3, R16.1
unnamed: LED5.5, R16.2
unnamed: LED6.6, R20.2
unnamed: J7.1, R20.1
unnamed: J7.2, R21.1
unnamed: LED6.4, R21.2
unnamed: J7.3, R19.1
unnamed: LED6.5, R19.2
unnamed: LED7.6, R23.2
unnamed: J8.1, R23.1
unnamed: J8.2, R24.1
unnamed: LED7.4, R24.2
unnamed: J8.3, R22.1
unnamed: LED7.5, R22.2
unnamed: LED8.6, R26.2
unnamed: J9.1, R26.1
unnamed: J9.2, R27.1
unnamed: LED8.4, R27.2
unnamed: J9.3, R25.1
unnamed: LED8.5, R25.2
unnamed: LED9.6, R29.2
unnamed: J10.1, R29.1
unnamed: J10.2, R30.1
unnamed: LED9.4, R30.2
unnamed: J10.3, R28.1
unnamed: LED9.5, R28.2
unnamed: LED10.6, R32.2
unnamed: J11.1, R32.1
unnamed: J11.2, R33.1
unnamed: LED10.4, R33.2
unnamed: J11.3, R31.1
unnamed: LED10.5, R31.2
unnamed: LED11.6, R35.2
unnamed: J12.1, R35.1
unnamed: J12.2, R36.1
unnamed: LED11.4, R36.2
unnamed: J12.3, R34.1
unnamed: LED11.5, R34.2
unnamed: LED12.6, R38.2
unnamed: J13.1, R38.1
unnamed: J13.2, R39.1
unnamed: LED12.4, R39.2
unnamed: J13.3, R37.1
unnamed: LED12.5, R37.2
unnamed: LED13.6, R41.2
unnamed: J14.1, R41.1
unnamed: J14.2, R42.1
unnamed: LED13.4, R42.2
unnamed: J14.3, R40.1
unnamed: LED13.5, R40.2
unnamed: LED14.6, R44.2
unnamed: J15.1, R44.1
unnamed: J15.2, R45.1
unnamed: LED14.4, R45.2
unnamed: J15.3, R43.1
unnamed: LED14.5, R43.2
unnamed: LED15.6, R47.2
unnamed: J16.1, R47.1
unnamed: J16.2, R48.1
unnamed: LED15.4, R48.2
unnamed: J16.3, R46.1
unnamed: LED15.5, R46.2
unnamed: LED16.6, R50.2
unnamed: J17.1, R50.1
unnamed: J17.2, R51.1
unnamed: LED16.4, R51.2
unnamed: J17.3, R49.1
unnamed: LED16.5, R49.2
unnamed: LED17.6, R53.2
unnamed: J18.1, R53.1
unnamed: J18.2, R54.1
unnamed: LED17.4, R54.2
unnamed: J18.3, R52.1
unnamed: LED17.5, R52.2
unnamed: LED18.6, R56.2
unnamed: J19.1, R56.1
unnamed: J19.2, R57.1
unnamed: LED18.4, R57.2
unnamed: J19.3, R55.1
unnamed: LED18.5, R55.2
unnamed: LED19.6, R59.2
unnamed: J20.1, R59.1
unnamed: J20.2, R60.1
unnamed: LED19.4, R60.2
unnamed: J20.3, R58.1
unnamed: LED19.5, R58.2
unnamed: LED20.6, R62.2
unnamed: J21.1, R62.1
unnamed: J21.2, R63.1
unnamed: LED20.4, R63.2
unnamed: J21.3, R61.1
unnamed: LED20.5, R61.2
unnamed: LED21.6, R65.2
unnamed: J22.1, R65.1
unnamed: J22.2, R66.1
unnamed: LED21.4, R66.2
unnamed: J22.3, R64.1
unnamed: LED21.5, R64.2
unnamed: LED22.6, R68.2
unnamed: J23.1, R68.1
unnamed: J23.2, R69.1
unnamed: LED22.4, R69.2
unnamed: J23.3, R67.1
unnamed: LED22.5, R67.2
unnamed: LED23.6, R71.2
unnamed: J24.1, R71.1
unnamed: J24.2, R72.1
unnamed: LED23.4, R72.2
unnamed: J24.3, R70.1
unnamed: LED23.5, R70.2
unnamed: LED24.6, R74.2
unnamed: J25.1, R74.1
unnamed: J25.2, R75.1
unnamed: LED24.4, R75.2
unnamed: J25.3, R73.1
unnamed: LED24.5, R73.2
