robotarmyllc/light-play/software/DMX/Firmware/BrainBoard/BrainBoard.h

#ifndef CC_SDK_H
#define CC_SDK_H
#ifdef MAINFILE
    #define EXTERN
#else
    #define EXTERN extern
#endif

#include "DeltaBrain.h"
#include "DeltaServos.h"
#include "DeltaKinetics.h"

#include "Arduino.h"

EXTERN  DeltaBrain    brain;
EXTERN  DeltaKinetics delta;
EXTERN  DeltaServos   servos;

#endif
