robotarmyllc/light-play/(commit log)

2022-09-13 rev-a pcb
    [brain.brd, brain.sch]
2022-09-13 Brain Rev B
    [BOM.ods, brain.brd, brain.sch]
2022-09-13 rev-c board
    [BOM.ods, brain.brd, brain.sch]
2022-09-13 rev-d board
    [BOM.ods, brain.brd, brain.sch]
2022-09-13 rev-e board
    [BOM.ods, brain.brd, brain.sch]
2022-09-13 added brain test fixture
    [brain-test.brd, brain-test.sch]
2022-09-13 DMX A-type board - rev a
    [DMX-A.brd, DMX-A.sch]
2022-09-13 DMX a-type board rev B
    [dmx-a-rev-b-bom.ods]
2022-09-13 DMX type-B board. Rev. A
    [DMX-B.brd, DMX-B.sch]
2022-09-13 hardware kit things
    [BlackLightStand.stl, RA-C001-A.brd, RA-C001-A.sch, RA-C002-A.brd, RA-C002-A.sch]
2022-09-13 led pcb rev-a
    [LP-LED.brd, LP-LED.sch, RobotArmy-Kit-BOM.ods]
2022-09-13 rev-b pcb
    [LP-LED.brd, LP-LED.sch]
2022-09-13 rev-c pcb
    [LP-LED-panelized.brd, LP-LED.brd]
2022-09-13 DMX cat5 connector board
    [serial-receiver.brd, serial-receiver.sch]
2022-09-13 DMX cat5 board rev-b
    [bom.ods, serial-receiver.brd, serial-receiver.sch]
2022-09-13 random mechanical stuff
    [AC-Inlet-v01.stl, AC-Inlet-v01b.stl, Arm Curved-2019 v2.stl, BlackLightStand.stl, DMX-A-bracket_v01.stl, DMX-A-bracket_v02.stl, Lower.dxf, P-test1.stl]
2022-09-13 refactor and merge repositories
    [AC-Inlet-v01.stl, AC-Inlet-v01b.stl, Arm Curved-2019 v2.stl, DMX-A-bracket_v01.stl, DMX-A-bracket_v02.stl, Lower.dxf, RobotArmy-4x8-sheet.dxf, RobotArmy-Lower.dxf]
