robotarmyllc/light-play/(notices)

Notices in the files:
hardware/kit/led-cable/CAD/RA-C002-A.sch:
Copyright 2014 - Robot Army LLC
